marekw1986/InternetRadioPIC32DP83848/TODO.md

# Internet Radio PIC32
Internet radio based on PIC32

### Tasks
- [ ] Write WebUI
  - [x] Write function printing audio files from given directory as json accessed with http server
  - [x] Add funcionality of printing "root" folder
  - [x] Add funcionality of reporting list of available streams
  - [x] Add contextual next button (play next stream or next file in directory)
  - [x] Add aditional info about currently played file or audio stream
  - [x] Add volume control
  - [x] Add option od setting loop flag
  - [ ] Add possibility to save config from web UI
  - [ ] Add reset from web UI
  - [ ] Option of adding streams to list
- [ ] Use busy flag instead delay in HD44780 driver
- [ ] Controll LCD backlight brightness with soft PWM
- [ ] Analyze ICY headers
	- [x] Implement basic funcionality
- [ ] Add RF tuner funcionality
	- [x] Design RF board
	- [ ] Port driver for si4735 chip
	- [ ] Write code responsible for controlling VS1053 line input
	- [ ] Add RF tuner support to LCD UI
	- [ ] Add RF tuner support to Web UI
- [ ] Add Home Assistant MQTT integration.
- [ ] Add support for m3u playlists
- [ ] Determine cause of ocassional failures of HTTP server/WebUI

### Completed Column ✓
- [x] Debug SD card
  - [x] Find out why SD card doesn't work when ENC28J60 is enabled
- [x] Find the reason why transfer from USB is slow, causing choppy playback
- [x] Implement circular buffer for audio data
- [x] Implement memory friendly HTTP header parser
- [x] Update FatFS library to the newest version
- [x] Determine why SPI Flash is so slow
- [x] Move list of streams to file
- [x] Move project from MLA to Harmony libraries
- [x] Add backlight timeout
- [x] Move HD44780 from I2C to GPIO bus
- [x] Determine cause of reset after VS1053_play_dir() call
- [x] Create HD44780 UI
  - [x] Show volume value
  - [x] Show currently played stream/file
  - [x] Create interactive menu
	- [x] Add option to select stream from list
	- [x] Add option to play file from local storage
    - [x] Add option to play entire directory from local storage
    - [x] Add support for back button
    - [x] Add feature to remember last position in dir menu
	- [x] Add option to change playback settings (for example playing in loop)
  - [x] Scrolled text (info about played song/stream)
  - [x] Determine cause of ocassional failures of network connectivity
