marekw1986/InternetRadioPIC32DP83848/hardware/io3.brd

## EAGLE design hardware/io3.brd (2025-08-22)

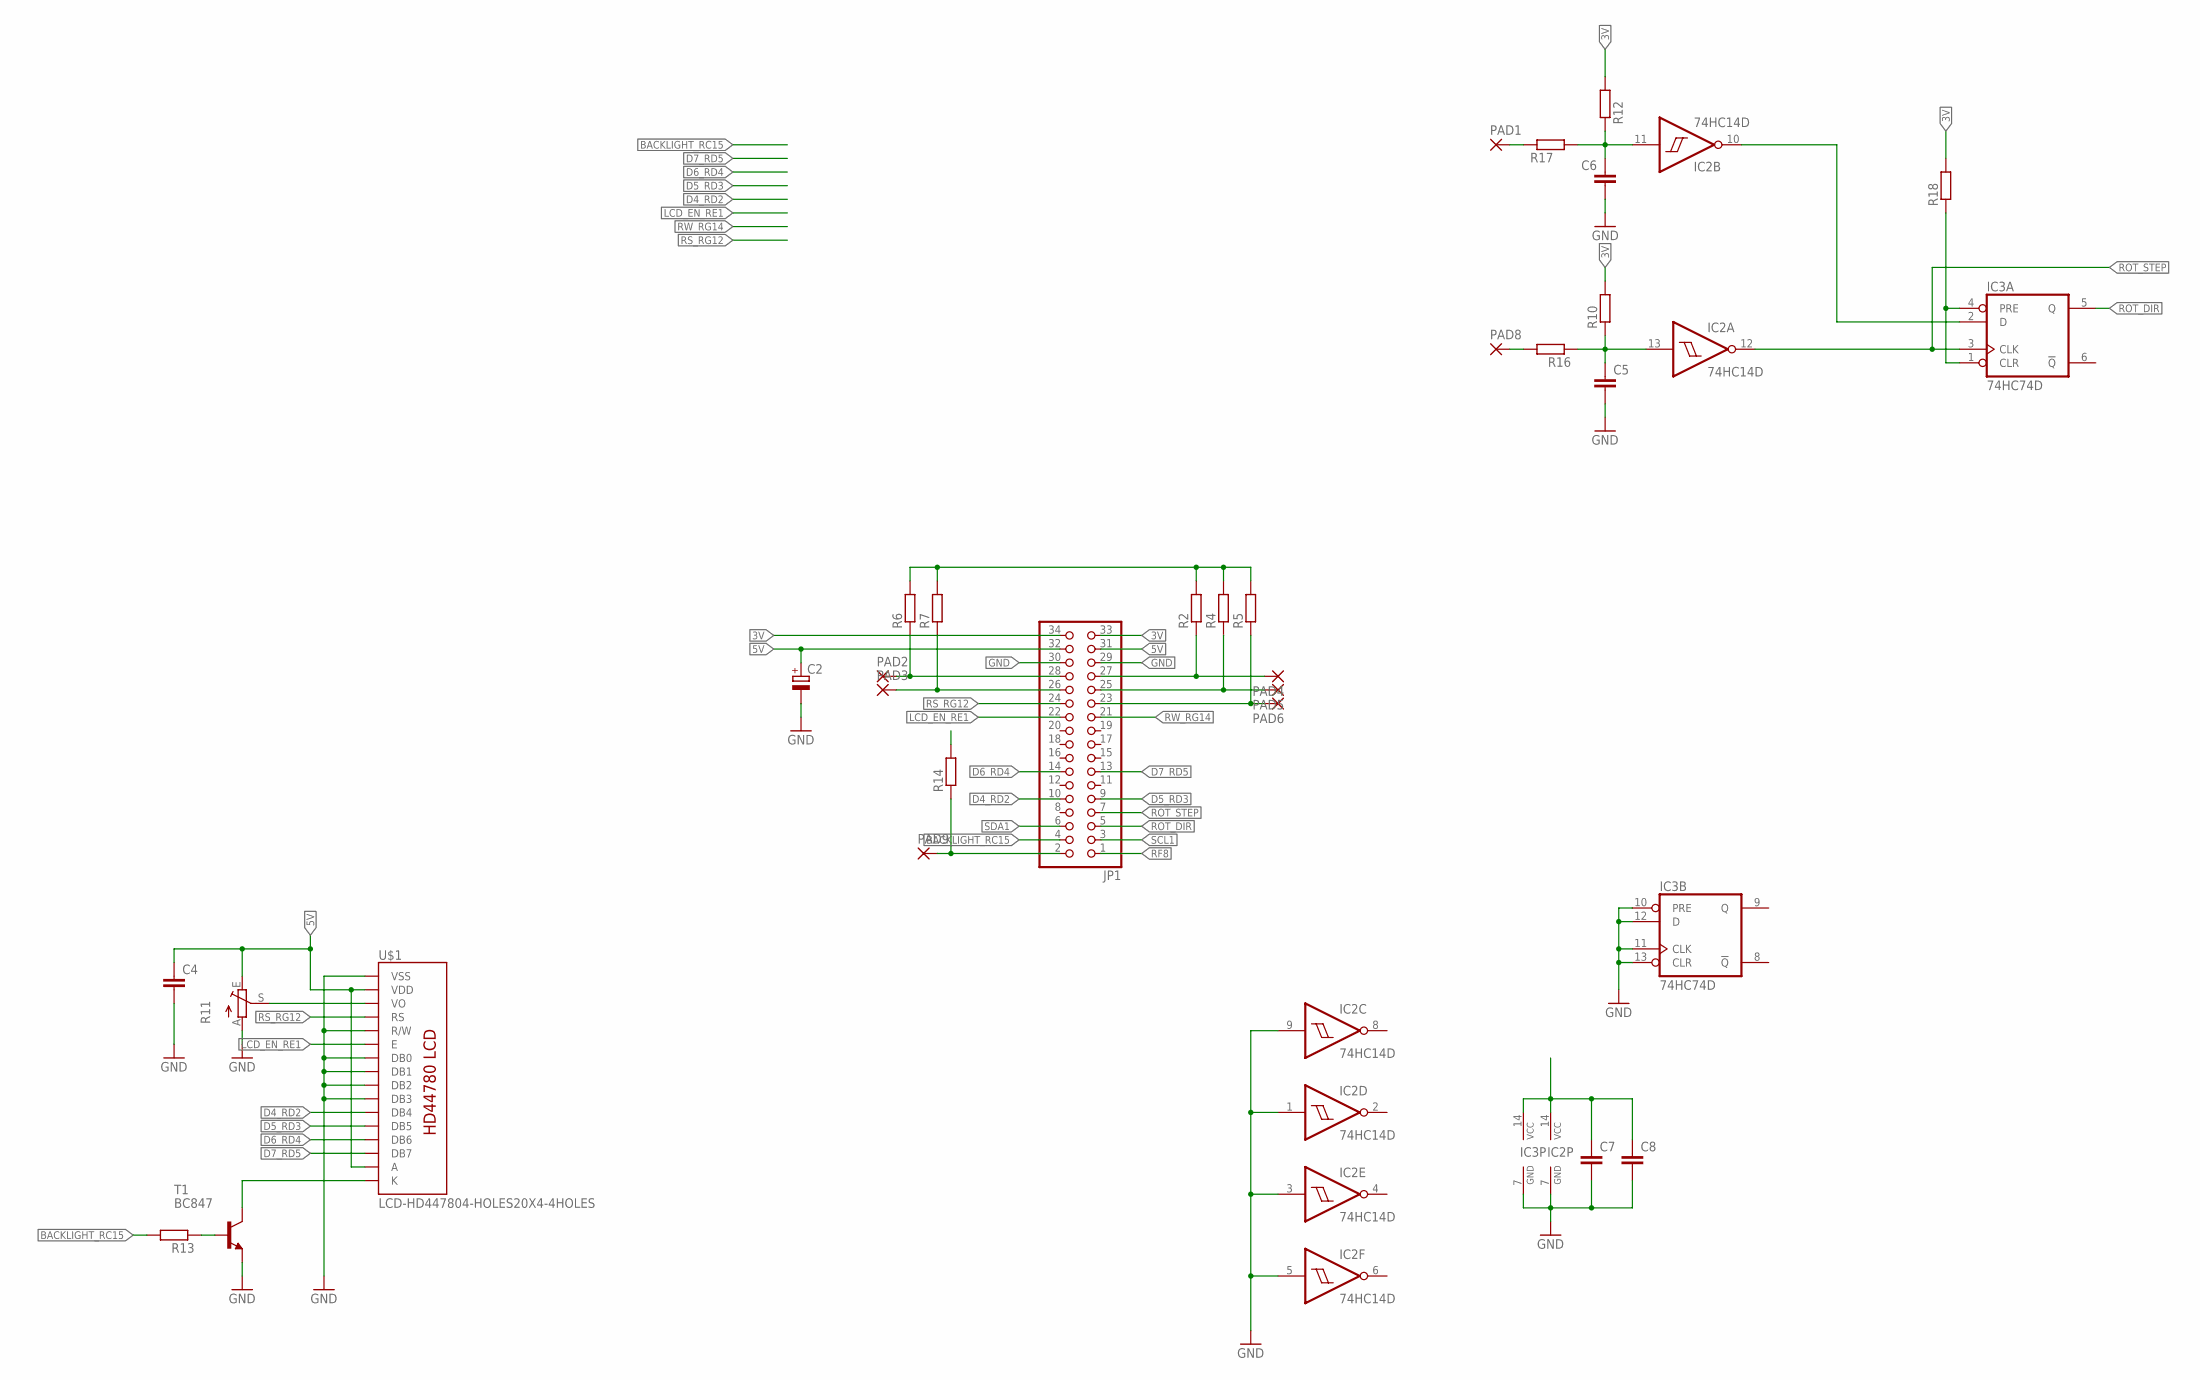
[picture p1: schematic io3.sch]

Parts:
C2: CPOL-EUSMCD; SMC_D
C4: C-EUC1206; C1206
C5, C6, C7, C8: C-EUC0603; C0603
IC2: 74HC14D; SO14
IC3: 74HC74D; SO14
JP1: PINHD-2X17_2.54-SMD; 2X17SMD
PAD1, PAD2, PAD3, PAD4, PAD5, PAD6, PAD8, PAD9: SMD2; SMD1,27-2,54
R2, R4, R5, R6, R7, R10, R12, R18: R-EU_0204/7; 0204/7
R11: TRIM_EU-B25U; B25U
R13, R14: R-EU_0204/5; 0204/5
R16, R17: R-EU_R0603; R0603
T1: BC847; SOT23
U$1: LCD-HD447804-HOLES20X4-4HOLES; LCD-20X4-4HOLES

Connections:
3V: C7.1, C8.1, IC2.14 (VCC), IC3.14 (VCC), JP1.33, JP1.34, R2.2, R4.2, R5.2, R6.2, R7.2, R10.2, R12.2, R14.2, R18.2
5V: C2.+, C4.1, JP1.31, JP1.32, R11.E, U$1.P$2 (VDD), U$1.P$15 (A)
BACKLIGHT_RC15: JP1.4, R13.2
D4_RD2: JP1.10, U$1.P$11 (DB4)
D5_RD3: JP1.9, U$1.P$12 (DB5)
D6_RD4: JP1.14, U$1.P$13 (DB6)
D7_RD5: JP1.13, U$1.P$14 (DB7)
GND: C2.-, C4.2, C5.2, C6.2, C7.2, C8.2, IC2.1 (I), IC2.3 (I), IC2.5 (I), IC2.7 (GND), IC2.9 (I), IC3.7 (GND), IC3.10 (PRE), IC3.11 (CLK), IC3.12 (D), IC3.13 (CLR), JP1.29, JP1.30, R11.A, T1.2 (E), U$1.P$1 (VSS), U$1.P$5 (R/W), U$1.P$7 (DB0), U$1.P$8 (DB1), U$1.P$9 (DB2), U$1.P$10 (DB3)
LCD_EN_RE1: JP1.22, U$1.P$6 (E)
unnamed: T1.3 (C), U$1.P$16 (K)
unnamed: IC3.1 (CLR), IC3.4 (PRE), R18.1
unnamed: PAD8.1, R16.2
unnamed: R13.1, T1.1 (B)
unnamed: PAD1.1, R17.1
unnamed: R11.S, U$1.P$3 (VO)
RF8: JP1.1
ROT_A_DT: C5.1, IC2.13 (I), R10.1, R16.1
ROT_B_: IC2.10 (O), IC3.2 (D)
ROT_B_CLK: C6.1, IC2.11 (I), R12.1, R17.2
ROT_DIR: IC3.5 (Q), JP1.5
ROT_STEP: IC2.12 (O), IC3.3 (CLK), JP1.7
ROT_SW: JP1.2, PAD9.1, R14.1
RS_RG12: JP1.24, U$1.P$4 (RS)
RW_RG14: JP1.21
S1: JP1.27, PAD4.1, R2.1
S2: JP1.28, PAD2.1, R6.1
S3: JP1.25, PAD5.1, R4.1
S4: JP1.26, PAD3.1, R7.1
S5: JP1.23, PAD6.1, R5.1
SCL1: JP1.3
SDA1: JP1.6

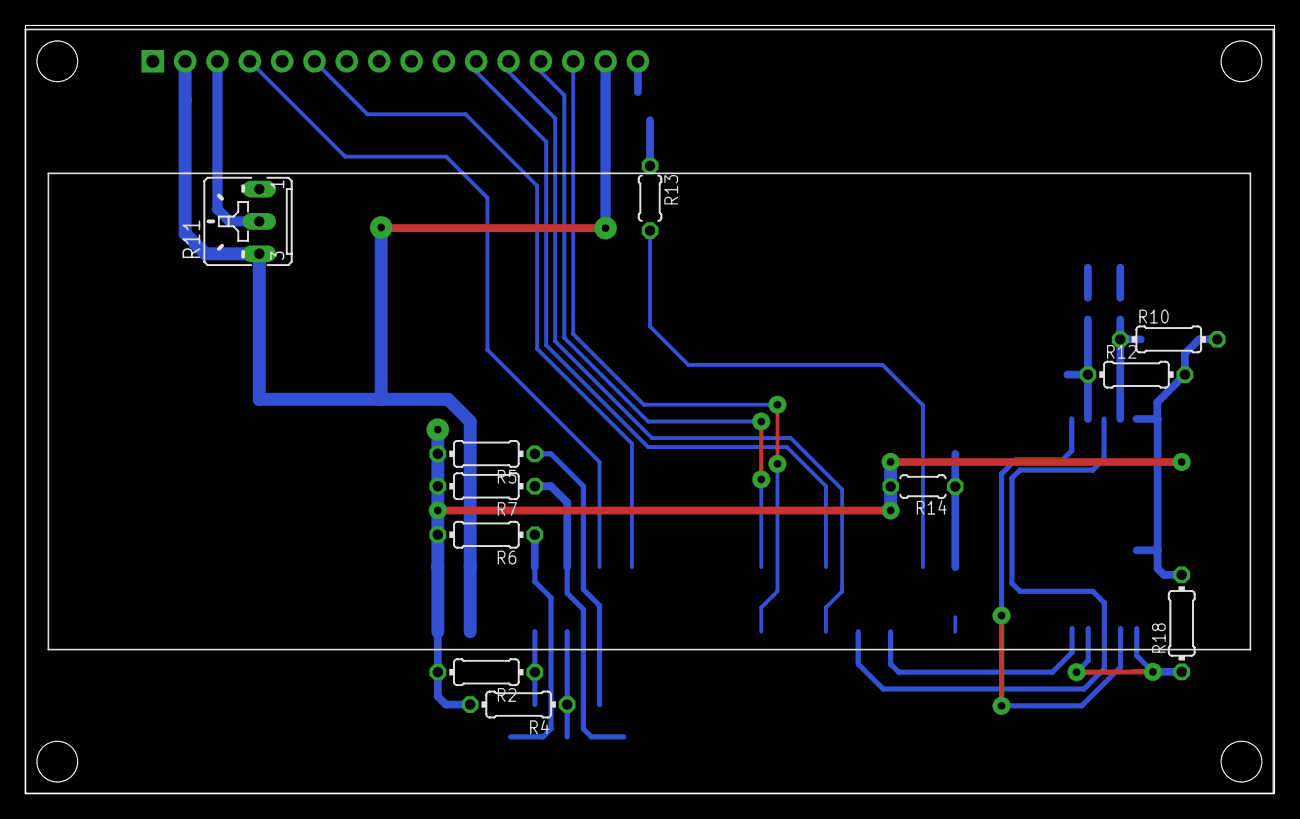
[picture p2: board io3.brd from above]

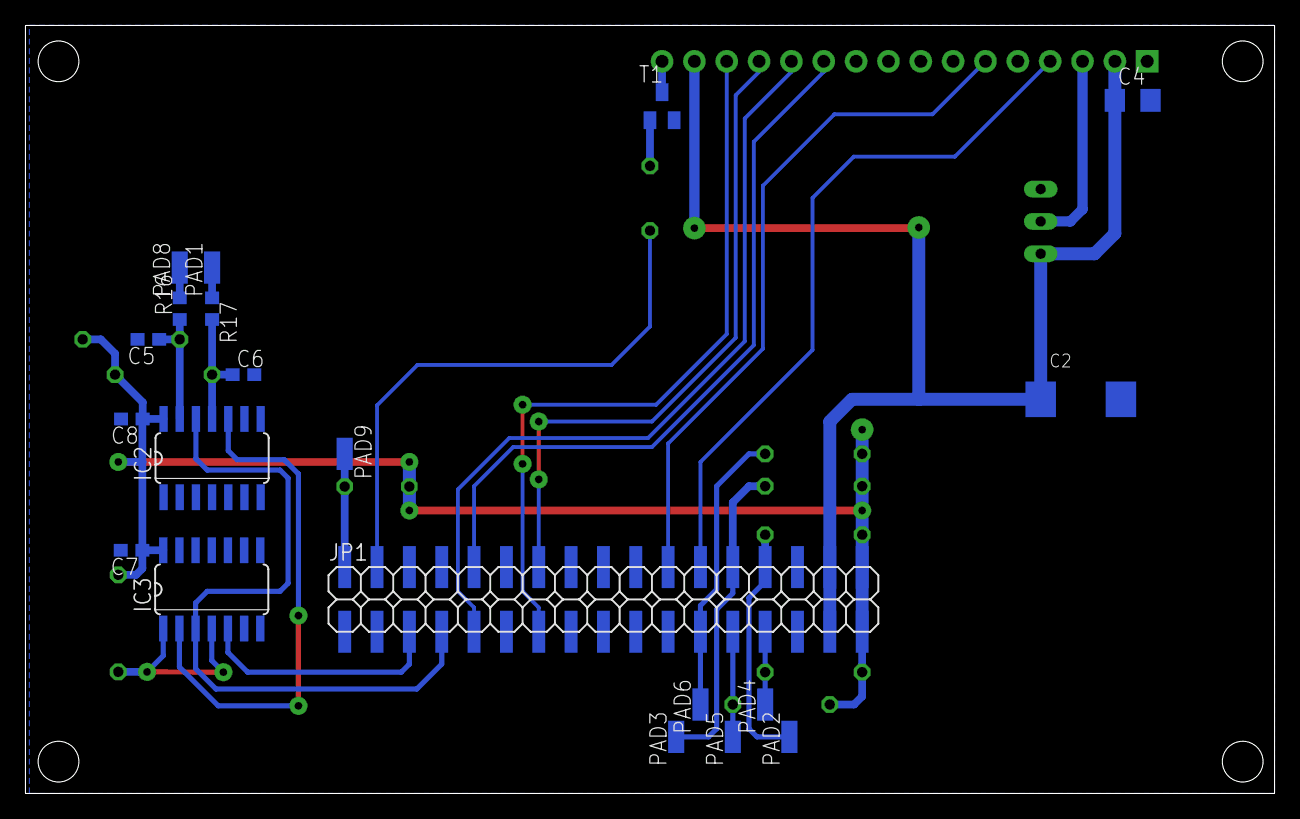
[picture p3: board io3.brd from below]

Board: 2 copper layers, 98.1 x 60.3 mm, 32 parts (20 on the bottom side), 27 nets.
