marekw1986/InternetRadioPIC32DP83848/hardware/rf_board.brd

## EAGLE design hardware/rf_board.brd (2025-08-22)

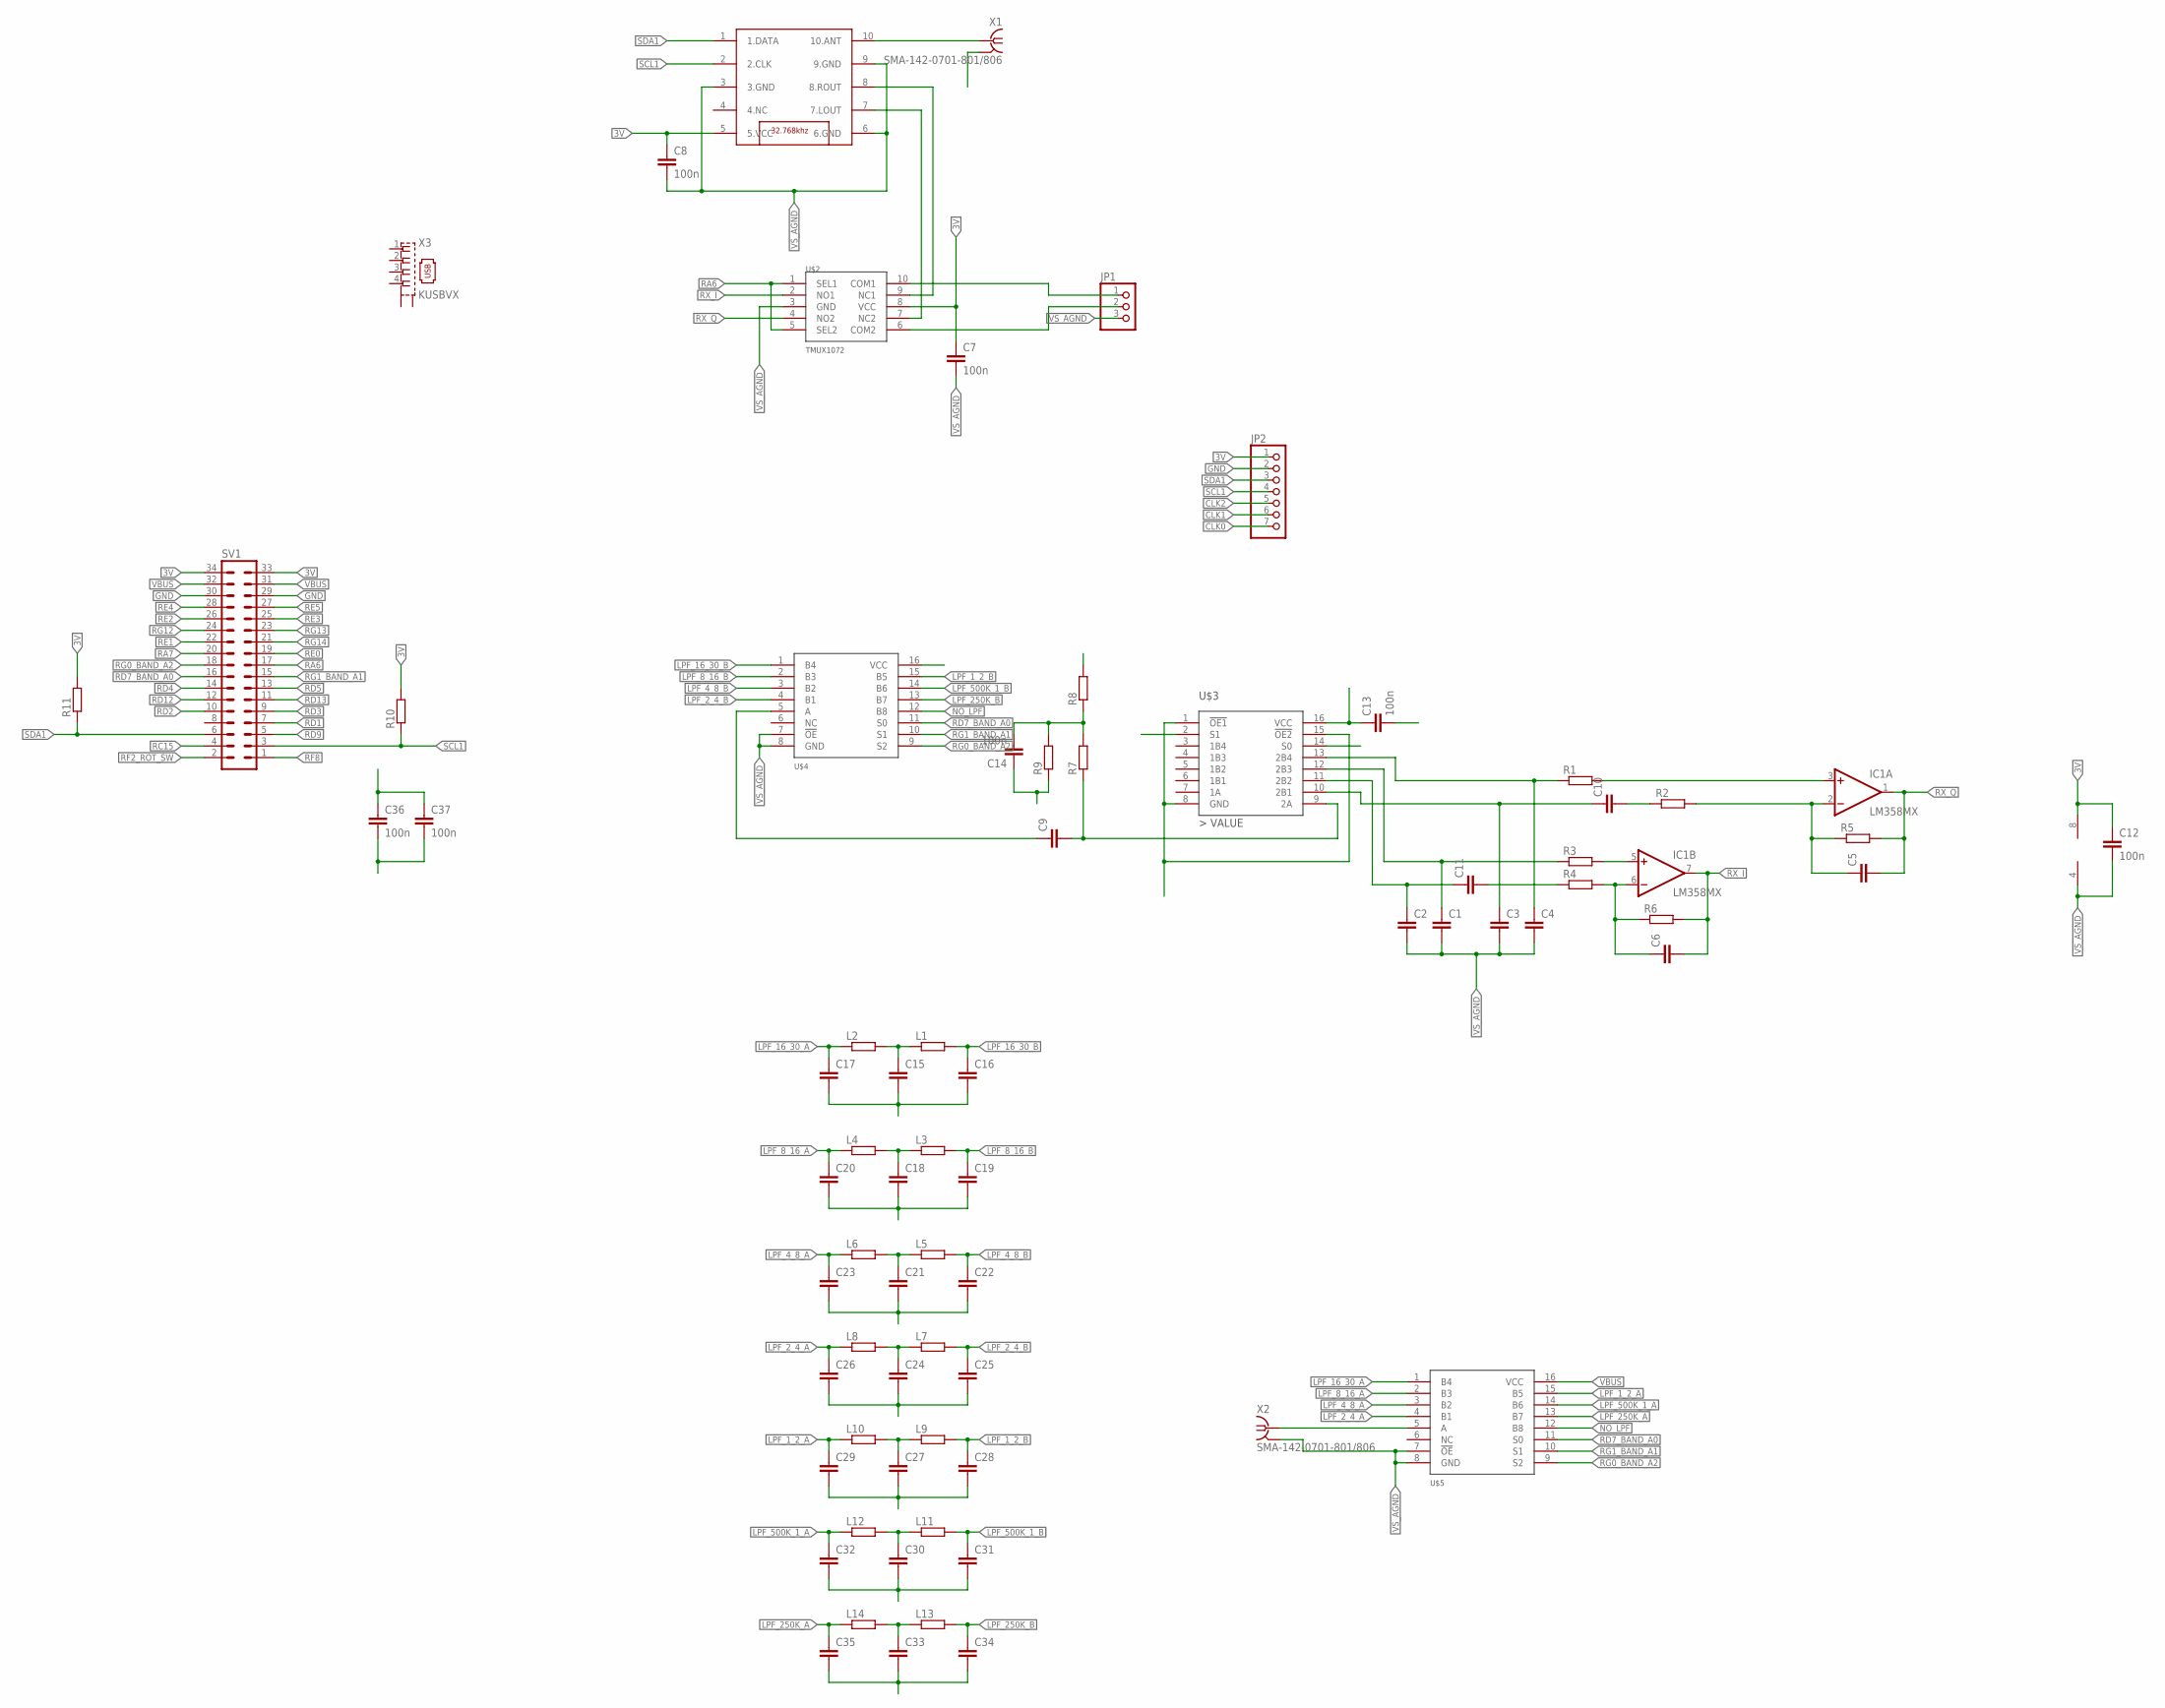
[picture p10: schematic rf_board.sch]

Parts:
C1, C2, C3, C4, C5, C6, C9, C10, C11: C-EUC0603; C0603
C7: 100n; C1206
C8, C12, C13, C14, C36, C37: 100n; C0603
C15, C16, C17, C18, C19, C20, C21, C22, C23, C24, C25, C26, C27, C28, C29, C30, C31, C32, C33, C34, C35: C-EUC0805; C0805
IC1: LM358MX; SO08
JP1: PINHD-1X3; 1X03
JP2: PINHD-1X7; 1X07
L1, L2, L3, L4, L5, L6, L7, L8, L9, L10, L11, L12, L13, L14: R-EU_R0805; R0805
R1, R2, R3, R4, R5, R6, R8, R9: R-EU_R0603; R0603
R7, R11: R-EU_0204/5; 0204/5
R10: R-EU_0204/7; 0204/7
SV1: ML34L
U$1: TEA5767; TJ-102BC
U$2: TMUX1072; TSSOP8
U$3: FST3253SO16; SO16
U$4, U$5: SN74CBT3251; TSSOP16
X1, X2: SMA-142-0701-801/806; J502-ND-142-0701-801/806
X3: KUSBVX

Connections:
3V: C7.1, C8.1, C12.1, C13.1, IC1.8 (V+), JP2.1, R8.2, R10.2, R11.2, SV1.33, SV1.34, U$1.5 (5.VCC), U$2.8 (VCC), U$3.16 (VCC)
CLK0: JP2.7, U$3.14 (S0)
CLK1: JP2.6, U$3.2 (S1)
CLK2: JP2.5
GND: JP2.2, SV1.29, SV1.30
IN_LEFT: JP1.2, U$2.6 (COM2)
IN_RIGHT: JP1.1, U$2.10 (COM1)
LPF_1_2_A: C29.1, L10.1, U$5.15 (B5)
LPF_1_2_B: C28.1, L9.2, U$4.15 (B5)
LPF_2_4_A: C26.1, L8.1, U$5.4 (B1)
LPF_2_4_B: C25.1, L7.2, U$4.4 (B1)
LPF_4_8_A: C23.1, L6.1, U$5.3 (B2)
LPF_4_8_B: C22.1, L5.2, U$4.3 (B2)
LPF_8_16_A: C20.1, L4.1, U$5.2 (B3)
LPF_8_16_B: C19.1, L3.2, U$4.2 (B3)
LPF_16_30_A: C17.1, L2.1, U$5.1 (B4)
LPF_16_30_B: C16.1, L1.2, U$4.1 (B4)
LPF_250K_A: C35.1, L14.1, U$5.13 (B7)
LPF_250K_B: C34.1, L13.2, U$4.13 (B7)
LPF_500K_1_A: C32.1, L12.1, U$5.14 (B6)
LPF_500K_1_B: C31.1, L11.2, U$4.14 (B6)
unnamed: IC1.3 (+IN), R1.2
unnamed: C3.1, C10.1, U$3.10 (2B1)
unnamed: C4.1, R1.1, U$3.13 (2B4)
unnamed: C1.1, R3.1, U$3.12 (2B3)
unnamed: C2.1, C11.1, U$3.11 (2B2)
unnamed: C5.1, IC1.2 (-IN), R2.2, R5.1
unnamed: IC1.5 (+IN), R3.2
unnamed: C6.1, IC1.6 (-IN), R4.2, R6.1
unnamed: C9.2, R7.1, U$3.9 (2A)
unnamed: U$1.8 (8.ROUT), U$2.9 (NC1)
unnamed: U$1.7 (7.LOUT), U$2.7 (NC2)
unnamed: C10.2, R2.1
unnamed: C11.2, R4.1
unnamed: C14.2, R7.2, R8.1, R9.2
unnamed: C15.1, L1.1, L2.2
unnamed: U$5.5 (A), X2.1
unnamed: U$1.10 (10.ANT), X1.1
unnamed: C18.1, L3.1, L4.2
unnamed: C21.1, L5.1, L6.2
unnamed: C24.1, L7.1, L8.2
unnamed: C27.1, L9.1, L10.2
unnamed: C30.1, L11.1, L12.2
unnamed: C33.1, L13.1, L14.2
unnamed: C9.1, U$4.5 (A)
NO_LPF: U$4.12 (B8), U$5.12 (B8)
RA6: SV1.17, U$2.1 (SEL1), U$2.5 (SEL2)
RA7: SV1.20
RC15: SV1.4
RD1: SV1.7
RD2: SV1.10
RD3: SV1.9
RD4: SV1.14
RD5: SV1.13
RD7_BAND_A0: SV1.16, U$4.11 (S0), U$5.11 (S0)
RD9: SV1.5
RD12: SV1.12
RD13: SV1.11
RE0: SV1.19
RE1: SV1.22
RE2: SV1.26
RE3: SV1.25
RE4: SV1.28
RE5: SV1.27
RF2_ROT_SW: SV1.2
RF8: SV1.1
RG0_BAND_A2: SV1.18, U$4.9 (S2), U$5.9 (S2)
RG1_BAND_A1: SV1.15, U$4.10 (S1), U$5.10 (S1)
RG12: SV1.24
RG13: SV1.23
RG14: SV1.21
RX_I: C6.2, IC1.7 (OUT), R6.2, U$2.2 (NO1)
RX_Q: C5.2, IC1.1 (OUT), R5.2, U$2.4 (NO2)
SCL1: JP2.4, R10.1, SV1.3, U$1.2 (2.CLK)
SDA1: JP2.3, R11.1, SV1.6, U$1.1 (1.DATA)
VBUS: C36.1, C37.1, SV1.31, SV1.32, U$4.16 (VCC), U$5.16 (VCC)
VS_AGND: C1.2, C2.2, C3.2, C4.2, C7.2, C8.2, C12.2, C13.2, C14.1, C15.2, C16.2, C17.2, C18.2, C19.2, C20.2, C21.2, C22.2, C23.2, C24.2, C25.2, C26.2, C27.2, C28.2, C29.2, C30.2, C31.2, C32.2, C33.2, C34.2, C35.2, C36.2, C37.2, IC1.4 (V-), JP1.3, R9.1, U$1.3 (3.GND), U$1.6 (6.GND), U$1.9 (9.GND), U$2.3 (GND), U$3.1 (!OE1), U$3.8 (GND), U$3.15 (!OE2), U$4.7 (!OE), U$4.8 (GND), U$5.7 (!OE), U$5.8 (GND), X1.G@1 (2), X1.G@2 (2), X1.G@3 (2), X1.G@4 (2), X2.G@1 (2), X2.G@2 (2), X2.G@3 (2), X2.G@4 (2)

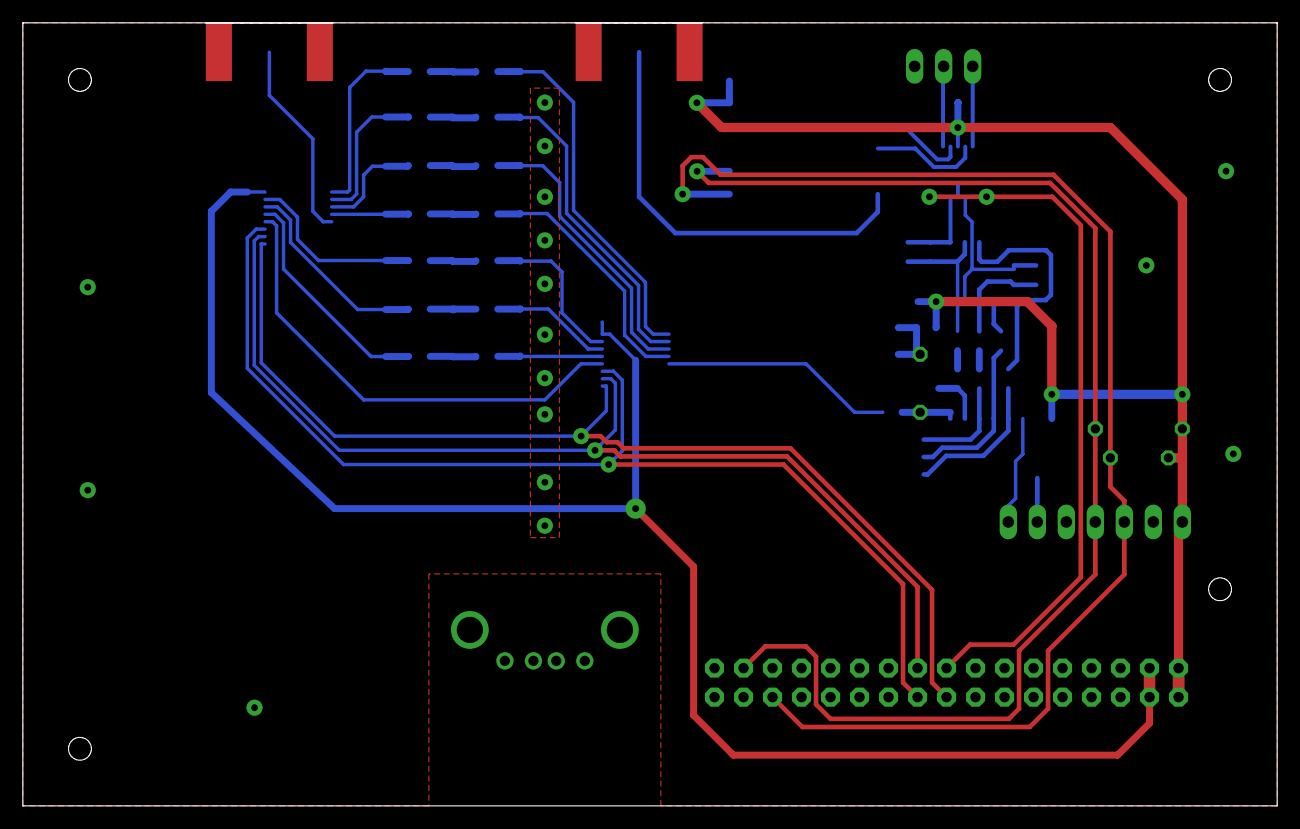
[picture p11: board rf_board.brd from above]

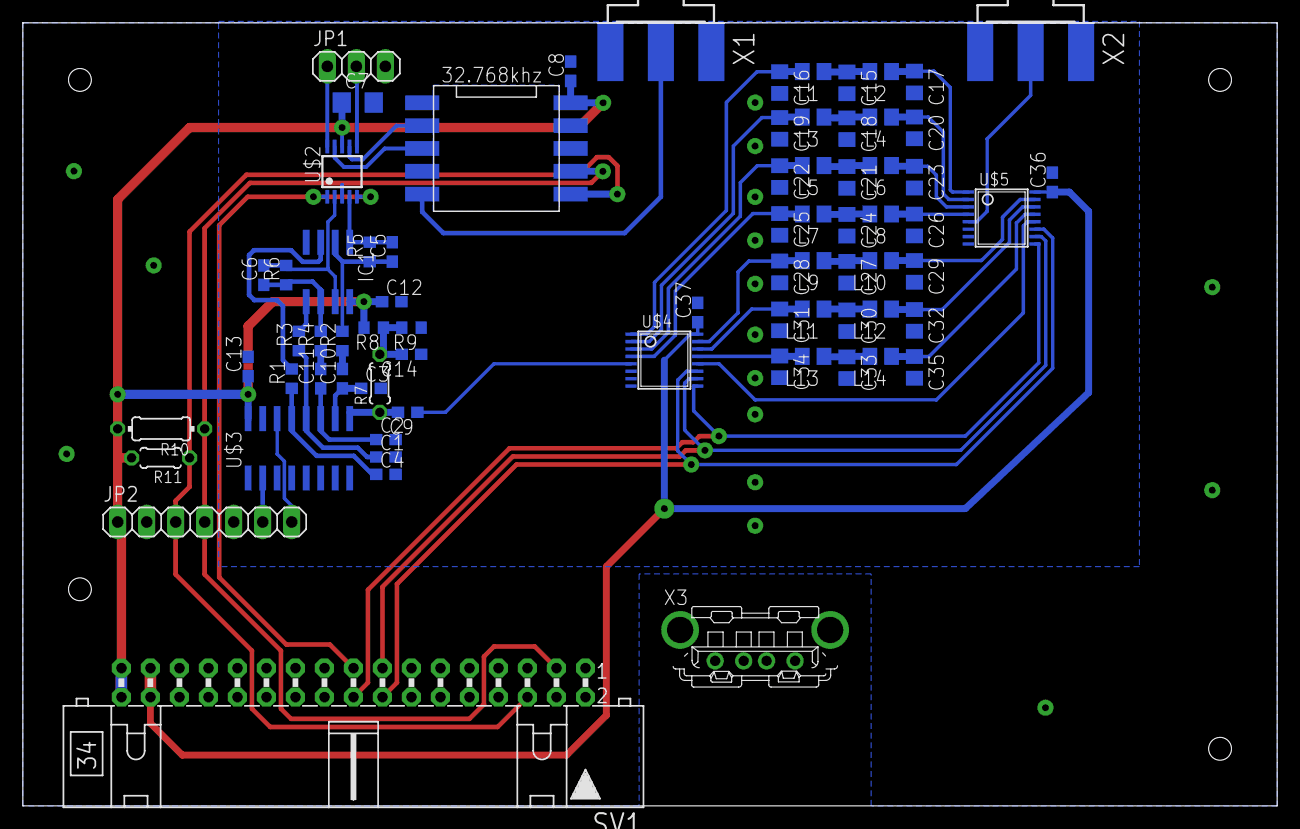
[picture p12: board rf_board.brd from below]

Board: 2 copper layers, 109.9 x 68.6 mm, 74 parts (74 on the bottom side), 55 nets.
