marekw1986/InternetRadioPIC32DP83848/hardware/io.brd

## EAGLE design hardware/io.brd (2021-02-01)

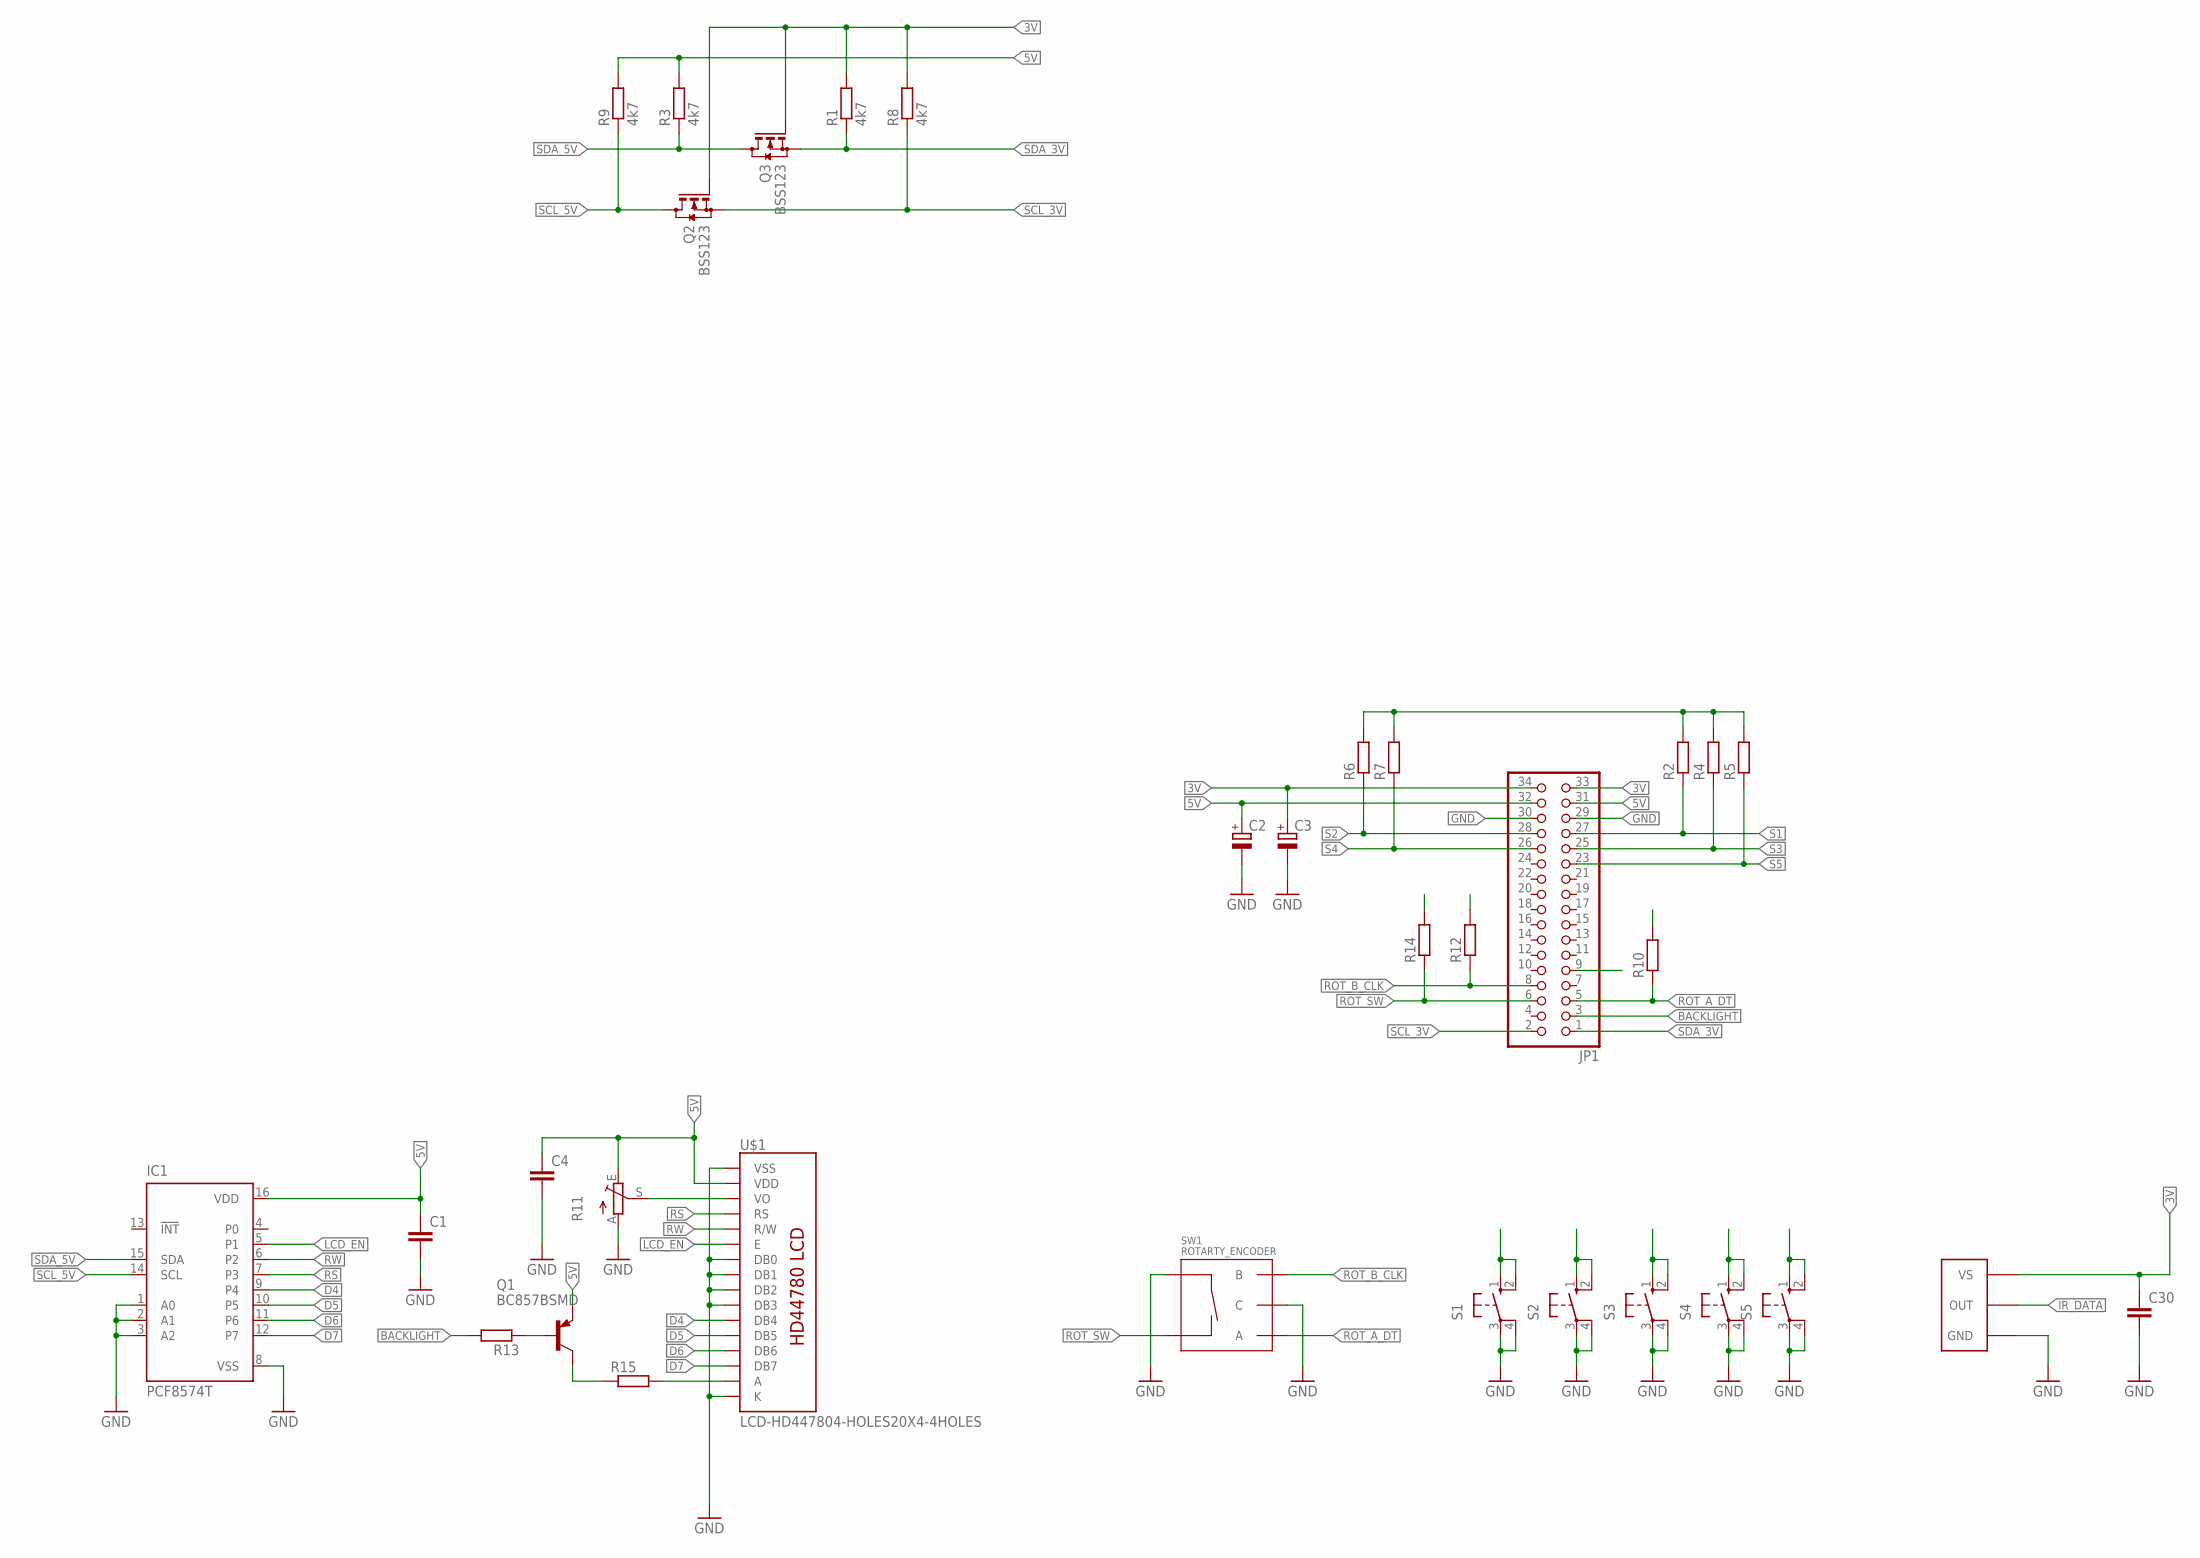
[picture p13: schematic io.sch]

Parts:
C1: C-EUC0603; C0603
C2: CPOL-EUSMCD; SMC_D
C3: CPOL-EUSMCB; SMC_B
C4, C30: C-EUC1206; C1206
IC1: PCF8574T; SO16W
JP1: PINHD-2X17_2.54-SMD; 2X17SMD
Q1: BC857BSMD; SOT23-BEC
Q2, Q3: BSS123; SOT23
R1, R3, R8, R9: 4k7; R0603
R2, R4, R5, R6, R7, R10, R12, R13, R14: R-EU_0204/7; 0204/7
R11: TRIM_EU-B25U; B25U
R15: R-EU_R0603; R0603
S1, S2, S3, S4, S5: 40-XX; B3F-40XX
SW1: ROTARTY_ENCODER; ROTARY_ENC_PLAIN
U$1: LCD-HD447804-HOLES20X4-4HOLES; LCD-20X4-4HOLES
U$5: TSOP312XVERTICAL; TSOP312X_VERT

Connections:
3V: C3.+, C30.1, JP1.33, JP1.34, Q2.1 (G), Q3.1 (G), R1.2, R2.2, R4.2, R5.2, R6.2, R7.2, R8.2, R10.2, R12.2, R14.2, U$5.2 (VS)
5V: C1.1, C2.+, C4.1, IC1.16 (VDD), JP1.31, JP1.32, Q1.E, R3.2, R9.2, R11.E, U$1.P$2 (VDD)
BACKLIGHT: JP1.3, R13.2
D4: IC1.9 (P4), U$1.P$11 (DB4)
D5: IC1.10 (P5), U$1.P$12 (DB5)
D6: IC1.11 (P6), U$1.P$13 (DB6)
D7: IC1.12 (P7), U$1.P$14 (DB7)
GND: C1.2, C2.-, C3.-, C4.2, C30.2, IC1.1 (A0), IC1.2 (A1), IC1.3 (A2), IC1.8 (VSS), JP1.29, JP1.30, R11.A, S1.3, S1.4 (P1), S2.3, S2.4 (P1), S3.3, S3.4 (P1), S4.3, S4.4 (P1), S5.3, S5.4 (P1), SW1.C, SW1.SW+, U$1.P$1 (VSS), U$1.P$7 (DB0), U$1.P$8 (DB1), U$1.P$9 (DB2), U$1.P$10 (DB3), U$1.P$16 (K), U$5.1 (GND)
IR_DATA: JP1.9, U$5.3 (OUT)
LCD_EN: IC1.5 (P1), U$1.P$6 (E)
unnamed: Q1.C, R15.1
unnamed: R15.2, U$1.P$15 (A)
unnamed: Q1.B, R13.1
unnamed: R11.S, U$1.P$3 (VO)
ROT_A_DT: JP1.5, R10.1, SW1.A
ROT_B_CLK: JP1.8, R12.1, SW1.B
ROT_SW: JP1.6, R14.1, SW1.SW-
RS: IC1.7 (P3), U$1.P$4 (RS)
RW: IC1.6 (P2), U$1.P$5 (R/W)
S1: JP1.27, R2.1, S1.1 (S), S1.2 (S1)
S2: JP1.28, R6.1, S2.1 (S), S2.2 (S1)
S3: JP1.25, R4.1, S3.1 (S), S3.2 (S1)
S4: JP1.26, R7.1, S4.1 (S), S4.2 (S1)
S5: JP1.23, R5.1, S5.1 (S), S5.2 (S1)
SCL_3V: JP1.2, Q2.2 (S), R8.1
SCL_5V: IC1.14 (SCL), Q2.3 (D), R9.1
SDA_3V: JP1.1, Q3.2 (S), R1.1
SDA_5V: IC1.15 (SDA), Q3.3 (D), R3.1

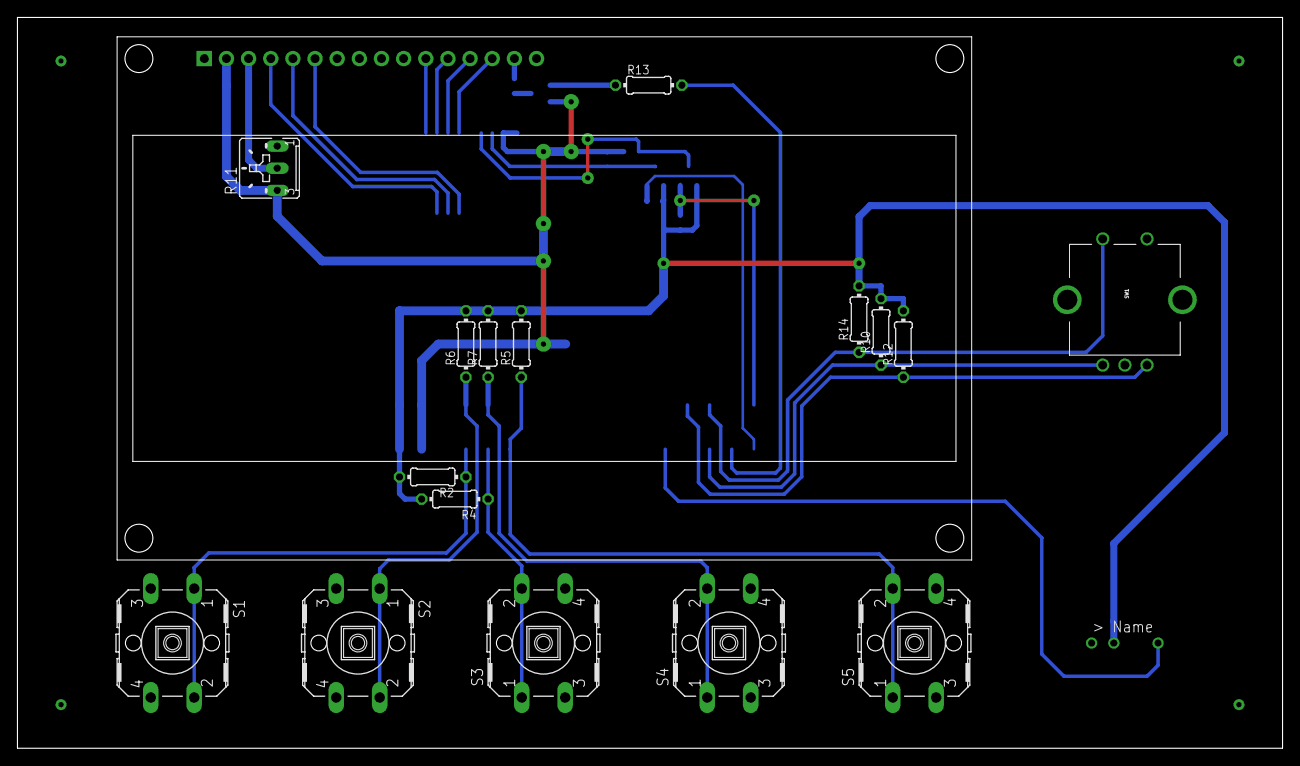
[picture p14: board io.brd from above]

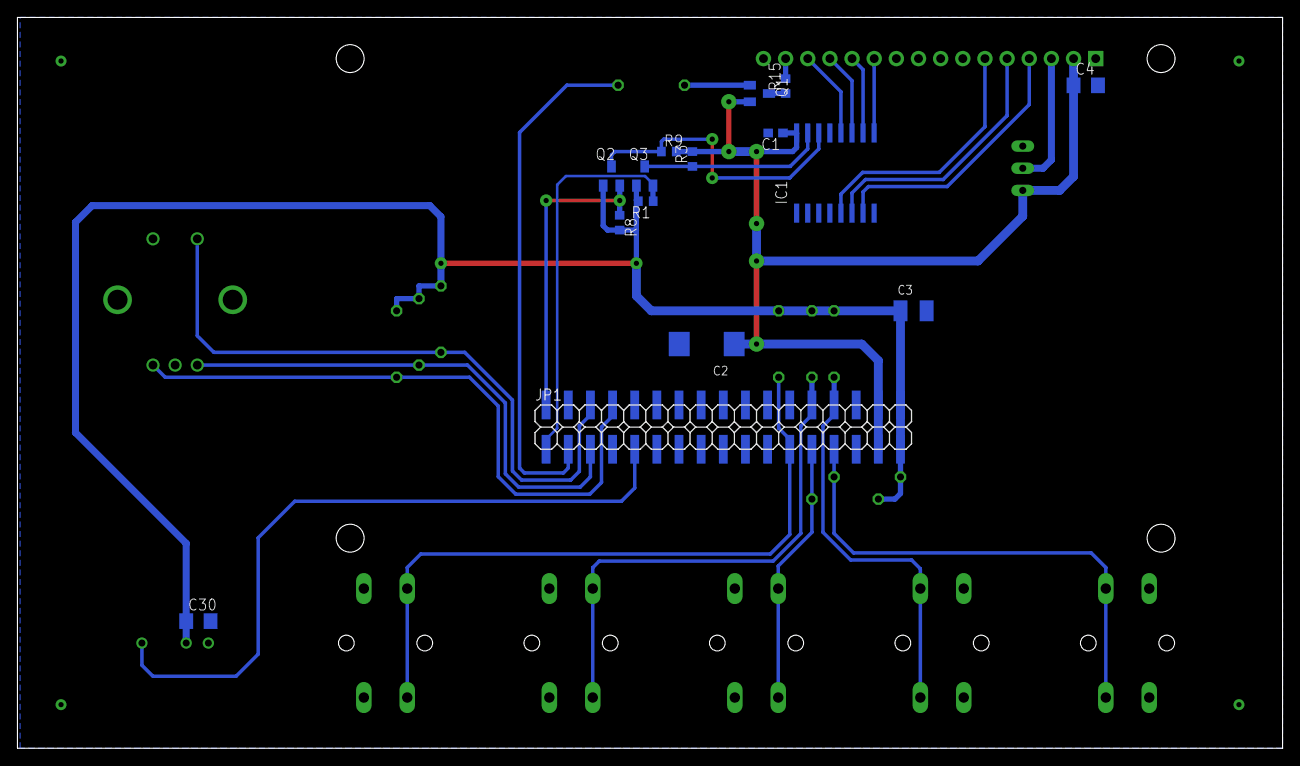
[picture p15: board io.brd from below]

Board: 2 copper layers, 145.1 x 83.8 mm, 33 parts (15 on the bottom side), 28 nets.
