marekw1986/InternetRadioPIC32DP83848/firmware/src/config/default/default.mhc/project.yml

files:
- generatedChecksum: E4894B6355AF41AED546E4C6C20005C1
  logicalPath: FreeRTOS/Source
  name: FreeRTOS_tasks.c
  physicalPath: ../../third_party/rtos/FreeRTOS/Source
  security: NON_SECURE
  type: SOURCE
  userChecksum: E4894B6355AF41AED546E4C6C20005C1
- generatedChecksum: null
  logicalPath: ''
  name: app.c
  physicalPath: ../..
  security: NON_SECURE
  type: SOURCE
  userChecksum: null
- generatedChecksum: 69ACFE71788887938F64DDAD1C50B6B7
  logicalPath: ''
  name: app_mqtt_task.c
  physicalPath: ../..
  security: NON_SECURE
  type: SOURCE
  userChecksum: 69ACFE71788887938F64DDAD1C50B6B7
- generatedChecksum: 19E6E92AA768F57902FD49EEEA8938EA
  logicalPath: config/default/library/tcpip/src
  name: arp.c
  physicalPath: library/tcpip/src
  security: NON_SECURE
  type: SOURCE
  userChecksum: 19E6E92AA768F57902FD49EEEA8938EA
- generatedChecksum: 4490B523D4D89767AF3FE31B825F7F6D
  logicalPath: FreeRTOS/Source
  name: croutine.c
  physicalPath: ../../third_party/rtos/FreeRTOS/Source
  security: NON_SECURE
  type: SOURCE
  userChecksum: 4490B523D4D89767AF3FE31B825F7F6D
- generatedChecksum: 412F30E1E173E8BB91C29F79DACCAF97
  logicalPath: config/default/library/tcpip/src
  name: dhcp.c
  physicalPath: library/tcpip/src
  security: NON_SECURE
  type: SOURCE
  userChecksum: 412F30E1E173E8BB91C29F79DACCAF97
- generatedChecksum: 4F1E691F70878F4E114F5C6BDB4BD606
  logicalPath: config/default/system/fs/fat_fs/hardware_access
  name: diskio.c
  physicalPath: system/fs/fat_fs/hardware_access
  security: NON_SECURE
  type: SOURCE
  userChecksum: 4F1E691F70878F4E114F5C6BDB4BD606
- generatedChecksum: 75776948807707C602A3F619A74C3891
  logicalPath: config/default/library/tcpip/src
  name: dns.c
  physicalPath: library/tcpip/src
  security: NON_SECURE
  type: SOURCE
  userChecksum: 75776948807707C602A3F619A74C3891
- generatedChecksum: 50C9CA1383E0E4B0DA319164E5A1F323
  logicalPath: config/default/driver/ethmac/src/dynamic
  name: drv_eth_pic32_lib.c
  physicalPath: driver/ethmac/src/dynamic
  security: NON_SECURE
  type: SOURCE
  userChecksum: 50C9CA1383E0E4B0DA319164E5A1F323
- generatedChecksum: CC2D2C54ABED6F819D5B6F8D5942E053
  logicalPath: config/default/driver/ethmac/src/dynamic
  name: drv_ethmac.c
  physicalPath: driver/ethmac/src/dynamic
  security: NON_SECURE
  type: SOURCE
  userChecksum: CC2D2C54ABED6F819D5B6F8D5942E053
- generatedChecksum: 81B10C326914EA1B617DB901324BB623
  logicalPath: config/default/driver/ethmac/src/dynamic
  name: drv_ethmac_lib.c
  physicalPath: driver/ethmac/src/dynamic
  security: NON_SECURE
  type: SOURCE
  userChecksum: 81B10C326914EA1B617DB901324BB623
- generatedChecksum: B109B8C068C2859E896D338043B22882
  logicalPath: config/default/driver/ethphy/src/dynamic
  name: drv_ethphy.c
  physicalPath: driver/ethphy/src/dynamic
  security: NON_SECURE
  type: SOURCE
  userChecksum: B109B8C068C2859E896D338043B22882
- generatedChecksum: 9CF18895B25024EB9296E5FF70E9824A
  logicalPath: config/default/driver/ethphy/src/dynamic
  name: drv_extphy_dp83848.c
  physicalPath: driver/ethphy/src/dynamic
  security: NON_SECURE
  type: SOURCE
  userChecksum: 9CF18895B25024EB9296E5FF70E9824A
- generatedChecksum: 0E1B1E293A2B25711C143C917406BA0E
  logicalPath: config/default/driver/miim/src/dynamic
  name: drv_miim.c
  physicalPath: driver/miim/src/dynamic
  security: NON_SECURE
  type: SOURCE
  userChecksum: 0E1B1E293A2B25711C143C917406BA0E
- generatedChecksum: 427F039BA29DD24D1F86717825DDB529
  logicalPath: config/default/driver/sdspi
  name: drv_sdspi.c
  physicalPath: driver/sdspi/src
  security: NON_SECURE
  type: SOURCE
  userChecksum: 427F039BA29DD24D1F86717825DDB529
- generatedChecksum: 5AACCF15409118FEF340B66AB93688EC
  logicalPath: config/default/driver/sdspi
  name: drv_sdspi_driver_interface.c
  physicalPath: driver/sdspi/src
  security: NON_SECURE
  type: SOURCE
  userChecksum: 5AACCF15409118FEF340B66AB93688EC
- generatedChecksum: 997ACCDD95519138D9B4922484450937
  logicalPath: config/default/driver/sdspi
  name: drv_sdspi_file_system.c
  physicalPath: driver/sdspi/src
  security: NON_SECURE
  type: SOURCE
  userChecksum: 997ACCDD95519138D9B4922484450937
- generatedChecksum: 6B2BB2DA350060EEA524E05A745767CD
  logicalPath: config/default/driver/spi
  name: drv_spi.c
  physicalPath: driver/spi/src
  security: NON_SECURE
  type: SOURCE
  userChecksum: 6B2BB2DA350060EEA524E05A745767CD
- generatedChecksum: 8EE3C59DE773C498338576FD5853D4E6
  logicalPath: config/default/driver/spi
  name: drv_spi_local.h
  physicalPath: driver/spi/src
  security: NON_SECURE
  type: SOURCE
  userChecksum: 8EE3C59DE773C498338576FD5853D4E6
- generatedChecksum: E8A25523C8CDDC97F3FD108E97BF4A9F
  logicalPath: config/default/driver/usb/usbfs/src
  name: drv_usbfs.c
  physicalPath: driver/usb/usbfs/src
  security: NON_SECURE
  type: SOURCE
  userChecksum: E8A25523C8CDDC97F3FD108E97BF4A9F
- generatedChecksum: A807A88CE177C0AF06553EFF3582885E
  logicalPath: config/default/driver/usb/usbfs/src
  name: drv_usbfs_host.c
  physicalPath: driver/usb/usbfs/src
  security: NON_SECURE
  type: SOURCE
  userChecksum: A807A88CE177C0AF06553EFF3582885E
- generatedChecksum: 0E0E8AECB67046FEA847B359ACE7A1F6
  logicalPath: FreeRTOS/Source
  name: event_groups.c
  physicalPath: ../../third_party/rtos/FreeRTOS/Source
  security: NON_SECURE
  type: SOURCE
  userChecksum: 0E0E8AECB67046FEA847B359ACE7A1F6
- generatedChecksum: 4BBDE3B7B0DAEE2CA5A8F519001D5BFF
  logicalPath: config/default
  name: exceptions.c
  physicalPath: ''
  security: NON_SECURE
  type: SOURCE
  userChecksum: 4BBDE3B7B0DAEE2CA5A8F519001D5BFF
- generatedChecksum: D991CF8C9FF9C5452F5D78B4D7BC766E
  logicalPath: config/default/system/fs/fat_fs/file_system
  name: ff.c
  physicalPath: system/fs/fat_fs/file_system
  security: NON_SECURE
  type: SOURCE
  userChecksum: D991CF8C9FF9C5452F5D78B4D7BC766E
- generatedChecksum: 9E153A6D4F8E0EA1F6901BAED7DD80FD
  logicalPath: config/default/system/fs/fat_fs/file_system
  name: ffunicode.c
  physicalPath: system/fs/fat_fs/file_system
  security: NON_SECURE
  type: SOURCE
  userChecksum: 9E153A6D4F8E0EA1F6901BAED7DD80FD
- generatedChecksum: CF89BE92AE72229779903C2E9A760455
  logicalPath: config/default
  name: freertos_hooks.c
  physicalPath: ''
  security: NON_SECURE
  type: SOURCE
  userChecksum: CF89BE92AE72229779903C2E9A760455
- generatedChecksum: C991566B83550177108342CDCF6888A6
  logicalPath: config/default/library/tcpip/src
  name: hash_fnv.c
  physicalPath: library/tcpip/src
  security: NON_SECURE
  type: SOURCE
  userChecksum: C991566B83550177108342CDCF6888A6
- generatedChecksum: 160569377212ACBF0EC5030CABD0B79C
  logicalPath: FreeRTOS/Source/portable/MemMang
  name: heap_3.c
  physicalPath: ../../third_party/rtos/FreeRTOS/Source/portable/MemMang
  security: NON_SECURE
  type: SOURCE
  userChecksum: 160569377212ACBF0EC5030CABD0B79C
- generatedChecksum: 10E0F557204916FC4EBA9DEB6F35095F
  logicalPath: config/default/library/tcpip/src/common
  name: helpers.c
  physicalPath: library/tcpip/src
  security: NON_SECURE
  type: SOURCE
  userChecksum: 10E0F557204916FC4EBA9DEB6F35095F
- generatedChecksum: F6F21E9FEB3B4820A5DBC1683FBDD675
  logicalPath: config/default/library/tcpip/src
  name: http_net.c
  physicalPath: library/tcpip/src
  security: NON_SECURE
  type: SOURCE
  userChecksum: 69A8A095E4AAC289585B61BFABDB4C1F
- generatedChecksum: B033BB618AC38AD5DF1FB450E77C8918
  logicalPath: config/default/library/tcpip/src
  name: icmp.c
  physicalPath: library/tcpip/src
  security: NON_SECURE
  type: SOURCE
  userChecksum: B033BB618AC38AD5DF1FB450E77C8918
- generatedChecksum: 4ACB2B318935D368F631AE3336FEC787
  logicalPath: config/default
  name: initialization.c
  physicalPath: ''
  security: NON_SECURE
  type: SOURCE
  userChecksum: 36B3D494344FE7631C412F21834B3EF4
- generatedChecksum: 20A758769491353E504BEFC102AF5576
  logicalPath: config/default
  name: interrupts.c
  physicalPath: ''
  security: NON_SECURE
  type: SOURCE
  userChecksum: 20A758769491353E504BEFC102AF5576
- generatedChecksum: BAB1AA1B9765039F8906D5704D988BD9
  logicalPath: config/default
  name: interrupts_a.S
  physicalPath: ''
  security: NON_SECURE
  type: SOURCE
  userChecksum: BAB1AA1B9765039F8906D5704D988BD9
- generatedChecksum: F553FDEED94D440487B2050507235456
  logicalPath: config/default/library/tcpip/src
  name: ipv4.c
  physicalPath: library/tcpip/src
  security: NON_SECURE
  type: SOURCE
  userChecksum: F553FDEED94D440487B2050507235456
- generatedChecksum: 47F98BAFD5D2A077AB529D10DB870AFF
  logicalPath: FreeRTOS/Source
  name: list.c
  physicalPath: ../../third_party/rtos/FreeRTOS/Source
  security: NON_SECURE
  type: SOURCE
  userChecksum: 47F98BAFD5D2A077AB529D10DB870AFF
- generatedChecksum: null
  logicalPath: ''
  name: main.c
  physicalPath: ../..
  security: NON_SECURE
  type: SOURCE
  userChecksum: null
- generatedChecksum: AD183632B937146A8C80EDE0D35BFE21
  logicalPath: third_party/wolfMQTT/src
  name: mqtt_client.c
  physicalPath: ../../third_party/wolfMQTT/src
  security: NON_SECURE
  type: SOURCE
  userChecksum: AD183632B937146A8C80EDE0D35BFE21
- generatedChecksum: C8BB40E052F28BC84434A2693034CBD9
  logicalPath: config/default/third_party_adapter/wolfMQTT/src
  name: mqtt_net_glue.c
  physicalPath: third_party_adapter/wolfMQTT/src
  security: NON_SECURE
  type: SOURCE
  userChecksum: C8BB40E052F28BC84434A2693034CBD9
- generatedChecksum: 0BC7F3E30A7AA1A317E6927623FA4AE8
  logicalPath: third_party/wolfMQTT/src
  name: mqtt_packet.c
  physicalPath: ../../third_party/wolfMQTT/src
  security: NON_SECURE
  type: SOURCE
  userChecksum: 0BC7F3E30A7AA1A317E6927623FA4AE8
- generatedChecksum: 51A0DA6D8006E00542108FEAECA8D581
  logicalPath: third_party/wolfMQTT/src
  name: mqtt_socket.c
  physicalPath: ../../third_party/wolfMQTT/src
  security: NON_SECURE
  type: SOURCE
  userChecksum: 51A0DA6D8006E00542108FEAECA8D581
- generatedChecksum: 3D1FBA1F5B3DFFA1B419A579EA0D8600
  logicalPath: config/default/library/tcpip/src
  name: nbns.c
  physicalPath: library/tcpip/src
  security: NON_SECURE
  type: SOURCE
  userChecksum: 3D1FBA1F5B3DFFA1B419A579EA0D8600
- generatedChecksum: 349243C5EF50D83FFB1B84CB265F66D8
  logicalPath: config/default/net_pres/pres/src
  name: net_pres.c
  physicalPath: net_pres/pres/src
  security: NON_SECURE
  type: SOURCE
  userChecksum: 349243C5EF50D83FFB1B84CB265F66D8
- generatedChecksum: E16AE1053896D773DC96862706DB87AF
  logicalPath: config/default/net_pres/pres
  name: net_pres_cert_store.c
  physicalPath: net_pres/pres
  security: NON_SECURE
  type: SOURCE
  userChecksum: E16AE1053896D773DC96862706DB87AF
- generatedChecksum: 70C641A697B8152F841FA575454EABE6
  logicalPath: config/default/net_pres/pres
  name: net_pres_enc_glue.c
  physicalPath: net_pres/pres
  security: NON_SECURE
  type: SOURCE
  userChecksum: 70C641A697B8152F841FA575454EABE6
- generatedChecksum: 60FC7BF9CAD24FDC99C7FDC3488FDA36
  logicalPath: config/default/library/tcpip/src
  name: oahash.c
  physicalPath: library/tcpip/src
  security: NON_SECURE
  type: SOURCE
  userChecksum: 60FC7BF9CAD24FDC99C7FDC3488FDA36
- generatedChecksum: 24A6418F1F0204FC5D16FBBAA51B8EC6
  logicalPath: web_pages/opt/microchip/Harmony3/net/web_pages
  name: opt/microchip/Harmony3/net//web_pages/auth.htm
  physicalPath: ../../web_pages
  security: NON_SECURE
  type: SOURCE
  userChecksum: 24A6418F1F0204FC5D16FBBAA51B8EC6
- generatedChecksum: 2DF6E8B58D442C26AF22A8728E6D3757
  logicalPath: web_pages/opt/microchip/Harmony3/net/web_pages
  name: opt/microchip/Harmony3/net//web_pages/cookies.htm
  physicalPath: ../../web_pages
  security: NON_SECURE
  type: SOURCE
  userChecksum: 2DF6E8B58D442C26AF22A8728E6D3757
- generatedChecksum: 53228E0208C7119283B2EFA61E066C15
  logicalPath: web_pages/opt/microchip/Harmony3/net/web_pages/dyndns
  name: opt/microchip/Harmony3/net//web_pages/dyndns/index.htm
  physicalPath: ../../web_pages
  security: NON_SECURE
  type: SOURCE
  userChecksum: 53228E0208C7119283B2EFA61E066C15
- generatedChecksum: 9A0CBE13D19A98A3B6B7F3BF7908C05E
  logicalPath: web_pages/opt/microchip/Harmony3/net/web_pages
  name: opt/microchip/Harmony3/net//web_pages/dynvars.htm
  physicalPath: ../../web_pages
  security: NON_SECURE
  type: SOURCE
  userChecksum: 9A0CBE13D19A98A3B6B7F3BF7908C05E
- generatedChecksum: 30FEBB4379CD80BE4928CAD37087F37D
  logicalPath: web_pages/opt/microchip/Harmony3/net/web_pages/email
  name: opt/microchip/Harmony3/net//web_pages/email/index.htm
  physicalPath: ../../web_pages
  security: NON_SECURE
  type: SOURCE
  userChecksum: 30FEBB4379CD80BE4928CAD37087F37D
- generatedChecksum: 34B5EC3D6AFF76D534C2533264F70746
  logicalPath: web_pages/opt/microchip/Harmony3/net/web_pages
  name: opt/microchip/Harmony3/net//web_pages/footer.htm
  physicalPath: ../../web_pages
  security: NON_SECURE
  type: SOURCE
  userChecksum: 34B5EC3D6AFF76D534C2533264F70746
- generatedChecksum: 44037F48DC158F4D6DE8A1AD327579B9
  logicalPath: web_pages/opt/microchip/Harmony3/net/web_pages
  name: opt/microchip/Harmony3/net//web_pages/forms.htm
  physicalPath: ../../web_pages
  security: NON_SECURE
  type: SOURCE
  userChecksum: 44037F48DC158F4D6DE8A1AD327579B9
- generatedChecksum: BE650686B2E37535FD6DA67DC866F9C7
  logicalPath: web_pages/opt/microchip/Harmony3/net/web_pages
  name: opt/microchip/Harmony3/net//web_pages/harmony.gif
  physicalPath: ../../web_pages
  security: NON_SECURE
  type: SOURCE
  userChecksum: BE650686B2E37535FD6DA67DC866F9C7
- generatedChecksum: 2A4F8860F9D4657B5BFCF62A6F2E1B72
  logicalPath: web_pages/opt/microchip/Harmony3/net/web_pages
  name: opt/microchip/Harmony3/net//web_pages/header.htm
  physicalPath: ../../web_pages
  security: NON_SECURE
  type: SOURCE
  userChecksum: 2A4F8860F9D4657B5BFCF62A6F2E1B72
- generatedChecksum: E1C11C9FEFFE008A939BAEE929D54A1D
  logicalPath: web_pages/opt/microchip/Harmony3/net/web_pages
  name: opt/microchip/Harmony3/net//web_pages/index.htm
  physicalPath: ../../web_pages
  security: NON_SECURE
  type: SOURCE
  userChecksum: E1C11C9FEFFE008A939BAEE929D54A1D
- generatedChecksum: B61CF49D1130D701766F9517ED8F5909
  logicalPath: web_pages/opt/microchip/Harmony3/net/web_pages
  name: opt/microchip/Harmony3/net//web_pages/leds.cgi
  physicalPath: ../../web_pages
  security: NON_SECURE
  type: SOURCE
  userChecksum: B61CF49D1130D701766F9517ED8F5909
- generatedChecksum: A0FC91949846137F6B96ED4E0ADE7985
  logicalPath: web_pages/opt/microchip/Harmony3/net/web_pages
  name: opt/microchip/Harmony3/net//web_pages/mchp.css
  physicalPath: ../../web_pages
  security: NON_SECURE
  type: SOURCE
  userChecksum: A0FC91949846137F6B96ED4E0ADE7985
- generatedChecksum: DF6CD46C7A96EBB3036608345EE12C90
  logicalPath: web_pages/opt/microchip/Harmony3/net/web_pages
  name: opt/microchip/Harmony3/net//web_pages/mchp.gif
  physicalPath: ../../web_pages
  security: NON_SECURE
  type: SOURCE
  userChecksum: DF6CD46C7A96EBB3036608345EE12C90
- generatedChecksum: FDEB5DD0CA25886B19520748BF15833A
  logicalPath: web_pages/opt/microchip/Harmony3/net/web_pages
  name: opt/microchip/Harmony3/net//web_pages/mchp.js
  physicalPath: ../../web_pages
  security: NON_SECURE
  type: SOURCE
  userChecksum: FDEB5DD0CA25886B19520748BF15833A
- generatedChecksum: 94BD9ECAE121628FFE573BE70F884DA0
  logicalPath: web_pages/opt/microchip/Harmony3/net/web_pages/protect
  name: opt/microchip/Harmony3/net//web_pages/protect/config.htm
  physicalPath: ../../web_pages
  security: NON_SECURE
  type: SOURCE
  userChecksum: 94BD9ECAE121628FFE573BE70F884DA0
- generatedChecksum: A704005B08138C056487580ECE8FF2E5
  logicalPath: web_pages/opt/microchip/Harmony3/net/web_pages/protect
  name: opt/microchip/Harmony3/net//web_pages/protect/index.htm
  physicalPath: ../../web_pages
  security: NON_SECURE
  type: SOURCE
  userChecksum: A704005B08138C056487580ECE8FF2E5
- generatedChecksum: 7302474C63C9A8C7D813D2AA26D15152
  logicalPath: web_pages/opt/microchip/Harmony3/net/web_pages/protect
  name: opt/microchip/Harmony3/net//web_pages/protect/reboot.cgi
  physicalPath: ../../web_pages
  security: NON_SECURE
  type: SOURCE
  userChecksum: 7302474C63C9A8C7D813D2AA26D15152
- generatedChecksum: D070BA177FFF082BF3E9D8A44E05413E
  logicalPath: web_pages/opt/microchip/Harmony3/net/web_pages/protect
  name: opt/microchip/Harmony3/net//web_pages/protect/reboot.htm
  physicalPath: ../../web_pages
  security: NON_SECURE
  type: SOURCE
  userChecksum: D070BA177FFF082BF3E9D8A44E05413E
- generatedChecksum: 03E1F13C1FEC2238F8531C0CEDEEA85F
  logicalPath: web_pages/opt/microchip/Harmony3/net/web_pages
  name: opt/microchip/Harmony3/net//web_pages/snmp.bib
  physicalPath: ../../web_pages
  security: NON_SECURE
  type: SOURCE
  userChecksum: 03E1F13C1FEC2238F8531C0CEDEEA85F
- generatedChecksum: 45C66E36F53F0DE7BC010A1D44E9AA9D
  logicalPath: web_pages/opt/microchip/Harmony3/net/web_pages/snmp
  name: opt/microchip/Harmony3/net//web_pages/snmp/snmpconfig.htm
  physicalPath: ../../web_pages
  security: NON_SECURE
  type: SOURCE
  userChecksum: 45C66E36F53F0DE7BC010A1D44E9AA9D
- generatedChecksum: FB8095760E268C6A33643987995D571D
  logicalPath: web_pages/opt/microchip/Harmony3/net/web_pages
  name: opt/microchip/Harmony3/net//web_pages/ssi.htm
  physicalPath: ../../web_pages
  security: NON_SECURE
  type: SOURCE
  userChecksum: FB8095760E268C6A33643987995D571D
- generatedChecksum: 3DB6E195EBADDBB75B68E55FE5DF5294
  logicalPath: web_pages/opt/microchip/Harmony3/net/web_pages
  name: opt/microchip/Harmony3/net//web_pages/status.xml
  physicalPath: ../../web_pages
  security: NON_SECURE
  type: SOURCE
  userChecksum: 3DB6E195EBADDBB75B68E55FE5DF5294
- generatedChecksum: 4E25492D0D2E6A77AA829DE55FF00BF5
  logicalPath: web_pages/opt/microchip/Harmony3/net/web_pages
  name: opt/microchip/Harmony3/net//web_pages/upload.htm
  physicalPath: ../../web_pages
  security: NON_SECURE
  type: SOURCE
  userChecksum: 4E25492D0D2E6A77AA829DE55FF00BF5
- generatedChecksum: 8FDD6248506F28B32C4F5FD9AA0D9C6F
  logicalPath: config/default/osal
  name: osal_freertos.c
  physicalPath: osal
  security: NON_SECURE
  type: SOURCE
  userChecksum: 8FDD6248506F28B32C4F5FD9AA0D9C6F
- generatedChecksum: 2F8D2F5AE2544E2AAB9FD3A1345E08B8
  logicalPath: config/default/peripheral/clk
  name: plib_clk.c
  physicalPath: peripheral/clk
  security: NON_SECURE
  type: SOURCE
  userChecksum: 2F8D2F5AE2544E2AAB9FD3A1345E08B8
- generatedChecksum: 2FEFEA0D4E94F5A5F3D76BAEC3D602E5
  logicalPath: config/default/peripheral/coretimer
  name: plib_coretimer.c
  physicalPath: peripheral/coretimer
  security: NON_SECURE
  type: SOURCE
  userChecksum: 2FEFEA0D4E94F5A5F3D76BAEC3D602E5
- generatedChecksum: 3E27A67D616BBDFB9DB437502B69AB34
  logicalPath: config/default/peripheral/evic
  name: plib_evic.c
  physicalPath: peripheral/evic
  security: NON_SECURE
  type: SOURCE
  userChecksum: 3E27A67D616BBDFB9DB437502B69AB34
- generatedChecksum: 7D6DDBD4C65471932D01646783592ECD
  logicalPath: config/default/peripheral/gpio
  name: plib_gpio.c
  physicalPath: peripheral/gpio
  security: NON_SECURE
  type: SOURCE
  userChecksum: 7D6DDBD4C65471932D01646783592ECD
- generatedChecksum: 6A7D682411F547FE1811E0318C3779F1
  logicalPath: config/default/peripheral/i2c/master
  name: plib_i2c1_master.c
  physicalPath: peripheral/i2c/master
  security: NON_SECURE
  type: SOURCE
  userChecksum: 6A7D682411F547FE1811E0318C3779F1
- generatedChecksum: C2136D25396D86649CB2D3C8821CBDF7
  logicalPath: config/default/peripheral/rtcc
  name: plib_rtcc.c
  physicalPath: peripheral/rtcc
  security: NON_SECURE
  type: SOURCE
  userChecksum: C2136D25396D86649CB2D3C8821CBDF7
- generatedChecksum: 07AD6B8D890E01C68B48334C971EE571
  logicalPath: config/default/peripheral/spi/spi_master
  name: plib_spi1_master.c
  physicalPath: peripheral/spi/spi_master
  security: NON_SECURE
  type: SOURCE
  userChecksum: 07AD6B8D890E01C68B48334C971EE571
- generatedChecksum: 79243F450EABB95D59754C2A0E137A44
  logicalPath: config/default/peripheral/spi/spi_master
  name: plib_spi4_master.c
  physicalPath: peripheral/spi/spi_master
  security: NON_SECURE
  type: SOURCE
  userChecksum: 79243F450EABB95D59754C2A0E137A44
- generatedChecksum: 65A28466802A4058A575F91297D4BFD5
  logicalPath: config/default/peripheral/tmr
  name: plib_tmr2.c
  physicalPath: peripheral/tmr
  security: NON_SECURE
  type: SOURCE
  userChecksum: 65A28466802A4058A575F91297D4BFD5
- generatedChecksum: D5DC528B5767D23A1A9C56595EAB33FD
  logicalPath: config/default/peripheral/uart
  name: plib_uart4.c
  physicalPath: peripheral/uart
  security: NON_SECURE
  type: SOURCE
  userChecksum: D5DC528B5767D23A1A9C56595EAB33FD
- generatedChecksum: 2C41DCC0C9B1824703ACDC4CDEB5E359
  logicalPath: config/default/peripheral/wdt
  name: plib_wdt.c
  physicalPath: peripheral/wdt
  security: NON_SECURE
  type: SOURCE
  userChecksum: 2C41DCC0C9B1824703ACDC4CDEB5E359
- generatedChecksum: 71A55E6FB476D5BC63BAC48D4B11CF6C
  logicalPath: FreeRTOS/Source/portable/MPLAB/PIC32MX
  name: port.c
  physicalPath: ../../third_party/rtos/FreeRTOS/Source/portable/MPLAB/PIC32MX
  security: NON_SECURE
  type: SOURCE
  userChecksum: 71A55E6FB476D5BC63BAC48D4B11CF6C
- generatedChecksum: 2428B87E7314744BFC401D825171BEA8
  logicalPath: FreeRTOS/Source/portable/MPLAB/PIC32MX
  name: port_asm.S
  physicalPath: ../../third_party/rtos/FreeRTOS/Source/portable/MPLAB/PIC32MX
  security: NON_SECURE
  type: SOURCE
  userChecksum: 2428B87E7314744BFC401D825171BEA8
- generatedChecksum: 13259EE43A731BF0F46EA946229027BF
  logicalPath: FreeRTOS/Source
  name: queue.c
  physicalPath: ../../third_party/rtos/FreeRTOS/Source
  security: NON_SECURE
  type: SOURCE
  userChecksum: 13259EE43A731BF0F46EA946229027BF
- generatedChecksum: FE249D86453E82583972319043926EA9
  logicalPath: config/default/library/tcpip/src
  name: sntp.c
  physicalPath: library/tcpip/src
  security: NON_SECURE
  type: SOURCE
  userChecksum: FE249D86453E82583972319043926EA9
- generatedChecksum: A9BDA97498BEA85049883F48FB1094A0
  logicalPath: FreeRTOS/Source
  name: stream_buffer.c
  physicalPath: ../../third_party/rtos/FreeRTOS/Source
  security: NON_SECURE
  type: SOURCE
  userChecksum: A9BDA97498BEA85049883F48FB1094A0
- generatedChecksum: 75C83AA1697B5EFAA25930859E6BB836
  logicalPath: config/default/system/command
  name: sys_command.c
  physicalPath: system/command/src
  security: NON_SECURE
  type: SOURCE
  userChecksum: 75C83AA1697B5EFAA25930859E6BB836
- generatedChecksum: 20C22A19D5DC74DEBFC4CCCA83B6F603
  logicalPath: config/default/system/console
  name: sys_console.c
  physicalPath: system/console/src
  security: NON_SECURE
  type: SOURCE
  userChecksum: 20C22A19D5DC74DEBFC4CCCA83B6F603
- generatedChecksum: 5BA0902794A8669B3FE37E8A8BEE9D65
  logicalPath: config/default/system/console
  name: sys_console_local.h
  physicalPath: system/console/src
  security: NON_SECURE
  type: SOURCE
  userChecksum: 5BA0902794A8669B3FE37E8A8BEE9D65
- generatedChecksum: CA5E9B63704372DE5FBC0BDC006B16C3
  logicalPath: config/default/system/console
  name: sys_console_uart.c
  physicalPath: system/console/src
  security: NON_SECURE
  type: SOURCE
  userChecksum: CA5E9B63704372DE5FBC0BDC006B16C3
- generatedChecksum: 767495C6A39617A915D8107093DC1A72
  logicalPath: config/default/system/console
  name: sys_console_uart.h
  physicalPath: system/console/src
  security: NON_SECURE
  type: SOURCE
  userChecksum: 767495C6A39617A915D8107093DC1A72
- generatedChecksum: 5D10B9438117B64220180660AB022150
  logicalPath: config/default/system/console
  name: sys_console_uart_definitions.h
  physicalPath: system/console/src
  security: NON_SECURE
  type: SOURCE
  userChecksum: 5D10B9438117B64220180660AB022150
- generatedChecksum: 68C0D499B9EDAA3BFD7E131A48514212
  logicalPath: config/default/system/debug
  name: sys_debug.c
  physicalPath: system/debug/src
  security: NON_SECURE
  type: SOURCE
  userChecksum: 68C0D499B9EDAA3BFD7E131A48514212
- generatedChecksum: B8C6C7356AC7841AECC7C779040F745C
  logicalPath: config/default/system/debug
  name: sys_debug_local.h
  physicalPath: system/debug/src
  security: NON_SECURE
  type: SOURCE
  userChecksum: B8C6C7356AC7841AECC7C779040F745C
- generatedChecksum: 0A6893369C4DA0EE7906866EB6E1D310
  logicalPath: config/default/system/dma
  name: sys_dma.c
  physicalPath: system/dma
  security: NON_SECURE
  type: SOURCE
  userChecksum: 0A6893369C4DA0EE7906866EB6E1D310
- generatedChecksum: 9C4B71FF77DB16BC8FF11B79F8FB7EB1
  logicalPath: config/default/system/fs
  name: sys_fs.c
  physicalPath: system/fs/src
  security: NON_SECURE
  type: SOURCE
  userChecksum: 9C4B71FF77DB16BC8FF11B79F8FB7EB1
- generatedChecksum: 1F79CD9E378D98E657FCEB0552B2B659
  logicalPath: config/default/system/fs
  name: sys_fs_fat_interface.c
  physicalPath: system/fs/src
  security: NON_SECURE
  type: SOURCE
  userChecksum: 1F79CD9E378D98E657FCEB0552B2B659
- generatedChecksum: 56CAB83269AF585DADCDC124D19DCA5A
  logicalPath: config/default/system/fs
  name: sys_fs_media_manager.c
  physicalPath: system/fs/src
  security: NON_SECURE
  type: SOURCE
  userChecksum: 56CAB83269AF585DADCDC124D19DCA5A
- generatedChecksum: 75B14036B9ECCC3A806A4E5ADB440413
  logicalPath: config/default/library/tcpip/src/common
  name: sys_fs_shell.c
  physicalPath: library/tcpip/src/common
  security: NON_SECURE
  type: SOURCE
  userChecksum: 75B14036B9ECCC3A806A4E5ADB440413
- generatedChecksum: C95CE0ABB86E6B11CF77E8891D294510
  logicalPath: config/default/system/int
  name: sys_int.c
  physicalPath: system/int/src
  security: NON_SECURE
  type: SOURCE
  userChecksum: C95CE0ABB86E6B11CF77E8891D294510
- generatedChecksum: 6E907D9AEFDAE88D8E9B23F0668846C6
  logicalPath: config/default/system
  name: sys_random_h2_adapter.c
  physicalPath: system
  security: NON_SECURE
  type: SOURCE
  userChecksum: 6E907D9AEFDAE88D8E9B23F0668846C6
- generatedChecksum: 47B584985982B2FF32628D4CB874CB4D
  logicalPath: config/default/system/reset
  name: sys_reset.c
  physicalPath: system/reset
  security: NON_SECURE
  type: SOURCE
  userChecksum: 47B584985982B2FF32628D4CB874CB4D
- generatedChecksum: B68110221BEC42FE6B718139BA64DA52
  logicalPath: config/default/system/time
  name: sys_time.c
  physicalPath: system/time/src
  security: NON_SECURE
  type: SOURCE
  userChecksum: B68110221BEC42FE6B718139BA64DA52
- generatedChecksum: F849420C740D2B32346B4B4D9F46C136
  logicalPath: config/default/system
  name: sys_time_h2_adapter.c
  physicalPath: system
  security: NON_SECURE
  type: SOURCE
  userChecksum: F849420C740D2B32346B4B4D9F46C136
- generatedChecksum: C076FD79219C836DEE1B21A3A80D475C
  logicalPath: config/default
  name: tasks.c
  physicalPath: ''
  security: NON_SECURE
  type: SOURCE
  userChecksum: C076FD79219C836DEE1B21A3A80D475C
- generatedChecksum: 8C638F091801B67BAF72C03A3E007853
  logicalPath: config/default/library/tcpip/src
  name: tcp.c
  physicalPath: library/tcpip/src
  security: NON_SECURE
  type: SOURCE
  userChecksum: 8C638F091801B67BAF72C03A3E007853
- generatedChecksum: A7AAD7B4A2CC12C03F79733E89702A58
  logicalPath: config/default/library/tcpip/src
  name: tcpip_commands.c
  physicalPath: library/tcpip/src
  security: NON_SECURE
  type: SOURCE
  userChecksum: A7AAD7B4A2CC12C03F79733E89702A58
- generatedChecksum: E069B0B9CAA1F75E86AFE6827A6E376D
  logicalPath: config/default/library/tcpip/src
  name: tcpip_heap_alloc.c
  physicalPath: library/tcpip/src
  security: NON_SECURE
  type: SOURCE
  userChecksum: E069B0B9CAA1F75E86AFE6827A6E376D
- generatedChecksum: 8931AF073895D96701BAB888D4655F99
  logicalPath: config/default/library/tcpip/src
  name: tcpip_heap_external.c
  physicalPath: library/tcpip/src
  security: NON_SECURE
  type: SOURCE
  userChecksum: 8931AF073895D96701BAB888D4655F99
- generatedChecksum: 41E9DA13FC2CC263ACF1F2373500E7F4
  logicalPath: config/default/library/tcpip/src
  name: tcpip_helper_c32.S
  physicalPath: library/tcpip/src
  security: NON_SECURE
  type: SOURCE
  userChecksum: 41E9DA13FC2CC263ACF1F2373500E7F4
- generatedChecksum: 81EADD271AD3FD00D134231272F6692C
  logicalPath: config/default/library/tcpip/src
  name: tcpip_helpers.c
  physicalPath: library/tcpip/src
  security: NON_SECURE
  type: SOURCE
  userChecksum: 81EADD271AD3FD00D134231272F6692C
- generatedChecksum: 50BABC204270AC14AC3E3988400638A5
  logicalPath: config/default/library/tcpip/src
  name: tcpip_manager.c
  physicalPath: library/tcpip/src
  security: NON_SECURE
  type: SOURCE
  userChecksum: 50BABC204270AC14AC3E3988400638A5
- generatedChecksum: 5A25A79EFC070534190D40826D08046B
  logicalPath: config/default/library/tcpip/src
  name: tcpip_notify.c
  physicalPath: library/tcpip/src
  security: NON_SECURE
  type: SOURCE
  userChecksum: 5A25A79EFC070534190D40826D08046B
- generatedChecksum: 7525DAEE4AF7FB232FFCAE796A1FC14E
  logicalPath: config/default/library/tcpip/src
  name: tcpip_packet.c
  physicalPath: library/tcpip/src
  security: NON_SECURE
  type: SOURCE
  userChecksum: 7525DAEE4AF7FB232FFCAE796A1FC14E
- generatedChecksum: 2811D7C532CEFF995F8697FCED6A1C34
  logicalPath: FreeRTOS/Source
  name: timers.c
  physicalPath: ../../third_party/rtos/FreeRTOS/Source
  security: NON_SECURE
  type: SOURCE
  userChecksum: 2811D7C532CEFF995F8697FCED6A1C34
- generatedChecksum: 6D28DD3F48EE5E5B423346BED6EE4BE1
  logicalPath: config/default/library/tcpip/src
  name: udp.c
  physicalPath: library/tcpip/src
  security: NON_SECURE
  type: SOURCE
  userChecksum: 6D28DD3F48EE5E5B423346BED6EE4BE1
- generatedChecksum: B1BE78DA4858C586B72A7824E2410F13
  logicalPath: config/default/usb/src
  name: usb_host.c
  physicalPath: usb/src
  security: NON_SECURE
  type: SOURCE
  userChecksum: B1BE78DA4858C586B72A7824E2410F13
- generatedChecksum: EEBC6B40B33FE7A82295CBC67FCC55B6
  logicalPath: config/default
  name: usb_host_init_data.c
  physicalPath: ''
  security: NON_SECURE
  type: SOURCE
  userChecksum: EEBC6B40B33FE7A82295CBC67FCC55B6
- generatedChecksum: A44FA6E3F312CC5DB91590DBEC0A7895
  logicalPath: config/default/usb/src
  name: usb_host_msd.c
  physicalPath: usb/src
  security: NON_SECURE
  type: SOURCE
  userChecksum: A44FA6E3F312CC5DB91590DBEC0A7895
- generatedChecksum: 6FB71B015A2C3B84C8913F9C8A53532F
  logicalPath: config/default/usb/src
  name: usb_host_scsi.c
  physicalPath: usb/src
  security: NON_SECURE
  type: SOURCE
  userChecksum: 6FB71B015A2C3B84C8913F9C8A53532F
- generatedChecksum: 71352EF41F6688AD8408E42970B50B66
  logicalPath: config/default/stdio
  name: xc32_monitor.c
  physicalPath: stdio
  security: NON_SECURE
  type: SOURCE
  userChecksum: 71352EF41F6688AD8408E42970B50B66
- generatedChecksum: 5E06C8C3B681B9398724569B7DC5AFB8
  logicalPath: FreeRTOS/Source/include
  name: FreeRTOS.h
  physicalPath: ../../third_party/rtos/FreeRTOS/Source/include
  security: NON_SECURE
  type: HEADER
  userChecksum: 5E06C8C3B681B9398724569B7DC5AFB8
- generatedChecksum: E4709CEFB7F7B75B244DD1C66DC28070
  logicalPath: config/default
  name: FreeRTOSConfig.h
  physicalPath: ''
  security: NON_SECURE
  type: HEADER
  userChecksum: E4709CEFB7F7B75B244DD1C66DC28070
- generatedChecksum: 3F453FC192959EEDBAC9FE16D2E50ED7
  logicalPath: FreeRTOS/Source/portable/MPLAB/PIC32MX
  name: ISR_Support.h
  physicalPath: ../../third_party/rtos/FreeRTOS/Source/portable/MPLAB/PIC32MX
  security: NON_SECURE
  type: HEADER
  userChecksum: 3F453FC192959EEDBAC9FE16D2E50ED7
- generatedChecksum: 2A07C893B5AA31A2873FAD0A7D5E61B5
  logicalPath: config/default/driver/ethmac/src/dynamic
  name: _eth_dcpt_lists.h
  physicalPath: driver/ethmac/src/dynamic
  security: NON_SECURE
  type: HEADER
  userChecksum: 2A07C893B5AA31A2873FAD0A7D5E61B5
- generatedChecksum: null
  logicalPath: ''
  name: app.h
  physicalPath: ../..
  security: NON_SECURE
  type: HEADER
  userChecksum: null
- generatedChecksum: 874B8F5AFF2A6E8563550762B04CA6AC
  logicalPath: ''
  name: app_mqtt_task.h
  physicalPath: ../..
  security: NON_SECURE
  type: HEADER
  userChecksum: 874B8F5AFF2A6E8563550762B04CA6AC
- generatedChecksum: 2709BE5CD31DEA3E6E95B9EAFB459465
  logicalPath: config/default/library/tcpip
  name: arp.h
  physicalPath: library/tcpip
  security: NON_SECURE
  type: HEADER
  userChecksum: 2709BE5CD31DEA3E6E95B9EAFB459465
- generatedChecksum: 07F35B7ECD80D544D58903ABE1F64F86
  logicalPath: config/default/library/tcpip/src
  name: arp_manager.h
  physicalPath: library/tcpip/src
  security: NON_SECURE
  type: HEADER
  userChecksum: 07F35B7ECD80D544D58903ABE1F64F86
- generatedChecksum: D0C763149DFEA26198F5F598DD308663
  logicalPath: config/default/library/tcpip/src
  name: arp_private.h
  physicalPath: library/tcpip/src
  security: NON_SECURE
  type: HEADER
  userChecksum: D0C763149DFEA26198F5F598DD308663
- generatedChecksum: F0FEC11883266C663101B473DBB9C745
  logicalPath: config/default/library/tcpip
  name: berkeley_api.h
  physicalPath: library/tcpip
  security: NON_SECURE
  type: HEADER
  userChecksum: F0FEC11883266C663101B473DBB9C745
- generatedChecksum: C0F34020BFE4A8185F282064E89AB3D2
  logicalPath: config/default/library/tcpip/src
  name: berkeley_manager.h
  physicalPath: library/tcpip/src
  security: NON_SECURE
  type: HEADER
  userChecksum: C0F34020BFE4A8185F282064E89AB3D2
- generatedChecksum: 9537C1E41F14DFF1B50CF8AE3880105C
  logicalPath: config/default
  name: config.h
  physicalPath: ''
  security: NON_SECURE
  type: HEADER
  userChecksum: 9537C1E41F14DFF1B50CF8AE3880105C
- generatedChecksum: 82A246AE7876C589E2171B190393C700
  logicalPath: config/default
  name: configuration.h
  physicalPath: ''
  security: NON_SECURE
  type: HEADER
  userChecksum: 82A246AE7876C589E2171B190393C700
- generatedChecksum: 4B11D1A616E95BDD37123685C8434FCF
  logicalPath: FreeRTOS/Source/include
  name: croutine.h
  physicalPath: ../../third_party/rtos/FreeRTOS/Source/include
  security: NON_SECURE
  type: HEADER
  userChecksum: 4B11D1A616E95BDD37123685C8434FCF
- generatedChecksum: 858410DFAED3C81F2190A621BCC4D4BC
  logicalPath: config/default/library/tcpip
  name: ddns.h
  physicalPath: library/tcpip
  security: NON_SECURE
  type: HEADER
  userChecksum: 858410DFAED3C81F2190A621BCC4D4BC
- generatedChecksum: 7959E2B94CEE186632B984636D40C252
  logicalPath: config/default/library/tcpip/src
  name: ddns_manager.h
  physicalPath: library/tcpip/src
  security: NON_SECURE
  type: HEADER
  userChecksum: 7959E2B94CEE186632B984636D40C252
- generatedChecksum: 753C5B34F7833986530BDF1C058B7807
  logicalPath: config/default
  name: definitions.h
  physicalPath: ''
  security: NON_SECURE
  type: HEADER
  userChecksum: 753C5B34F7833986530BDF1C058B7807
- generatedChecksum: ACB7AD12FD525895ABA47C26F4F9A683
  logicalPath: FreeRTOS/Source/include
  name: deprecated_definitions.h
  physicalPath: ../../third_party/rtos/FreeRTOS/Source/include
  security: NON_SECURE
  type: HEADER
  userChecksum: ACB7AD12FD525895ABA47C26F4F9A683
- generatedChecksum: E189C26B2269F8DE46033CCD0621958D
  logicalPath: config/default
  name: device.h
  physicalPath: ''
  security: NON_SECURE
  type: HEADER
  userChecksum: E189C26B2269F8DE46033CCD0621958D
- generatedChecksum: 49A281B486DF5BA5394152377D5C8A9B
  logicalPath: config/default
  name: device_cache.h
  physicalPath: ''
  security: NON_SECURE
  type: HEADER
  userChecksum: 49A281B486DF5BA5394152377D5C8A9B
- generatedChecksum: 309956DF6DBAC8661AA8C62A273FD710
  logicalPath: config/default/library/tcpip
  name: dhcp.h
  physicalPath: library/tcpip
  security: NON_SECURE
  type: HEADER
  userChecksum: 309956DF6DBAC8661AA8C62A273FD710
- generatedChecksum: 02E33F9BAEBC7C50595F9615084EB0F5
  logicalPath: config/default/library/tcpip/src
  name: dhcp_manager.h
  physicalPath: library/tcpip/src
  security: NON_SECURE
  type: HEADER
  userChecksum: 02E33F9BAEBC7C50595F9615084EB0F5
- generatedChecksum: 0B6369D6AF87E82A559058C5E0B4EF77
  logicalPath: config/default/library/tcpip/src
  name: dhcp_private.h
  physicalPath: library/tcpip/src
  security: NON_SECURE
  type: HEADER
  userChecksum: 0B6369D6AF87E82A559058C5E0B4EF77
- generatedChecksum: 3F5CF4A3D11FB82D55EA0B34176914B9
  logicalPath: config/default/library/tcpip
  name: dhcp_server.h
  physicalPath: library/tcpip
  security: NON_SECURE
  type: HEADER
  userChecksum: 3F5CF4A3D11FB82D55EA0B34176914B9
- generatedChecksum: 9EFF17CC1F25051E5560AF13932C16D1
  logicalPath: config/default/library/tcpip/src
  name: dhcp_server_manager.h
  physicalPath: library/tcpip/src
  security: NON_SECURE
  type: HEADER
  userChecksum: 9EFF17CC1F25051E5560AF13932C16D1
- generatedChecksum: 4F947FAA7C2802F3C4C16336111B2716
  logicalPath: config/default/library/tcpip/src
  name: dhcp_server_private.h
  physicalPath: library/tcpip/src
  security: NON_SECURE
  type: HEADER
  userChecksum: 4F947FAA7C2802F3C4C16336111B2716
- generatedChecksum: E1D8C77E0B7F57C8A5F614C38EBA5EB1
  logicalPath: config/default/library/tcpip
  name: dhcps.h
  physicalPath: library/tcpip
  security: NON_SECURE
  type: HEADER
  userChecksum: E1D8C77E0B7F57C8A5F614C38EBA5EB1
- generatedChecksum: E4B4C8DE8FA457275D1BB5F0200142E7
  logicalPath: config/default/library/tcpip/src
  name: dhcps_manager.h
  physicalPath: library/tcpip/src
  security: NON_SECURE
  type: HEADER
  userChecksum: E4B4C8DE8FA457275D1BB5F0200142E7
- generatedChecksum: 6F3792EACF9CEA5B0CD4A4AF9D1D02D7
  logicalPath: config/default/library/tcpip/src
  name: dhcps_private.h
  physicalPath: library/tcpip/src
  security: NON_SECURE
  type: HEADER
  userChecksum: 6F3792EACF9CEA5B0CD4A4AF9D1D02D7
- generatedChecksum: C10D8E9FC48BE323DE345C43CDD08517
  logicalPath: config/default/library/tcpip
  name: dhcpv6.h
  physicalPath: library/tcpip
  security: NON_SECURE
  type: HEADER
  userChecksum: C10D8E9FC48BE323DE345C43CDD08517
- generatedChecksum: 0C8653B6A722BB2AD0B8B397E7543AE8
  logicalPath: config/default/library/tcpip/src
  name: dhcpv6_manager.h
  physicalPath: library/tcpip/src
  security: NON_SECURE
  type: HEADER
  userChecksum: 0C8653B6A722BB2AD0B8B397E7543AE8
- generatedChecksum: DF64BC475CBCA98EAFC9DA110C251D8A
  logicalPath: config/default/library/tcpip/src
  name: dhcpv6_private.h
  physicalPath: library/tcpip/src
  security: NON_SECURE
  type: HEADER
  userChecksum: DF64BC475CBCA98EAFC9DA110C251D8A
- generatedChecksum: 630DFA1824A5279838B4330DA2FF3E5E
  logicalPath: config/default/system/fs/fat_fs/hardware_access
  name: diskio.h
  physicalPath: system/fs/fat_fs/hardware_access
  security: NON_SECURE
  type: HEADER
  userChecksum: 630DFA1824A5279838B4330DA2FF3E5E
- generatedChecksum: 7D5AE1A255B35717CC2284753437C2C2
  logicalPath: config/default/library/tcpip
  name: dns.h
  physicalPath: library/tcpip
  security: NON_SECURE
  type: HEADER
  userChecksum: 7D5AE1A255B35717CC2284753437C2C2
- generatedChecksum: 3C30E019511126511DD7756487D1E1A6
  logicalPath: config/default/library/tcpip/src
  name: dns_manager.h
  physicalPath: library/tcpip/src
  security: NON_SECURE
  type: HEADER
  userChecksum: 3C30E019511126511DD7756487D1E1A6
- generatedChecksum: 8075114F740CB3C74C1D65BFF09F1591
  logicalPath: config/default/library/tcpip/src
  name: dns_private.h
  physicalPath: library/tcpip/src
  security: NON_SECURE
  type: HEADER
  userChecksum: 8075114F740CB3C74C1D65BFF09F1591
- generatedChecksum: 327EBAFAAC13A6BFEE9F2CB17387EA7C
  logicalPath: config/default/library/tcpip
  name: dnss.h
  physicalPath: library/tcpip
  security: NON_SECURE
  type: HEADER
  userChecksum: 327EBAFAAC13A6BFEE9F2CB17387EA7C
- generatedChecksum: 8A2B8243A615F65E164074224CF0D649
  logicalPath: config/default/library/tcpip/src
  name: dnss_manager.h
  physicalPath: library/tcpip/src
  security: NON_SECURE
  type: HEADER
  userChecksum: 8A2B8243A615F65E164074224CF0D649
- generatedChecksum: A783D086981E7AE2F3EE8971C80F0D82
  logicalPath: config/default/library/tcpip/src
  name: dnss_private.h
  physicalPath: library/tcpip/src
  security: NON_SECURE
  type: HEADER
  userChecksum: A783D086981E7AE2F3EE8971C80F0D82
- generatedChecksum: 1D2094DFA60F847FFD4E8153B6E78027
  logicalPath: config/default/driver
  name: driver.h
  physicalPath: driver
  security: NON_SECURE
  type: HEADER
  userChecksum: 1D2094DFA60F847FFD4E8153B6E78027
- generatedChecksum: CC7DFCC51CD25171A3E400E18969354F
  logicalPath: config/default/driver
  name: driver_common.h
  physicalPath: driver
  security: NON_SECURE
  type: HEADER
  userChecksum: CC7DFCC51CD25171A3E400E18969354F
- generatedChecksum: B8CC62751A29A941F96817162D122652
  logicalPath: config/default/driver/ethmac/src/dynamic
  name: drv_eth_pic32_lib.h
  physicalPath: driver/ethmac/src/dynamic
  security: NON_SECURE
  type: HEADER
  userChecksum: B8CC62751A29A941F96817162D122652
- generatedChecksum: 955DB39E4DD9EAB71C22250D8D71695E
  logicalPath: config/default/driver/ethmac
  name: drv_ethmac.h
  physicalPath: driver/ethmac
  security: NON_SECURE
  type: HEADER
  userChecksum: 955DB39E4DD9EAB71C22250D8D71695E
- generatedChecksum: AA771A049B6C204559481C0DA6BCFEC7
  logicalPath: config/default/driver/ethmac/src/dynamic
  name: drv_ethmac_lib.h
  physicalPath: driver/ethmac/src/dynamic
  security: NON_SECURE
  type: HEADER
  userChecksum: AA771A049B6C204559481C0DA6BCFEC7
- generatedChecksum: 9175ABC5D36B476D2979ACBD9FBBEE18
  logicalPath: config/default/driver/ethmac/src
  name: drv_ethmac_local.h
  physicalPath: driver/ethmac/src
  security: NON_SECURE
  type: HEADER
  userChecksum: 9175ABC5D36B476D2979ACBD9FBBEE18
- generatedChecksum: CC8617FA61286C029FF3591B2AA4E0ED
  logicalPath: config/default/driver/ethphy
  name: drv_ethphy.h
  physicalPath: driver/ethphy
  security: NON_SECURE
  type: HEADER
  userChecksum: CC8617FA61286C029FF3591B2AA4E0ED
- generatedChecksum: A343842511EAFDCB58B89079D60B10B1
  logicalPath: config/default/driver/ethphy/src
  name: drv_ethphy_local.h
  physicalPath: driver/ethphy/src
  security: NON_SECURE
  type: HEADER
  userChecksum: A343842511EAFDCB58B89079D60B10B1
- generatedChecksum: 9FB74931B42DD822D9B41EF5FD3FB9EE
  logicalPath: config/default/driver/ethphy/src/dynamic
  name: drv_extphy_dp83848.h
  physicalPath: driver/ethphy/src/dynamic
  security: NON_SECURE
  type: HEADER
  userChecksum: 9FB74931B42DD822D9B41EF5FD3FB9EE
- generatedChecksum: 23A477C5F02379F9E6ADB2AF1DEB763C
  logicalPath: config/default/driver/ethphy/src/dynamic
  name: drv_extphy_regs.h
  physicalPath: driver/ethphy/src/dynamic
  security: NON_SECURE
  type: HEADER
  userChecksum: 23A477C5F02379F9E6ADB2AF1DEB763C
- generatedChecksum: DE9A328A47FEC185CB88AA4AB3A875D1
  logicalPath: config/default/driver/miim
  name: drv_miim.h
  physicalPath: driver/miim
  security: NON_SECURE
  type: HEADER
  userChecksum: DE9A328A47FEC185CB88AA4AB3A875D1
- generatedChecksum: BEACD2465E21419C956C727F5393369E
  logicalPath: config/default/driver/miim/src
  name: drv_miim_local.h
  physicalPath: driver/miim/src
  security: NON_SECURE
  type: HEADER
  userChecksum: BEACD2465E21419C956C727F5393369E
- generatedChecksum: 6ED779977CA556C753A0F0D94235A414
  logicalPath: config/default/driver/miim/src/dynamic
  name: drv_miim_mapping.h
  physicalPath: driver/miim/src/dynamic
  security: NON_SECURE
  type: HEADER
  userChecksum: 6ED779977CA556C753A0F0D94235A414
- generatedChecksum: C232A5631420DA00DA6D261F1B183B22
  logicalPath: config/default/driver/sdspi
  name: drv_sdspi.h
  physicalPath: driver/sdspi
  security: NON_SECURE
  type: HEADER
  userChecksum: C232A5631420DA00DA6D261F1B183B22
- generatedChecksum: 27E9246E9A0D6C608C320B83A9F64F79
  logicalPath: config/default/driver/sdspi
  name: drv_sdspi_definitions.h
  physicalPath: driver/sdspi
  security: NON_SECURE
  type: HEADER
  userChecksum: 27E9246E9A0D6C608C320B83A9F64F79
- generatedChecksum: 422FCF4C83F4FB0C361176CDF23B18DB
  logicalPath: config/default/driver/sdspi
  name: drv_sdspi_driver_interface.h
  physicalPath: driver/sdspi/src
  security: NON_SECURE
  type: HEADER
  userChecksum: 422FCF4C83F4FB0C361176CDF23B18DB
- generatedChecksum: E9227003057E6B6BA014B443419BD205
  logicalPath: config/default/driver/sdspi
  name: drv_sdspi_local.h
  physicalPath: driver/sdspi/src
  security: NON_SECURE
  type: HEADER
  userChecksum: E9227003057E6B6BA014B443419BD205
- generatedChecksum: 9F75B6689BFA73CB5D96A71849B200F5
  logicalPath: config/default/driver/spi
  name: drv_spi.h
  physicalPath: driver/spi
  security: NON_SECURE
  type: HEADER
  userChecksum: 9F75B6689BFA73CB5D96A71849B200F5
- generatedChecksum: 05A15437D96080BB0A84D3102EB2137C
  logicalPath: config/default/driver/spi
  name: drv_spi_definitions.h
  physicalPath: driver/spi
  security: NON_SECURE
  type: HEADER
  userChecksum: 05A15437D96080BB0A84D3102EB2137C
- generatedChecksum: DF147276AE56CA76E3E9BEB8447620AB
  logicalPath: config/default/driver/usb
  name: drv_usb.h
  physicalPath: driver/usb
  security: NON_SECURE
  type: HEADER
  userChecksum: DF147276AE56CA76E3E9BEB8447620AB
- generatedChecksum: A8072403A5346EF85CDFD4EF996C0826
  logicalPath: config/default/driver/usb
  name: drv_usb_external_dependencies.h
  physicalPath: driver/usb
  security: NON_SECURE
  type: HEADER
  userChecksum: A8072403A5346EF85CDFD4EF996C0826
- generatedChecksum: 8E09A88EA42C831AF5D8F17A1549E1D2
  logicalPath: config/default/driver/usb/usbfs
  name: drv_usbfs.h
  physicalPath: driver/usb/usbfs
  security: NON_SECURE
  type: HEADER
  userChecksum: 8E09A88EA42C831AF5D8F17A1549E1D2
- generatedChecksum: BA88E5162CA794A6A62D146A58458A43
  logicalPath: config/default/driver/usb/usbfs/src
  name: drv_usbfs_local.h
  physicalPath: driver/usb/usbfs/src
  security: NON_SECURE
  type: HEADER
  userChecksum: BA88E5162CA794A6A62D146A58458A43
- generatedChecksum: AE86F1881720D058DAAAB3C5A196BC27
  logicalPath: config/default/driver/usb/usbfs/src
  name: drv_usbfs_variant_mapping.h
  physicalPath: driver/usb/usbfs/src
  security: NON_SECURE
  type: HEADER
  userChecksum: AE86F1881720D058DAAAB3C5A196BC27
- generatedChecksum: DE52B71A2D274138117243B700F40B11
  logicalPath: FreeRTOS/Source/include
  name: event_groups.h
  physicalPath: ../../third_party/rtos/FreeRTOS/Source/include
  security: NON_SECURE
  type: HEADER
  userChecksum: DE52B71A2D274138117243B700F40B11
- generatedChecksum: 187EFA39553617C34D670BFA3AA15C5F
  logicalPath: config/default/system/fs/fat_fs/file_system
  name: ff.h
  physicalPath: system/fs/fat_fs/file_system
  security: NON_SECURE
  type: HEADER
  userChecksum: 187EFA39553617C34D670BFA3AA15C5F
- generatedChecksum: 70886927234FA759611E8164EE8BC7F5
  logicalPath: config/default/system/fs/fat_fs/file_system
  name: ffconf.h
  physicalPath: system/fs/fat_fs/file_system
  security: NON_SECURE
  type: HEADER
  userChecksum: 06FEA4437C2CA7F979D5940A4B6525FA
- generatedChecksum: F9FF7F501257C24ABE3E4A5258ED7212
  logicalPath: config/default/library/tcpip
  name: ftp.h
  physicalPath: library/tcpip
  security: NON_SECURE
  type: HEADER
  userChecksum: F9FF7F501257C24ABE3E4A5258ED7212
- generatedChecksum: 5A8851F0B5D80D8FAB646A0D767DEB31
  logicalPath: config/default/library/tcpip/src
  name: ftp_manager.h
  physicalPath: library/tcpip/src
  security: NON_SECURE
  type: HEADER
  userChecksum: 5A8851F0B5D80D8FAB646A0D767DEB31
- generatedChecksum: A0645D2D20ADA0DAA6480AAD10D526F9
  logicalPath: config/default/library/tcpip/src
  name: ftp_private.h
  physicalPath: library/tcpip/src
  security: NON_SECURE
  type: HEADER
  userChecksum: A0645D2D20ADA0DAA6480AAD10D526F9
- generatedChecksum: 85874DE4D83B37A38D471945EE99CB67
  logicalPath: config/default/library/tcpip
  name: ftpc.h
  physicalPath: library/tcpip
  security: NON_SECURE
  type: HEADER
  userChecksum: 85874DE4D83B37A38D471945EE99CB67
- generatedChecksum: 4793F95B3AF61995116EBF2D270C6E97
  logicalPath: config/default/library/tcpip/src
  name: ftpc_manager.h
  physicalPath: library/tcpip/src
  security: NON_SECURE
  type: HEADER
  userChecksum: 4793F95B3AF61995116EBF2D270C6E97
- generatedChecksum: 09A212308EFAF4D39BE5F0DFE74B11EA
  logicalPath: config/default/library/tcpip/src
  name: ftpc_private.h
  physicalPath: library/tcpip/src
  security: NON_SECURE
  type: HEADER
  userChecksum: 09A212308EFAF4D39BE5F0DFE74B11EA
- generatedChecksum: 9183B48F57885AB94AC73A78F7528E1A
  logicalPath: config/default/library/tcpip/src
  name: hash_fnv.h
  physicalPath: library/tcpip/src
  security: NON_SECURE
  type: HEADER
  userChecksum: 9183B48F57885AB94AC73A78F7528E1A
- generatedChecksum: 25ED0B254C6BE0C14465240915819087
  logicalPath: config/default/library/tcpip/src/common
  name: helpers.h
  physicalPath: library/tcpip/src/common
  security: NON_SECURE
  type: HEADER
  userChecksum: 25ED0B254C6BE0C14465240915819087
- generatedChecksum: 7367A42AF464E57C91B0CF9A2FA5EB4A
  logicalPath: config/default/library/tcpip
  name: http.h
  physicalPath: library/tcpip
  security: NON_SECURE
  type: HEADER
  userChecksum: 7367A42AF464E57C91B0CF9A2FA5EB4A
- generatedChecksum: A283D25AF7C2CD5942A50D786EC51EA7
  logicalPath: config/default/library/tcpip/src
  name: http_manager.h
  physicalPath: library/tcpip/src
  security: NON_SECURE
  type: HEADER
  userChecksum: A283D25AF7C2CD5942A50D786EC51EA7
- generatedChecksum: 80440B7F4947DE5E87B6EDABC1A36A5C
  logicalPath: config/default/library/tcpip
  name: http_net.h
  physicalPath: library/tcpip
  security: NON_SECURE
  type: HEADER
  userChecksum: 80440B7F4947DE5E87B6EDABC1A36A5C
- generatedChecksum: 947C5B70841DF0C234453C4B1D96C6D7
  logicalPath: config/default/library/tcpip/src
  name: http_net_manager.h
  physicalPath: library/tcpip/src
  security: NON_SECURE
  type: HEADER
  userChecksum: 947C5B70841DF0C234453C4B1D96C6D7
- generatedChecksum: 55AC0A9384E7D93C65D0CA9C4E3A2497
  logicalPath: config/default/library/tcpip/src
  name: http_net_private.h
  physicalPath: library/tcpip/src
  security: NON_SECURE
  type: HEADER
  userChecksum: D497FD929FBB50933EA18340C37AB2CC
- generatedChecksum: F1FC0858028996C745F3DDA19CB3428F
  logicalPath: config/default/library/tcpip/src
  name: http_private.h
  physicalPath: library/tcpip/src
  security: NON_SECURE
  type: HEADER
  userChecksum: F1FC0858028996C745F3DDA19CB3428F
- generatedChecksum: 93D1E1E2E1E5A86F9502AE32000EB680
  logicalPath: config/default/library/tcpip
  name: icmp.h
  physicalPath: library/tcpip
  security: NON_SECURE
  type: HEADER
  userChecksum: 93D1E1E2E1E5A86F9502AE32000EB680
- generatedChecksum: DD88B589790400244B3F011223EF63E8
  logicalPath: config/default/library/tcpip/src
  name: icmp_manager.h
  physicalPath: library/tcpip/src
  security: NON_SECURE
  type: HEADER
  userChecksum: DD88B589790400244B3F011223EF63E8
- generatedChecksum: 1E04A73427FE3E6DFE696492A825005F
  logicalPath: config/default/library/tcpip
  name: icmpv6.h
  physicalPath: library/tcpip
  security: NON_SECURE
  type: HEADER
  userChecksum: 1E04A73427FE3E6DFE696492A825005F
- generatedChecksum: 1440F95D128CE7918C74E46AC16A42E3
  logicalPath: config/default/library/tcpip/src
  name: icmpv6_manager.h
  physicalPath: library/tcpip/src
  security: NON_SECURE
  type: HEADER
  userChecksum: 1440F95D128CE7918C74E46AC16A42E3
- generatedChecksum: D9162426B371F31641252F6DB39A16CA
  logicalPath: config/default/library/tcpip
  name: igmp.h
  physicalPath: library/tcpip
  security: NON_SECURE
  type: HEADER
  userChecksum: D9162426B371F31641252F6DB39A16CA
- generatedChecksum: 25C07C460FA1705F6B3CDE09928E1D3C
  logicalPath: config/default/library/tcpip/src
  name: igmp_manager.h
  physicalPath: library/tcpip/src
  security: NON_SECURE
  type: HEADER
  userChecksum: 25C07C460FA1705F6B3CDE09928E1D3C
- generatedChecksum: E483D94FDF38E11A37653D16DCF2261A
  logicalPath: config/default/library/tcpip/src
  name: igmp_private.h
  physicalPath: library/tcpip/src
  security: NON_SECURE
  type: HEADER
  userChecksum: E483D94FDF38E11A37653D16DCF2261A
- generatedChecksum: 4CF4A86296482D5331331BA301C20BB2
  logicalPath: config/default
  name: interrupts.h
  physicalPath: ''
  security: NON_SECURE
  type: HEADER
  userChecksum: 4CF4A86296482D5331331BA301C20BB2
- generatedChecksum: DA36D91DA4951931C8023B68D22F969D
  logicalPath: config/default/library/tcpip
  name: iperf.h
  physicalPath: library/tcpip
  security: NON_SECURE
  type: HEADER
  userChecksum: DA36D91DA4951931C8023B68D22F969D
- generatedChecksum: 4D85CCC6B81B358A4BBA15FFDB03BD23
  logicalPath: config/default/library/tcpip/src
  name: iperf_manager.h
  physicalPath: library/tcpip/src
  security: NON_SECURE
  type: HEADER
  userChecksum: 4D85CCC6B81B358A4BBA15FFDB03BD23
- generatedChecksum: 27E94F52D3AE95A9A4F5A71E78D246F4
  logicalPath: config/default/library/tcpip
  name: ipv4.h
  physicalPath: library/tcpip
  security: NON_SECURE
  type: HEADER
  userChecksum: 27E94F52D3AE95A9A4F5A71E78D246F4
- generatedChecksum: 62C571F7CFDBF9EE60A2BBB98A11F78B
  logicalPath: config/default/library/tcpip/src
  name: ipv4_manager.h
  physicalPath: library/tcpip/src
  security: NON_SECURE
  type: HEADER
  userChecksum: 62C571F7CFDBF9EE60A2BBB98A11F78B
- generatedChecksum: 7E412586F5D649FE535CA680095D8073
  logicalPath: config/default/library/tcpip/src
  name: ipv4_private.h
  physicalPath: library/tcpip/src
  security: NON_SECURE
  type: HEADER
  userChecksum: 7E412586F5D649FE535CA680095D8073
- generatedChecksum: F2852D95E6F294034C6349820C86E4FE
  logicalPath: config/default/library/tcpip
  name: ipv6.h
  physicalPath: library/tcpip
  security: NON_SECURE
  type: HEADER
  userChecksum: F2852D95E6F294034C6349820C86E4FE
- generatedChecksum: 5A8BAED78CF961169B211E15AE4C94FC
  logicalPath: config/default/library/tcpip/src
  name: ipv6_manager.h
  physicalPath: library/tcpip/src
  security: NON_SECURE
  type: HEADER
  userChecksum: 5A8BAED78CF961169B211E15AE4C94FC
- generatedChecksum: 061DE00A92364E78F280B2917ECE2F60
  logicalPath: config/default/library/tcpip/src
  name: ipv6_private.h
  physicalPath: library/tcpip/src
  security: NON_SECURE
  type: HEADER
  userChecksum: 061DE00A92364E78F280B2917ECE2F60
- generatedChecksum: F2C9FCDD2BC6947D734604AD47740798
  logicalPath: config/default/library/tcpip/src
  name: link_list.h
  physicalPath: library/tcpip/src
  security: NON_SECURE
  type: HEADER
  userChecksum: F2C9FCDD2BC6947D734604AD47740798
- generatedChecksum: 58875A2FBF6B0502B6D3B8B5C47F3815
  logicalPath: FreeRTOS/Source/include
  name: list.h
  physicalPath: ../../third_party/rtos/FreeRTOS/Source/include
  security: NON_SECURE
  type: HEADER
  userChecksum: 58875A2FBF6B0502B6D3B8B5C47F3815
- generatedChecksum: D89BA50A67F1BBB1D108A4C6E527FC2F
  logicalPath: config/default/library/tcpip
  name: lldp.h
  physicalPath: library/tcpip
  security: NON_SECURE
  type: HEADER
  userChecksum: D89BA50A67F1BBB1D108A4C6E527FC2F
- generatedChecksum: 48C78FE545F27130FFDEC3346D4198D0
  logicalPath: config/default/library/tcpip/src
  name: lldp_manager.h
  physicalPath: library/tcpip/src
  security: NON_SECURE
  type: HEADER
  userChecksum: 48C78FE545F27130FFDEC3346D4198D0
- generatedChecksum: 3BB97AA63C2C749A8E0E0CCB71069EE5
  logicalPath: config/default/library/tcpip/src
  name: lldp_private.h
  physicalPath: library/tcpip/src
  security: NON_SECURE
  type: HEADER
  userChecksum: 3BB97AA63C2C749A8E0E0CCB71069EE5
- generatedChecksum: 38843E3789FC642552BCA71C39116136
  logicalPath: config/default/library/tcpip/src
  name: lldp_tlv.h
  physicalPath: library/tcpip/src
  security: NON_SECURE
  type: HEADER
  userChecksum: 38843E3789FC642552BCA71C39116136
- generatedChecksum: 5D9D0A05D32C97E2E625020E1795C7F1
  logicalPath: FreeRTOS/Source/include
  name: message_buffer.h
  physicalPath: ../../third_party/rtos/FreeRTOS/Source/include
  security: NON_SECURE
  type: HEADER
  userChecksum: 5D9D0A05D32C97E2E625020E1795C7F1
- generatedChecksum: A34AAAD9F0BD596E8FF78D86FD64F869
  logicalPath: FreeRTOS/Source/include
  name: mpu_prototypes.h
  physicalPath: ../../third_party/rtos/FreeRTOS/Source/include
  security: NON_SECURE
  type: HEADER
  userChecksum: A34AAAD9F0BD596E8FF78D86FD64F869
- generatedChecksum: 2ECEDD5114F296955777187904C449C7
  logicalPath: FreeRTOS/Source/include
  name: mpu_wrappers.h
  physicalPath: ../../third_party/rtos/FreeRTOS/Source/include
  security: NON_SECURE
  type: HEADER
  userChecksum: 2ECEDD5114F296955777187904C449C7
- generatedChecksum: 7A1FF906C6F6D1599139F3F80FE03574
  logicalPath: third_party/wolfMQTT/wolfmqtt
  name: mqtt_client.h
  physicalPath: ../../third_party/wolfMQTT/wolfmqtt
  security: NON_SECURE
  type: HEADER
  userChecksum: 7A1FF906C6F6D1599139F3F80FE03574
- generatedChecksum: 27AB8D156118B0A484304F91A6222557
  logicalPath: config/default/third_party_adapter/wolfMQTT/src
  name: mqtt_net_glue.h
  physicalPath: third_party_adapter/wolfMQTT/src
  security: NON_SECURE
  type: HEADER
  userChecksum: 27AB8D156118B0A484304F91A6222557
- generatedChecksum: 1D0683B6A4ADB3744D5EA789A94190A8
  logicalPath: third_party/wolfMQTT/wolfmqtt
  name: mqtt_packet.h
  physicalPath: ../../third_party/wolfMQTT/wolfmqtt
  security: NON_SECURE
  type: HEADER
  userChecksum: 1D0683B6A4ADB3744D5EA789A94190A8
- generatedChecksum: 5900707CEEDF72B73F304D91798685A8
  logicalPath: third_party/wolfMQTT/wolfmqtt
  name: mqtt_socket.h
  physicalPath: ../../third_party/wolfMQTT/wolfmqtt
  security: NON_SECURE
  type: HEADER
  userChecksum: 5900707CEEDF72B73F304D91798685A8
- generatedChecksum: CB241AF50AC4F0E3021CA9EA1B8A28AE
  logicalPath: third_party/wolfMQTT/wolfmqtt
  name: mqtt_types.h
  physicalPath: ../../third_party/wolfMQTT/wolfmqtt
  security: NON_SECURE
  type: HEADER
  userChecksum: CB241AF50AC4F0E3021CA9EA1B8A28AE
- generatedChecksum: F74D8EB5B501CEF184B30ED0D76F7AFB
  logicalPath: config/default/library/tcpip
  name: nbns.h
  physicalPath: library/tcpip
  security: NON_SECURE
  type: HEADER
  userChecksum: F74D8EB5B501CEF184B30ED0D76F7AFB
- generatedChecksum: 505DE4951BBA35D84E1DB15433A35085
  logicalPath: config/default/library/tcpip/src
  name: nbns_manager.h
  physicalPath: library/tcpip/src
  security: NON_SECURE
  type: HEADER
  userChecksum: 505DE4951BBA35D84E1DB15433A35085
- generatedChecksum: BA047E84015C1FF0DABD36FF0839D614
  logicalPath: config/default/library/tcpip
  name: ndp.h
  physicalPath: library/tcpip
  security: NON_SECURE
  type: HEADER
  userChecksum: BA047E84015C1FF0DABD36FF0839D614
- generatedChecksum: 21FB337F6D1F4C064D3603A92A88E3DE
  logicalPath: config/default/library/tcpip/src
  name: ndp_manager.h
  physicalPath: library/tcpip/src
  security: NON_SECURE
  type: HEADER
  userChecksum: 21FB337F6D1F4C064D3603A92A88E3DE
- generatedChecksum: 6E73DB6B8412D0A3D6A5948633037D9B
  logicalPath: config/default/library/tcpip/src
  name: ndp_private.h
  physicalPath: library/tcpip/src
  security: NON_SECURE
  type: HEADER
  userChecksum: 6E73DB6B8412D0A3D6A5948633037D9B
- generatedChecksum: 9C7B93F14DCA9A65FFBCCC11A746F42C
  logicalPath: config/default/net_pres/pres
  name: net_pres.h
  physicalPath: net_pres/pres
  security: NON_SECURE
  type: HEADER
  userChecksum: 9C7B93F14DCA9A65FFBCCC11A746F42C
- generatedChecksum: EAF3E7458B04813DFB158666690E65CA
  logicalPath: config/default/net_pres/pres
  name: net_pres_certstore.h
  physicalPath: net_pres/pres
  security: NON_SECURE
  type: HEADER
  userChecksum: EAF3E7458B04813DFB158666690E65CA
- generatedChecksum: BF6A1F560F30C49B2A88BDC1FFC1489F
  logicalPath: config/default/net_pres/pres
  name: net_pres_enc_glue.h
  physicalPath: net_pres/pres
  security: NON_SECURE
  type: HEADER
  userChecksum: BF6A1F560F30C49B2A88BDC1FFC1489F
- generatedChecksum: 510172705D6CDAC183C642DED5A1555B
  logicalPath: config/default/net_pres/pres
  name: net_pres_encryptionproviderapi.h
  physicalPath: net_pres/pres
  security: NON_SECURE
  type: HEADER
  userChecksum: 510172705D6CDAC183C642DED5A1555B
- generatedChecksum: 42B97A2C6FA6CBF712077A348ABE4874
  logicalPath: config/default/net_pres/pres/src
  name: net_pres_local.h
  physicalPath: net_pres/pres/src
  security: NON_SECURE
  type: HEADER
  userChecksum: 42B97A2C6FA6CBF712077A348ABE4874
- generatedChecksum: 311078E799B0E84F215551B723990BCC
  logicalPath: config/default/net_pres/pres
  name: net_pres_socketapi.h
  physicalPath: net_pres/pres
  security: NON_SECURE
  type: HEADER
  userChecksum: 311078E799B0E84F215551B723990BCC
- generatedChecksum: 5C1F40CF3CAA8303928880AE9B70D613
  logicalPath: config/default/net_pres/pres
  name: net_pres_socketapiconversion.h
  physicalPath: net_pres/pres
  security: NON_SECURE
  type: HEADER
  userChecksum: 5C1F40CF3CAA8303928880AE9B70D613
- generatedChecksum: 49A48E22747D17062EF09B0458744E2F
  logicalPath: config/default/net_pres/pres
  name: net_pres_transportapi.h
  physicalPath: net_pres/pres
  security: NON_SECURE
  type: HEADER
  userChecksum: 49A48E22747D17062EF09B0458744E2F
- generatedChecksum: A0F6CC80F1D784640339E67F3532A62F
  logicalPath: config/default/library/tcpip/src
  name: oahash.h
  physicalPath: library/tcpip/src
  security: NON_SECURE
  type: HEADER
  userChecksum: A0F6CC80F1D784640339E67F3532A62F
- generatedChecksum: F0AD88762263B7CB89B02AB4F5876059
  logicalPath: config/default/osal
  name: osal.h
  physicalPath: osal
  security: NON_SECURE
  type: HEADER
  userChecksum: F0AD88762263B7CB89B02AB4F5876059
- generatedChecksum: 167A43EFF8A31441EBF85AC77958A30B
  logicalPath: config/default/osal
  name: osal_definitions.h
  physicalPath: osal
  security: NON_SECURE
  type: HEADER
  userChecksum: 167A43EFF8A31441EBF85AC77958A30B
- generatedChecksum: 9D6F205ECFDB2028C5CF766B52B5B7B2
  logicalPath: config/default/osal
  name: osal_freertos.h
  physicalPath: osal
  security: NON_SECURE
  type: HEADER
  userChecksum: 9D6F205ECFDB2028C5CF766B52B5B7B2
- generatedChecksum: 7066CC390335CF75126E2A50C46E3BDD
  logicalPath: config/default/peripheral/clk
  name: plib_clk.h
  physicalPath: peripheral/clk
  security: NON_SECURE
  type: HEADER
  userChecksum: 7066CC390335CF75126E2A50C46E3BDD
- generatedChecksum: 2712EE363EC8AC102002609F5B5F3DCF
  logicalPath: config/default/peripheral/coretimer
  name: plib_coretimer.h
  physicalPath: peripheral/coretimer
  security: NON_SECURE
  type: HEADER
  userChecksum: 2712EE363EC8AC102002609F5B5F3DCF
- generatedChecksum: 37436424B3DFA2A4948662880FFD2E29
  logicalPath: config/default/peripheral/evic
  name: plib_evic.h
  physicalPath: peripheral/evic
  security: NON_SECURE
  type: HEADER
  userChecksum: 37436424B3DFA2A4948662880FFD2E29
- generatedChecksum: 2283CA653AAC60A6A5D8F69EDCE9DE51
  logicalPath: config/default/peripheral/gpio
  name: plib_gpio.h
  physicalPath: peripheral/gpio
  security: NON_SECURE
  type: HEADER
  userChecksum: C5558F9FC30E71EC2FC8D78A0C24C831
- generatedChecksum: 62FBC878743DB699BADD3CF9BC5D10AD
  logicalPath: config/default/peripheral/i2c/master
  name: plib_i2c1_master.h
  physicalPath: peripheral/i2c/master
  security: NON_SECURE
  type: HEADER
  userChecksum: 62FBC878743DB699BADD3CF9BC5D10AD
- generatedChecksum: B963C6FE44292A1C4A14C3BA5BE95AEE
  logicalPath: config/default/peripheral/i2c/master
  name: plib_i2c_master_common.h
  physicalPath: peripheral/i2c/master
  security: NON_SECURE
  type: HEADER
  userChecksum: B963C6FE44292A1C4A14C3BA5BE95AEE
- generatedChecksum: 3499C9E490F6FD905560BC9FC706492F
  logicalPath: config/default/peripheral/rtcc
  name: plib_rtcc.h
  physicalPath: peripheral/rtcc
  security: NON_SECURE
  type: HEADER
  userChecksum: 3499C9E490F6FD905560BC9FC706492F
- generatedChecksum: 27EFFF00EA5DD882C446A714F0D9CE9E
  logicalPath: config/default/peripheral/spi/spi_master
  name: plib_spi1_master.h
  physicalPath: peripheral/spi/spi_master
  security: NON_SECURE
  type: HEADER
  userChecksum: 27EFFF00EA5DD882C446A714F0D9CE9E
- generatedChecksum: 313B7DAD62CC03B8E819E8DA3675EC88
  logicalPath: config/default/peripheral/spi/spi_master
  name: plib_spi4_master.h
  physicalPath: peripheral/spi/spi_master
  security: NON_SECURE
  type: HEADER
  userChecksum: 313B7DAD62CC03B8E819E8DA3675EC88
- generatedChecksum: CFA758C8B7258190473EF7C60C4BA4E9
  logicalPath: config/default/peripheral/spi/spi_master
  name: plib_spi_master_common.h
  physicalPath: peripheral/spi/spi_master
  security: NON_SECURE
  type: HEADER
  userChecksum: CFA758C8B7258190473EF7C60C4BA4E9
- generatedChecksum: 612994C7F3C27F2CFA2621C1F65D4068
  logicalPath: config/default/peripheral/tmr
  name: plib_tmr2.h
  physicalPath: peripheral/tmr
  security: NON_SECURE
  type: HEADER
  userChecksum: 612994C7F3C27F2CFA2621C1F65D4068
- generatedChecksum: D948F2CE092CAB556EF299D3CCD83A55
  logicalPath: config/default/peripheral/tmr
  name: plib_tmr_common.h
  physicalPath: peripheral/tmr
  security: NON_SECURE
  type: HEADER
  userChecksum: D948F2CE092CAB556EF299D3CCD83A55
- generatedChecksum: C82A00629B805038004FA06636D81FA9
  logicalPath: config/default/peripheral/uart
  name: plib_uart4.h
  physicalPath: peripheral/uart
  security: NON_SECURE
  type: HEADER
  userChecksum: C82A00629B805038004FA06636D81FA9
- generatedChecksum: 91611515A95D92B82B7F4064C16D122B
  logicalPath: config/default/peripheral/uart
  name: plib_uart_common.h
  physicalPath: peripheral/uart
  security: NON_SECURE
  type: HEADER
  userChecksum: 91611515A95D92B82B7F4064C16D122B
- generatedChecksum: 9C90A94077F62F71141B144757F04E7E
  logicalPath: config/default/driver/usb/usbfs/src
  name: plib_usbfs.h
  physicalPath: driver/usb/usbfs/src
  security: NON_SECURE
  type: HEADER
  userChecksum: 9C90A94077F62F71141B144757F04E7E
- generatedChecksum: 9B4B2B2E7722D50697564E6D6E4F9E04
  logicalPath: config/default/driver/usb/usbfs/src
  name: plib_usbfs_header.h
  physicalPath: driver/usb/usbfs/src
  security: NON_SECURE
  type: HEADER
  userChecksum: 9B4B2B2E7722D50697564E6D6E4F9E04
- generatedChecksum: 98626E177D4D71A23295E51F40944F69
  logicalPath: config/default/peripheral/wdt
  name: plib_wdt.h
  physicalPath: peripheral/wdt
  security: NON_SECURE
  type: HEADER
  userChecksum: 98626E177D4D71A23295E51F40944F69
- generatedChecksum: 8DD6C24BF18C96BDC016D9165DF88FEB
  logicalPath: FreeRTOS/Source/include
  name: portable.h
  physicalPath: ../../third_party/rtos/FreeRTOS/Source/include
  security: NON_SECURE
  type: HEADER
  userChecksum: 8DD6C24BF18C96BDC016D9165DF88FEB
- generatedChecksum: 784F6ECB27E5FFF7F926718D777F0310
  logicalPath: FreeRTOS/Source/portable/MPLAB/PIC32MX
  name: portmacro.h
  physicalPath: ../../third_party/rtos/FreeRTOS/Source/portable/MPLAB/PIC32MX
  security: NON_SECURE
  type: HEADER
  userChecksum: 784F6ECB27E5FFF7F926718D777F0310
- generatedChecksum: 99A9BD4D90230B49C97BBCEE121C1182
  logicalPath: FreeRTOS/Source/include
  name: projdefs.h
  physicalPath: ../../third_party/rtos/FreeRTOS/Source/include
  security: NON_SECURE
  type: HEADER
  userChecksum: 99A9BD4D90230B49C97BBCEE121C1182
- generatedChecksum: F917F55E280C54C23A7541A76AC34225
  logicalPath: FreeRTOS/Source/include
  name: queue.h
  physicalPath: ../../third_party/rtos/FreeRTOS/Source/include
  security: NON_SECURE
  type: HEADER
  userChecksum: F917F55E280C54C23A7541A76AC34225
- generatedChecksum: 9E71D345C6F5A276C502502C87316EA5
  logicalPath: config/default/usb
  name: scsi.h
  physicalPath: usb
  security: NON_SECURE
  type: HEADER
  userChecksum: 9E71D345C6F5A276C502502C87316EA5
- generatedChecksum: D7426A4807316E4BB5540458F6F4C68F
  logicalPath: FreeRTOS/Source/include
  name: semphr.h
  physicalPath: ../../third_party/rtos/FreeRTOS/Source/include
  security: NON_SECURE
  type: HEADER
  userChecksum: D7426A4807316E4BB5540458F6F4C68F
- generatedChecksum: B1AA2E72F90746AB70AFE8CF4DBA42B9
  logicalPath: config/default/library/tcpip
  name: smtp.h
  physicalPath: library/tcpip
  security: NON_SECURE
  type: HEADER
  userChecksum: B1AA2E72F90746AB70AFE8CF4DBA42B9
- generatedChecksum: 6D2BB6A5D58CC35A95443580CBB02254
  logicalPath: config/default/library/tcpip/src
  name: smtp_manager.h
  physicalPath: library/tcpip/src
  security: NON_SECURE
  type: HEADER
  userChecksum: 6D2BB6A5D58CC35A95443580CBB02254
- generatedChecksum: 91B6B736C185E19C0924B3B0024BE5CF
  logicalPath: config/default/library/tcpip
  name: smtpc.h
  physicalPath: library/tcpip
  security: NON_SECURE
  type: HEADER
  userChecksum: 91B6B736C185E19C0924B3B0024BE5CF
- generatedChecksum: 53D3CA5D22986C4C69C6B8E90955A66A
  logicalPath: config/default/library/tcpip/src
  name: smtpc_manager.h
  physicalPath: library/tcpip/src
  security: NON_SECURE
  type: HEADER
  userChecksum: 53D3CA5D22986C4C69C6B8E90955A66A
- generatedChecksum: D4D661DE4353D67F4763BE692178A078
  logicalPath: config/default/library/tcpip/src
  name: smtpc_private.h
  physicalPath: library/tcpip/src
  security: NON_SECURE
  type: HEADER
  userChecksum: D4D661DE4353D67F4763BE692178A078
- generatedChecksum: 1225171B7AFDAC2F2FBFDD3E19B54488
  logicalPath: config/default/library/tcpip
  name: snmp.h
  physicalPath: library/tcpip
  security: NON_SECURE
  type: HEADER
  userChecksum: 1225171B7AFDAC2F2FBFDD3E19B54488
- generatedChecksum: EDD37296FBE09BD07F7BE53A8F015BBE
  logicalPath: config/default/library/tcpip/src
  name: snmp_manager.h
  physicalPath: library/tcpip/src
  security: NON_SECURE
  type: HEADER
  userChecksum: EDD37296FBE09BD07F7BE53A8F015BBE
- generatedChecksum: F34B891E9DE36AD7C2FFC02B57BF01DC
  logicalPath: config/default/library/tcpip/src
  name: snmp_private.h
  physicalPath: library/tcpip/src
  security: NON_SECURE
  type: HEADER
  userChecksum: F34B891E9DE36AD7C2FFC02B57BF01DC
- generatedChecksum: 3D02DCB41F684F6C36B774883264201F
  logicalPath: config/default/library/tcpip
  name: snmpv3.h
  physicalPath: library/tcpip
  security: NON_SECURE
  type: HEADER
  userChecksum: 3D02DCB41F684F6C36B774883264201F
- generatedChecksum: 3337D044F519EA39F86B10A570514DE4
  logicalPath: config/default/library/tcpip/src
  name: snmpv3_private.h
  physicalPath: library/tcpip/src
  security: NON_SECURE
  type: HEADER
  userChecksum: 3337D044F519EA39F86B10A570514DE4
- generatedChecksum: 1B619FAD725FD94C7875701747E847DB
  logicalPath: config/default/library/tcpip
  name: sntp.h
  physicalPath: library/tcpip
  security: NON_SECURE
  type: HEADER
  userChecksum: 1B619FAD725FD94C7875701747E847DB
- generatedChecksum: E7848F0E802A91F23FCACF31EB9320C6
  logicalPath: config/default/library/tcpip/src
  name: sntp_manager.h
  physicalPath: library/tcpip/src
  security: NON_SECURE
  type: HEADER
  userChecksum: E7848F0E802A91F23FCACF31EB9320C6
- generatedChecksum: 634A3DF879F184ABC5F96107F46AC4B2
  logicalPath: FreeRTOS/Source/include
  name: stack_macros.h
  physicalPath: ../../third_party/rtos/FreeRTOS/Source/include
  security: NON_SECURE
  type: HEADER
  userChecksum: 634A3DF879F184ABC5F96107F46AC4B2
- generatedChecksum: A652AC7D4938BE16F535BA3C90C86463
  logicalPath: FreeRTOS/Source/include
  name: stream_buffer.h
  physicalPath: ../../third_party/rtos/FreeRTOS/Source/include
  security: NON_SECURE
  type: HEADER
  userChecksum: A652AC7D4938BE16F535BA3C90C86463
- generatedChecksum: 712D1407BC82CB6B3C4C44FED4F14D26
  logicalPath: config/default/system/command
  name: sys_command.h
  physicalPath: system/command
  security: NON_SECURE
  type: HEADER
  userChecksum: 712D1407BC82CB6B3C4C44FED4F14D26
- generatedChecksum: 3AE819DFC5376F6E9AD0427596F24644
  logicalPath: config/default/system/console
  name: sys_console.h
  physicalPath: system/console
  security: NON_SECURE
  type: HEADER
  userChecksum: 3AE819DFC5376F6E9AD0427596F24644
- generatedChecksum: FADDA086C6C4E8FD7EBCE117438767A6
  logicalPath: config/default/system/debug
  name: sys_debug.h
  physicalPath: system/debug
  security: NON_SECURE
  type: HEADER
  userChecksum: FADDA086C6C4E8FD7EBCE117438767A6
- generatedChecksum: 45C173FBC598D95FA76B147486A15177
  logicalPath: config/default/system/dma
  name: sys_dma.h
  physicalPath: system/dma
  security: NON_SECURE
  type: HEADER
  userChecksum: 45C173FBC598D95FA76B147486A15177
- generatedChecksum: 42E557EFE638D7A736FB88AA84F085F1
  logicalPath: config/default/system/dma
  name: sys_dma_mapping.h
  physicalPath: system/dma
  security: NON_SECURE
  type: HEADER
  userChecksum: 42E557EFE638D7A736FB88AA84F085F1
- generatedChecksum: 3C2FCAAF130CAB88EC50389CC09A916A
  logicalPath: config/default/system/fs
  name: sys_fs.h
  physicalPath: system/fs
  security: NON_SECURE
  type: HEADER
  userChecksum: 3C2FCAAF130CAB88EC50389CC09A916A
- generatedChecksum: 0D9FE9035E3AA8082C5657240106F2DC
  logicalPath: config/default/system/fs
  name: sys_fs_fat_interface.h
  physicalPath: system/fs
  security: NON_SECURE
  type: HEADER
  userChecksum: 0D9FE9035E3AA8082C5657240106F2DC
- generatedChecksum: 0D162D1868A187FDC092657020E668D8
  logicalPath: config/default/system/fs
  name: sys_fs_local.h
  physicalPath: system/fs/src
  security: NON_SECURE
  type: HEADER
  userChecksum: 0D162D1868A187FDC092657020E668D8
- generatedChecksum: C57A4CE87A00A891A99A4248ADEE0D2E
  logicalPath: config/default/system/fs
  name: sys_fs_media_manager.h
  physicalPath: system/fs
  security: NON_SECURE
  type: HEADER
  userChecksum: C57A4CE87A00A891A99A4248ADEE0D2E
- generatedChecksum: E50782BD59B15F2EAAF53AAD818793EE
  logicalPath: config/default/system/fs
  name: sys_fs_media_manager_local.h
  physicalPath: system/fs/src
  security: NON_SECURE
  type: HEADER
  userChecksum: E50782BD59B15F2EAAF53AAD818793EE
- generatedChecksum: 821A17F3E8B2B33F953ED3352A3FF1E9
  logicalPath: config/default/library/tcpip/src/common
  name: sys_fs_shell.h
  physicalPath: library/tcpip/src/common
  security: NON_SECURE
  type: HEADER
  userChecksum: 821A17F3E8B2B33F953ED3352A3FF1E9
- generatedChecksum: 47330C2D8F204B2B69F8A86240A564B6
  logicalPath: config/default/system/int
  name: sys_int.h
  physicalPath: system/int
  security: NON_SECURE
  type: HEADER
  userChecksum: 47330C2D8F204B2B69F8A86240A564B6
- generatedChecksum: FC7B55936A09E0CA1395AE4DFB1A188F
  logicalPath: config/default/system/int
  name: sys_int_mapping.h
  physicalPath: system/int
  security: NON_SECURE
  type: HEADER
  userChecksum: FC7B55936A09E0CA1395AE4DFB1A188F
- generatedChecksum: CA912FFB954F083A561D0CF98AA2C7EC
  logicalPath: config/default/system/ports
  name: sys_ports.h
  physicalPath: system/ports
  security: NON_SECURE
  type: HEADER
  userChecksum: CA912FFB954F083A561D0CF98AA2C7EC
- generatedChecksum: BC6E1661BF4CAC21B70F5F56A0D7BBDB
  logicalPath: config/default/system/ports
  name: sys_ports_mapping.h
  physicalPath: system/ports
  security: NON_SECURE
  type: HEADER
  userChecksum: BC6E1661BF4CAC21B70F5F56A0D7BBDB
- generatedChecksum: 6D24D4A49FB538EF64ED967FAFF624E3
  logicalPath: config/default/system
  name: sys_random_h2_adapter.h
  physicalPath: system
  security: NON_SECURE
  type: HEADER
  userChecksum: 6D24D4A49FB538EF64ED967FAFF624E3
- generatedChecksum: 8E43BD17134E69982826F202D0AB42C5
  logicalPath: config/default/system/reset
  name: sys_reset.h
  physicalPath: system/reset
  security: NON_SECURE
  type: HEADER
  userChecksum: 8E43BD17134E69982826F202D0AB42C5
- generatedChecksum: 466D676839280C0E7FC2CC6F78BA6EE9
  logicalPath: config/default/system/time
  name: sys_time.h
  physicalPath: system/time
  security: NON_SECURE
  type: HEADER
  userChecksum: 466D676839280C0E7FC2CC6F78BA6EE9
- generatedChecksum: 9463F9BBF69C9593FF3B30F8BC587234
  logicalPath: config/default/system/time
  name: sys_time_definitions.h
  physicalPath: system/time
  security: NON_SECURE
  type: HEADER
  userChecksum: 9463F9BBF69C9593FF3B30F8BC587234
- generatedChecksum: 5759BC3BC97149366A972C56C337B7C0
  logicalPath: config/default/system
  name: sys_time_h2_adapter.h
  physicalPath: system
  security: NON_SECURE
  type: HEADER
  userChecksum: 5759BC3BC97149366A972C56C337B7C0
- generatedChecksum: C7A6D8C5408A42EB1CD2CB277E6EFBF4
  logicalPath: config/default/system/time
  name: sys_time_local.h
  physicalPath: system/time/src
  security: NON_SECURE
  type: HEADER
  userChecksum: C7A6D8C5408A42EB1CD2CB277E6EFBF4
- generatedChecksum: BE95B4F134C5C929787B9DA6FDBF3501
  logicalPath: config/default/system
  name: system.h
  physicalPath: system
  security: NON_SECURE
  type: HEADER
  userChecksum: BE95B4F134C5C929787B9DA6FDBF3501
- generatedChecksum: C3F5136D520DAC4416512EBFCCA023C3
  logicalPath: config/default/system
  name: system_common.h
  physicalPath: system
  security: NON_SECURE
  type: HEADER
  userChecksum: C3F5136D520DAC4416512EBFCCA023C3
- generatedChecksum: C46D4E1219266DE6FE3A1DE9BB5AE390
  logicalPath: config/default
  name: system_config.h
  physicalPath: ''
  security: NON_SECURE
  type: HEADER
  userChecksum: C46D4E1219266DE6FE3A1DE9BB5AE390
- generatedChecksum: 8B63F287FA72CE91B257CF1A0BAF36B7
  logicalPath: config/default
  name: system_definitions.h
  physicalPath: ''
  security: NON_SECURE
  type: HEADER
  userChecksum: 8B63F287FA72CE91B257CF1A0BAF36B7
- generatedChecksum: A1CB3454D5A9393479E09211BEEDDD49
  logicalPath: config/default/system
  name: system_media.h
  physicalPath: system
  security: NON_SECURE
  type: HEADER
  userChecksum: A1CB3454D5A9393479E09211BEEDDD49
- generatedChecksum: 1C75A8A6B60598A2FD0D533F57839B72
  logicalPath: config/default/system
  name: system_module.h
  physicalPath: system
  security: NON_SECURE
  type: HEADER
  userChecksum: 1C75A8A6B60598A2FD0D533F57839B72
- generatedChecksum: 0A58B32A7058D0599EC5F6E3B33D42E6
  logicalPath: FreeRTOS/Source/include
  name: task.h
  physicalPath: ../../third_party/rtos/FreeRTOS/Source/include
  security: NON_SECURE
  type: HEADER
  userChecksum: 0A58B32A7058D0599EC5F6E3B33D42E6
- generatedChecksum: 3994BECFD7FB92AB29BC3499BEC66F40
  logicalPath: config/default/library/tcpip
  name: tcp.h
  physicalPath: library/tcpip
  security: NON_SECURE
  type: HEADER
  userChecksum: 3994BECFD7FB92AB29BC3499BEC66F40
- generatedChecksum: 503C152D38F9AC23E029DE786FFE29EA
  logicalPath: config/default/library/tcpip/src
  name: tcp_manager.h
  physicalPath: library/tcpip/src
  security: NON_SECURE
  type: HEADER
  userChecksum: 503C152D38F9AC23E029DE786FFE29EA
- generatedChecksum: B08B1392542365A5E9A327B6C21155EC
  logicalPath: config/default/library/tcpip/src
  name: tcp_private.h
  physicalPath: library/tcpip/src
  security: NON_SECURE
  type: HEADER
  userChecksum: B08B1392542365A5E9A327B6C21155EC
- generatedChecksum: 855F0ED2BC1AAC611A6C63B8DA855825
  logicalPath: config/default/library/tcpip
  name: tcpip.h
  physicalPath: library/tcpip
  security: NON_SECURE
  type: HEADER
  userChecksum: 855F0ED2BC1AAC611A6C63B8DA855825
- generatedChecksum: 60B94F95E8C1F65E61E54288D55B0319
  logicalPath: config/default/library/tcpip
  name: tcpip_announce.h
  physicalPath: library/tcpip
  security: NON_SECURE
  type: HEADER
  userChecksum: 60B94F95E8C1F65E61E54288D55B0319
- generatedChecksum: CBA5A392519C82BA1B3C6D7EE3EC23B4
  logicalPath: config/default/library/tcpip/src
  name: tcpip_announce_manager.h
  physicalPath: library/tcpip/src
  security: NON_SECURE
  type: HEADER
  userChecksum: CBA5A392519C82BA1B3C6D7EE3EC23B4
- generatedChecksum: 8549105657E4FB1E2B30B1DFFEED8EB1
  logicalPath: config/default/library/tcpip
  name: tcpip_commands.h
  physicalPath: library/tcpip
  security: NON_SECURE
  type: HEADER
  userChecksum: 8549105657E4FB1E2B30B1DFFEED8EB1
- generatedChecksum: 449AF820A7E6416D61E1B9286CDBEE28
  logicalPath: config/default/library/tcpip/src
  name: tcpip_commands_manager.h
  physicalPath: library/tcpip/src
  security: NON_SECURE
  type: HEADER
  userChecksum: 449AF820A7E6416D61E1B9286CDBEE28
- generatedChecksum: 8818362006682B0BBDC5B87A51197F64
  logicalPath: config/default/library/tcpip
  name: tcpip_common_ports.h
  physicalPath: library/tcpip
  security: NON_SECURE
  type: HEADER
  userChecksum: 8818362006682B0BBDC5B87A51197F64
- generatedChecksum: BC85FF1CE38E30C04FAC560923E6BFCB
  logicalPath: config/default/library/tcpip
  name: tcpip_ethernet.h
  physicalPath: library/tcpip
  security: NON_SECURE
  type: HEADER
  userChecksum: BC85FF1CE38E30C04FAC560923E6BFCB
- generatedChecksum: 1D610E638E927D1C08DC2110C2A48705
  logicalPath: config/default/library/tcpip
  name: tcpip_heap.h
  physicalPath: library/tcpip
  security: NON_SECURE
  type: HEADER
  userChecksum: 1D610E638E927D1C08DC2110C2A48705
- generatedChecksum: B63AE7CF196BA5A8452F964F369B843A
  logicalPath: config/default/library/tcpip/src
  name: tcpip_heap_alloc.h
  physicalPath: library/tcpip/src
  security: NON_SECURE
  type: HEADER
  userChecksum: B63AE7CF196BA5A8452F964F369B843A
- generatedChecksum: 0CF2711B1B9B89985D4FF6132D13DB21
  logicalPath: config/default/library/tcpip
  name: tcpip_helpers.h
  physicalPath: library/tcpip
  security: NON_SECURE
  type: HEADER
  userChecksum: 0CF2711B1B9B89985D4FF6132D13DB21
- generatedChecksum: 3FB4AF6DF0E1AFAAC7AB7D042672EC20
  logicalPath: config/default/library/tcpip/src
  name: tcpip_helpers_private.h
  physicalPath: library/tcpip/src
  security: NON_SECURE
  type: HEADER
  userChecksum: 3FB4AF6DF0E1AFAAC7AB7D042672EC20
- generatedChecksum: 50C3D66DE3A97CBE94D4EC2858233E06
  logicalPath: config/default/library/tcpip
  name: tcpip_mac.h
  physicalPath: library/tcpip
  security: NON_SECURE
  type: HEADER
  userChecksum: 50C3D66DE3A97CBE94D4EC2858233E06
- generatedChecksum: F7969FE2EDC637424E363FD8D5F894E4
  logicalPath: config/default/library/tcpip
  name: tcpip_mac_bridge.h
  physicalPath: library/tcpip
  security: NON_SECURE
  type: HEADER
  userChecksum: F7969FE2EDC637424E363FD8D5F894E4
- generatedChecksum: E293518EF5BA0DF251C449FAA69D54A5
  logicalPath: config/default/library/tcpip/src
  name: tcpip_mac_bridge_manager.h
  physicalPath: library/tcpip/src
  security: NON_SECURE
  type: HEADER
  userChecksum: E293518EF5BA0DF251C449FAA69D54A5
- generatedChecksum: 2E946E4B94B4E221CBF8379C477C8C0F
  logicalPath: config/default/library/tcpip/src
  name: tcpip_mac_bridge_private.h
  physicalPath: library/tcpip/src
  security: NON_SECURE
  type: HEADER
  userChecksum: 2E946E4B94B4E221CBF8379C477C8C0F
- generatedChecksum: B6463E74CE05923177C5E63F7A49B8FE
  logicalPath: config/default/library/tcpip
  name: tcpip_mac_object.h
  physicalPath: library/tcpip
  security: NON_SECURE
  type: HEADER
  userChecksum: B6463E74CE05923177C5E63F7A49B8FE
- generatedChecksum: D153D36DD26B2A604A9F1E009C4DF9C7
  logicalPath: config/default/library/tcpip
  name: tcpip_manager.h
  physicalPath: library/tcpip
  security: NON_SECURE
  type: HEADER
  userChecksum: D153D36DD26B2A604A9F1E009C4DF9C7
- generatedChecksum: 19FF3E64AD3301090BCC333A77362B83
  logicalPath: config/default/library/tcpip/src
  name: tcpip_manager_control.h
  physicalPath: library/tcpip/src
  security: NON_SECURE
  type: HEADER
  userChecksum: 19FF3E64AD3301090BCC333A77362B83
- generatedChecksum: 83EFCE7145F216BE6FBD29723ED46E38
  logicalPath: config/default/library/tcpip/src
  name: tcpip_module_manager.h
  physicalPath: library/tcpip/src
  security: NON_SECURE
  type: HEADER
  userChecksum: 83EFCE7145F216BE6FBD29723ED46E38
- generatedChecksum: B35526101B0CB88DB7C403BE62AEEAAF
  logicalPath: config/default/library/tcpip/src
  name: tcpip_notify.h
  physicalPath: library/tcpip/src
  security: NON_SECURE
  type: HEADER
  userChecksum: B35526101B0CB88DB7C403BE62AEEAAF
- generatedChecksum: 2A6E661202CE3D09B01F741202C8E824
  logicalPath: config/default/library/tcpip/src
  name: tcpip_packet.h
  physicalPath: library/tcpip/src
  security: NON_SECURE
  type: HEADER
  userChecksum: 2A6E661202CE3D09B01F741202C8E824
- generatedChecksum: 5FED6D0E86566E81DB8D81E2E908C17D
  logicalPath: config/default/library/tcpip/src
  name: tcpip_private.h
  physicalPath: library/tcpip/src
  security: NON_SECURE
  type: HEADER
  userChecksum: 5FED6D0E86566E81DB8D81E2E908C17D
- generatedChecksum: 1359095D6A60712C36D5DA1C8DC53BE3
  logicalPath: config/default/library/tcpip
  name: tcpip_reboot.h
  physicalPath: library/tcpip
  security: NON_SECURE
  type: HEADER
  userChecksum: 1359095D6A60712C36D5DA1C8DC53BE3
- generatedChecksum: 397EE1D2248B97023D95A3209E6519D9
  logicalPath: config/default/library/tcpip/src
  name: tcpip_reboot_manager.h
  physicalPath: library/tcpip/src
  security: NON_SECURE
  type: HEADER
  userChecksum: 397EE1D2248B97023D95A3209E6519D9
- generatedChecksum: C7099420A1310B9C86A707E884FDFE6A
  logicalPath: config/default/library/tcpip/src
  name: tcpip_types.h
  physicalPath: library/tcpip/src
  security: NON_SECURE
  type: HEADER
  userChecksum: C7099420A1310B9C86A707E884FDFE6A
- generatedChecksum: 2699E9A9020B5587BC5BCE9FB2760EBF
  logicalPath: config/default/library/tcpip
  name: telnet.h
  physicalPath: library/tcpip
  security: NON_SECURE
  type: HEADER
  userChecksum: 2699E9A9020B5587BC5BCE9FB2760EBF
- generatedChecksum: 44B46E07175370FD1301244348BA5FF1
  logicalPath: config/default/library/tcpip/src
  name: telnet_manager.h
  physicalPath: library/tcpip/src
  security: NON_SECURE
  type: HEADER
  userChecksum: 44B46E07175370FD1301244348BA5FF1
- generatedChecksum: BC321E8C017453FD5D84DADA3BD30564
  logicalPath: config/default/library/tcpip
  name: tftpc.h
  physicalPath: library/tcpip
  security: NON_SECURE
  type: HEADER
  userChecksum: BC321E8C017453FD5D84DADA3BD30564
- generatedChecksum: 58971D61817236E727FF8264989191AA
  logicalPath: config/default/library/tcpip/src
  name: tftpc_manager.h
  physicalPath: library/tcpip/src
  security: NON_SECURE
  type: HEADER
  userChecksum: 58971D61817236E727FF8264989191AA
- generatedChecksum: 5FE8DAC31F9D4252CA982B8AE6E7232A
  logicalPath: config/default/library/tcpip/src
  name: tftpc_private.h
  physicalPath: library/tcpip/src
  security: NON_SECURE
  type: HEADER
  userChecksum: 5FE8DAC31F9D4252CA982B8AE6E7232A
- generatedChecksum: 24B5F4E19C395CDB02D5EE3AFC463C17
  logicalPath: config/default/library/tcpip
  name: tftps.h
  physicalPath: library/tcpip
  security: NON_SECURE
  type: HEADER
  userChecksum: 24B5F4E19C395CDB02D5EE3AFC463C17
- generatedChecksum: 943997E32B0EE2CF35426F1ECC44D1EA
  logicalPath: config/default/library/tcpip/src
  name: tftps_manager.h
  physicalPath: library/tcpip/src
  security: NON_SECURE
  type: HEADER
  userChecksum: 943997E32B0EE2CF35426F1ECC44D1EA
- generatedChecksum: 93955E68585F91EE382E3EFCEDB120EE
  logicalPath: config/default/library/tcpip/src
  name: tftps_private.h
  physicalPath: library/tcpip/src
  security: NON_SECURE
  type: HEADER
  userChecksum: 93955E68585F91EE382E3EFCEDB120EE
- generatedChecksum: 41176F771D22559EFCE82398FCF33668
  logicalPath: FreeRTOS/Source/include
  name: timers.h
  physicalPath: ../../third_party/rtos/FreeRTOS/Source/include
  security: NON_SECURE
  type: HEADER
  userChecksum: 41176F771D22559EFCE82398FCF33668
- generatedChecksum: 7DC91D6D376C98802C9C2990432DE9B7
  logicalPath: config/default
  name: toolchain_specifics.h
  physicalPath: ''
  security: NON_SECURE
  type: HEADER
  userChecksum: 7DC91D6D376C98802C9C2990432DE9B7
- generatedChecksum: EE829CB1052F07A99917543C82E56FB8
  logicalPath: config/default/library/tcpip
  name: udp.h
  physicalPath: library/tcpip
  security: NON_SECURE
  type: HEADER
  userChecksum: EE829CB1052F07A99917543C82E56FB8
- generatedChecksum: 1D7FBFA79EAE512971BD54237F6F71F4
  logicalPath: config/default/library/tcpip/src
  name: udp_manager.h
  physicalPath: library/tcpip/src
  security: NON_SECURE
  type: HEADER
  userChecksum: 1D7FBFA79EAE512971BD54237F6F71F4
- generatedChecksum: 1BE5CD7E50CEB1FF6CF784A708E39318
  logicalPath: config/default/library/tcpip/src
  name: udp_private.h
  physicalPath: library/tcpip/src
  security: NON_SECURE
  type: HEADER
  userChecksum: 1BE5CD7E50CEB1FF6CF784A708E39318
- generatedChecksum: 7614490532C606BCAFEC5F729FDBEDAD
  logicalPath: config/default/driver/usb/usbfs/src/templates
  name: usb_ALL_Interrupt_Default.h
  physicalPath: driver/usb/usbfs/src/templates
  security: NON_SECURE
  type: HEADER
  userChecksum: 7614490532C606BCAFEC5F729FDBEDAD
- generatedChecksum: 745B8DF89B5477EADA7B0786F1491B4C
  logicalPath: config/default/driver/usb/usbfs/src/templates
  name: usb_ALL_Interrupt_Unsupported.h
  physicalPath: driver/usb/usbfs/src/templates
  security: NON_SECURE
  type: HEADER
  userChecksum: 745B8DF89B5477EADA7B0786F1491B4C
- generatedChecksum: 86227AAF459AA8589F50247D54E63EA1
  logicalPath: config/default/driver/usb/usbfs/src/templates
  name: usb_ActivityPending_Default.h
  physicalPath: driver/usb/usbfs/src/templates
  security: NON_SECURE
  type: HEADER
  userChecksum: 86227AAF459AA8589F50247D54E63EA1
- generatedChecksum: E86B513BFC354B734122E715E9673569
  logicalPath: config/default/driver/usb/usbfs/src/templates
  name: usb_ActivityPending_Unsupported.h
  physicalPath: driver/usb/usbfs/src/templates
  security: NON_SECURE
  type: HEADER
  userChecksum: E86B513BFC354B734122E715E9673569
- generatedChecksum: FCDC292B30CBCAE218A51F68C3ADD7B2
  logicalPath: config/default/driver/usb/usbfs/src/templates
  name: usb_AutomaticSuspend_Default.h
  physicalPath: driver/usb/usbfs/src/templates
  security: NON_SECURE
  type: HEADER
  userChecksum: FCDC292B30CBCAE218A51F68C3ADD7B2
- generatedChecksum: 4C2B2ED2E7617D6EFD806454B03D7BF8
  logicalPath: config/default/driver/usb/usbfs/src/templates
  name: usb_AutomaticSuspend_Unsupported.h
  physicalPath: driver/usb/usbfs/src/templates
  security: NON_SECURE
  type: HEADER
  userChecksum: 4C2B2ED2E7617D6EFD806454B03D7BF8
- generatedChecksum: 09A5E6FEB6CADD075F370EC5FF2733C8
  logicalPath: config/default/driver/usb/usbfs/src/templates
  name: usb_BDTBaseAddress_Default.h
  physicalPath: driver/usb/usbfs/src/templates
  security: NON_SECURE
  type: HEADER
  userChecksum: 09A5E6FEB6CADD075F370EC5FF2733C8
- generatedChecksum: 6ECAB19200B7B025B56DFC85D15369F4
  logicalPath: config/default/driver/usb/usbfs/src/templates
  name: usb_BDTBaseAddress_Unsupported.h
  physicalPath: driver/usb/usbfs/src/templates
  security: NON_SECURE
  type: HEADER
  userChecksum: 6ECAB19200B7B025B56DFC85D15369F4
- generatedChecksum: F11B46BCB5572997D5531BA60D331A21
  logicalPath: config/default/driver/usb/usbfs/src/templates
  name: usb_BDTFunctions_PIC32.h
  physicalPath: driver/usb/usbfs/src/templates
  security: NON_SECURE
  type: HEADER
  userChecksum: F11B46BCB5572997D5531BA60D331A21
- generatedChecksum: 62A57CF6942AF8E8B60B3B8771C53306
  logicalPath: config/default/driver/usb/usbfs/src/templates
  name: usb_BDTFunctions_Unsupported.h
  physicalPath: driver/usb/usbfs/src/templates
  security: NON_SECURE
  type: HEADER
  userChecksum: 62A57CF6942AF8E8B60B3B8771C53306
- generatedChecksum: EFDB80DE1EC77D54E76D2F3291142209
  logicalPath: config/default/driver/usb/usbfs/src/templates
  name: usb_BufferFreeze_Default.h
  physicalPath: driver/usb/usbfs/src/templates
  security: NON_SECURE
  type: HEADER
  userChecksum: EFDB80DE1EC77D54E76D2F3291142209
- generatedChecksum: 44A4CF72E79B206503A570A7C6B15CAD
  logicalPath: config/default/driver/usb/usbfs/src/templates
  name: usb_BufferFreeze_Unsupported.h
  physicalPath: driver/usb/usbfs/src/templates
  security: NON_SECURE
  type: HEADER
  userChecksum: 44A4CF72E79B206503A570A7C6B15CAD
- generatedChecksum: 10843324F0C3C37B9419EAD8FFB4B75E
  logicalPath: config/default/driver/usb/usbfs/src/templates
  name: usb_DeviceAddress_Default.h
  physicalPath: driver/usb/usbfs/src/templates
  security: NON_SECURE
  type: HEADER
  userChecksum: 10843324F0C3C37B9419EAD8FFB4B75E
- generatedChecksum: 54BFBC3F08C0D4752DF74799F4C9B449
  logicalPath: config/default/driver/usb/usbfs/src/templates
  name: usb_DeviceAddress_Unsupported.h
  physicalPath: driver/usb/usbfs/src/templates
  security: NON_SECURE
  type: HEADER
  userChecksum: 54BFBC3F08C0D4752DF74799F4C9B449
- generatedChecksum: 4D2630F1B71886CAF9503FE025AFF5EE
  logicalPath: config/default/driver/usb/usbfs/src/templates
  name: usb_EP0LowSpeedConnect_Default.h
  physicalPath: driver/usb/usbfs/src/templates
  security: NON_SECURE
  type: HEADER
  userChecksum: 4D2630F1B71886CAF9503FE025AFF5EE
- generatedChecksum: 19518D9996047F6F94CA2AA4902E9E7B
  logicalPath: config/default/driver/usb/usbfs/src/templates
  name: usb_EP0LowSpeedConnect_Unsupported.h
  physicalPath: driver/usb/usbfs/src/templates
  security: NON_SECURE
  type: HEADER
  userChecksum: 19518D9996047F6F94CA2AA4902E9E7B
- generatedChecksum: E7025F9FBA2413ED2AD4522B66DEDA9C
  logicalPath: config/default/driver/usb/usbfs/src/templates
  name: usb_EP0NAKRetry_Default.h
  physicalPath: driver/usb/usbfs/src/templates
  security: NON_SECURE
  type: HEADER
  userChecksum: E7025F9FBA2413ED2AD4522B66DEDA9C
- generatedChecksum: BE22CA76DBE5C80AB3E7A7D9C2B3C0DC
  logicalPath: config/default/driver/usb/usbfs/src/templates
  name: usb_EP0NAKRetry_Unsupported.h
  physicalPath: driver/usb/usbfs/src/templates
  security: NON_SECURE
  type: HEADER
  userChecksum: BE22CA76DBE5C80AB3E7A7D9C2B3C0DC
- generatedChecksum: A172572AB4A8E1076DC9543FCCD4CB65
  logicalPath: config/default/driver/usb/usbfs/src/templates
  name: usb_EPnControlTransfer_Default.h
  physicalPath: driver/usb/usbfs/src/templates
  security: NON_SECURE
  type: HEADER
  userChecksum: A172572AB4A8E1076DC9543FCCD4CB65
- generatedChecksum: 74220D1C57F227F60349E1B08EE06A98
  logicalPath: config/default/driver/usb/usbfs/src/templates
  name: usb_EPnControlTransfer_Unsupported.h
  physicalPath: driver/usb/usbfs/src/templates
  security: NON_SECURE
  type: HEADER
  userChecksum: 74220D1C57F227F60349E1B08EE06A98
- generatedChecksum: B2A9683B9EF845D691DBE7F61594836F
  logicalPath: config/default/driver/usb/usbfs/src/templates
  name: usb_EPnHandshake_Default.h
  physicalPath: driver/usb/usbfs/src/templates
  security: NON_SECURE
  type: HEADER
  userChecksum: B2A9683B9EF845D691DBE7F61594836F
- generatedChecksum: 7AA89118BF93853F1958AD8736D28B61
  logicalPath: config/default/driver/usb/usbfs/src/templates
  name: usb_EPnHandshake_Unsupported.h
  physicalPath: driver/usb/usbfs/src/templates
  security: NON_SECURE
  type: HEADER
  userChecksum: 7AA89118BF93853F1958AD8736D28B61
- generatedChecksum: 350B868A638E3EC481AA29B73D81622F
  logicalPath: config/default/driver/usb/usbfs/src/templates
  name: usb_EPnRxEnableEnhanced_PIC32.h
  physicalPath: driver/usb/usbfs/src/templates
  security: NON_SECURE
  type: HEADER
  userChecksum: 350B868A638E3EC481AA29B73D81622F
- generatedChecksum: B6C1F8C688E949B477CAE40A758D928C
  logicalPath: config/default/driver/usb/usbfs/src/templates
  name: usb_EPnRxEnableEnhanced_Unsupported.h
  physicalPath: driver/usb/usbfs/src/templates
  security: NON_SECURE
  type: HEADER
  userChecksum: B6C1F8C688E949B477CAE40A758D928C
- generatedChecksum: 34F5E74F7D49EE64CD92F9BEE2B8F7C9
  logicalPath: config/default/driver/usb/usbfs/src/templates
  name: usb_EPnStall_Default.h
  physicalPath: driver/usb/usbfs/src/templates
  security: NON_SECURE
  type: HEADER
  userChecksum: 34F5E74F7D49EE64CD92F9BEE2B8F7C9
- generatedChecksum: 0D383886A9E3659029E372AA369E04F0
  logicalPath: config/default/driver/usb/usbfs/src/templates
  name: usb_EPnStall_Unsupported.h
  physicalPath: driver/usb/usbfs/src/templates
  security: NON_SECURE
  type: HEADER
  userChecksum: 0D383886A9E3659029E372AA369E04F0
- generatedChecksum: A05787C93C388FF70D13BEDD156E9165
  logicalPath: config/default/driver/usb/usbfs/src/templates
  name: usb_EPnTxRx_Default.h
  physicalPath: driver/usb/usbfs/src/templates
  security: NON_SECURE
  type: HEADER
  userChecksum: A05787C93C388FF70D13BEDD156E9165
- generatedChecksum: F46E538F66BC67AB746DE5DC08335D18
  logicalPath: config/default/driver/usb/usbfs/src/templates
  name: usb_EPnTxRx_Unsupported.h
  physicalPath: driver/usb/usbfs/src/templates
  security: NON_SECURE
  type: HEADER
  userChecksum: F46E538F66BC67AB746DE5DC08335D18
- generatedChecksum: D91EF7D6D66318175EC902AC10B07541
  logicalPath: config/default/driver/usb/usbfs/src/templates
  name: usb_ERR_InterruptStatus_Default.h
  physicalPath: driver/usb/usbfs/src/templates
  security: NON_SECURE
  type: HEADER
  userChecksum: D91EF7D6D66318175EC902AC10B07541
- generatedChecksum: 13AFF95C87EB4F8C70972D2B27BD9315
  logicalPath: config/default/driver/usb/usbfs/src/templates
  name: usb_ERR_InterruptStatus_Unsupported.h
  physicalPath: driver/usb/usbfs/src/templates
  security: NON_SECURE
  type: HEADER
  userChecksum: 13AFF95C87EB4F8C70972D2B27BD9315
- generatedChecksum: 3266F05DC49F47AD8983E08695D228EB
  logicalPath: config/default/driver/usb/usbfs/src/templates
  name: usb_ERR_Interrupt_Default.h
  physicalPath: driver/usb/usbfs/src/templates
  security: NON_SECURE
  type: HEADER
  userChecksum: 3266F05DC49F47AD8983E08695D228EB
- generatedChecksum: 29467AB44D0B20289667E5E8696C81B6
  logicalPath: config/default/driver/usb/usbfs/src/templates
  name: usb_ERR_Interrupt_Unsupported.h
  physicalPath: driver/usb/usbfs/src/templates
  security: NON_SECURE
  type: HEADER
  userChecksum: 29467AB44D0B20289667E5E8696C81B6
- generatedChecksum: 6E6CFAA5FB99D2D377C7B7F194423195
  logicalPath: config/default/driver/usb/usbfs/src/templates
  name: usb_EyePattern_Default.h
  physicalPath: driver/usb/usbfs/src/templates
  security: NON_SECURE
  type: HEADER
  userChecksum: 6E6CFAA5FB99D2D377C7B7F194423195
- generatedChecksum: BAEA73C8C521F1ACCE710D4512F3FAE6
  logicalPath: config/default/driver/usb/usbfs/src/templates
  name: usb_EyePattern_Unsupported.h
  physicalPath: driver/usb/usbfs/src/templates
  security: NON_SECURE
  type: HEADER
  userChecksum: BAEA73C8C521F1ACCE710D4512F3FAE6
- generatedChecksum: 76B9CFCF5B06444BD689EAA1F22AD71D
  logicalPath: config/default/driver/usb/usbfs/src/templates
  name: usb_FrameNumber_Default.h
  physicalPath: driver/usb/usbfs/src/templates
  security: NON_SECURE
  type: HEADER
  userChecksum: 76B9CFCF5B06444BD689EAA1F22AD71D
- generatedChecksum: 408CB74019E2380B2BCD429049F1B981
  logicalPath: config/default/driver/usb/usbfs/src/templates
  name: usb_FrameNumber_Unsupported.h
  physicalPath: driver/usb/usbfs/src/templates
  security: NON_SECURE
  type: HEADER
  userChecksum: 408CB74019E2380B2BCD429049F1B981
- generatedChecksum: 6EB33D0EB60209522E91C7B805AB25DC
  logicalPath: config/default/driver/usb/usbfs/src/templates
  name: usb_GEN_InterruptStatus_Default.h
  physicalPath: driver/usb/usbfs/src/templates
  security: NON_SECURE
  type: HEADER
  userChecksum: 6EB33D0EB60209522E91C7B805AB25DC
- generatedChecksum: 3360F2D7F303E408D8F581FC44A6DE3C
  logicalPath: config/default/driver/usb/usbfs/src/templates
  name: usb_GEN_InterruptStatus_Unsupported.h
  physicalPath: driver/usb/usbfs/src/templates
  security: NON_SECURE
  type: HEADER
  userChecksum: 3360F2D7F303E408D8F581FC44A6DE3C
- generatedChecksum: 980B20058F736B07F71A233527B55809
  logicalPath: config/default/driver/usb/usbfs/src/templates
  name: usb_GEN_Interrupt_Default.h
  physicalPath: driver/usb/usbfs/src/templates
  security: NON_SECURE
  type: HEADER
  userChecksum: 980B20058F736B07F71A233527B55809
- generatedChecksum: 54F632B5226E20C4685BB6069D995765
  logicalPath: config/default/driver/usb/usbfs/src/templates
  name: usb_GEN_Interrupt_Unsupported.h
  physicalPath: driver/usb/usbfs/src/templates
  security: NON_SECURE
  type: HEADER
  userChecksum: 54F632B5226E20C4685BB6069D995765
- generatedChecksum: 048544CF9B6F68C7EBD7D78ECBFEDA59
  logicalPath: config/default/driver/usb/usbfs/src/templates
  name: usb_HostBusyWithToken_Default.h
  physicalPath: driver/usb/usbfs/src/templates
  security: NON_SECURE
  type: HEADER
  userChecksum: 048544CF9B6F68C7EBD7D78ECBFEDA59
- generatedChecksum: B6C53AAB216360C9BBAE677366BC9890
  logicalPath: config/default/driver/usb/usbfs/src/templates
  name: usb_HostBusyWithToken_Unsupported.h
  physicalPath: driver/usb/usbfs/src/templates
  security: NON_SECURE
  type: HEADER
  userChecksum: B6C53AAB216360C9BBAE677366BC9890
- generatedChecksum: 65F3253730F0AA1AB36C4512A52794FB
  logicalPath: config/default/driver/usb/usbfs/src/templates
  name: usb_HostGeneratesReset_Default.h
  physicalPath: driver/usb/usbfs/src/templates
  security: NON_SECURE
  type: HEADER
  userChecksum: 65F3253730F0AA1AB36C4512A52794FB
- generatedChecksum: 6623665EA8F1449332618060E20D196B
  logicalPath: config/default/driver/usb/usbfs/src/templates
  name: usb_HostGeneratesReset_Unsupported.h
  physicalPath: driver/usb/usbfs/src/templates
  security: NON_SECURE
  type: HEADER
  userChecksum: 6623665EA8F1449332618060E20D196B
- generatedChecksum: B7CF190EB03BA59B93C489D8994926CC
  logicalPath: config/default/driver/usb/usbfs/src/templates
  name: usb_LastDirection_Default.h
  physicalPath: driver/usb/usbfs/src/templates
  security: NON_SECURE
  type: HEADER
  userChecksum: B7CF190EB03BA59B93C489D8994926CC
- generatedChecksum: 625AB3F01773E229D8CCFEB1006C7CD2
  logicalPath: config/default/driver/usb/usbfs/src/templates
  name: usb_LastDirection_Unsupported.h
  physicalPath: driver/usb/usbfs/src/templates
  security: NON_SECURE
  type: HEADER
  userChecksum: 625AB3F01773E229D8CCFEB1006C7CD2
- generatedChecksum: 60810E675DF84F16A02B0D0EAD6D7F63
  logicalPath: config/default/driver/usb/usbfs/src/templates
  name: usb_LastEndpoint_Default.h
  physicalPath: driver/usb/usbfs/src/templates
  security: NON_SECURE
  type: HEADER
  userChecksum: 60810E675DF84F16A02B0D0EAD6D7F63
- generatedChecksum: 82F028EFD6BEB1C80F9B9292831A65D9
  logicalPath: config/default/driver/usb/usbfs/src/templates
  name: usb_LastEndpoint_Unsupported.h
  physicalPath: driver/usb/usbfs/src/templates
  security: NON_SECURE
  type: HEADER
  userChecksum: 82F028EFD6BEB1C80F9B9292831A65D9
- generatedChecksum: 9A2A474F2CFED908346E87E36C2D79F2
  logicalPath: config/default/driver/usb/usbfs/src/templates
  name: usb_LastPingPong_Default.h
  physicalPath: driver/usb/usbfs/src/templates
  security: NON_SECURE
  type: HEADER
  userChecksum: 9A2A474F2CFED908346E87E36C2D79F2
- generatedChecksum: 058EAAB655838DA5289D587DDAC32CAA
  logicalPath: config/default/driver/usb/usbfs/src/templates
  name: usb_LastPingPong_Unsupported.h
  physicalPath: driver/usb/usbfs/src/templates
  security: NON_SECURE
  type: HEADER
  userChecksum: 058EAAB655838DA5289D587DDAC32CAA
- generatedChecksum: 33E50D04E85804ADE7171A8376C42424
  logicalPath: config/default/driver/usb/usbfs/src/templates
  name: usb_LastTransactionDetails_Default.h
  physicalPath: driver/usb/usbfs/src/templates
  security: NON_SECURE
  type: HEADER
  userChecksum: 33E50D04E85804ADE7171A8376C42424
- generatedChecksum: EB7BEA76434E3AC1308285FBAB01B13F
  logicalPath: config/default/driver/usb/usbfs/src/templates
  name: usb_LastTransactionDetails_Unsupported.h
  physicalPath: driver/usb/usbfs/src/templates
  security: NON_SECURE
  type: HEADER
  userChecksum: EB7BEA76434E3AC1308285FBAB01B13F
- generatedChecksum: 5F6530DD94D66305E91832C300436D8C
  logicalPath: config/default/driver/usb/usbfs/src/templates
  name: usb_LiveJState_Default.h
  physicalPath: driver/usb/usbfs/src/templates
  security: NON_SECURE
  type: HEADER
  userChecksum: 5F6530DD94D66305E91832C300436D8C
- generatedChecksum: 6B6273C05B158120AC6D38BAAF663D3B
  logicalPath: config/default/driver/usb/usbfs/src/templates
  name: usb_LiveJState_Unsupported.h
  physicalPath: driver/usb/usbfs/src/templates
  security: NON_SECURE
  type: HEADER
  userChecksum: 6B6273C05B158120AC6D38BAAF663D3B
- generatedChecksum: 30F8DF0AF32CB6257839B7AEB898A46F
  logicalPath: config/default/driver/usb/usbfs/src/templates
  name: usb_LiveSingleEndedZero_Default.h
  physicalPath: driver/usb/usbfs/src/templates
  security: NON_SECURE
  type: HEADER
  userChecksum: 30F8DF0AF32CB6257839B7AEB898A46F
- generatedChecksum: 134E5C20D6CA8AED76B4037DB9A09AB7
  logicalPath: config/default/driver/usb/usbfs/src/templates
  name: usb_LiveSingleEndedZero_Unsupported.h
  physicalPath: driver/usb/usbfs/src/templates
  security: NON_SECURE
  type: HEADER
  userChecksum: 134E5C20D6CA8AED76B4037DB9A09AB7
- generatedChecksum: 2422148BA969698923685283F46C92E9
  logicalPath: config/default/driver/usb/usbfs/src/templates
  name: usb_ModuleBusy_Default.h
  physicalPath: driver/usb/usbfs/src/templates
  security: NON_SECURE
  type: HEADER
  userChecksum: 2422148BA969698923685283F46C92E9
- generatedChecksum: 167442BF79AE0D75BFBED51A312C6EE1
  logicalPath: config/default/driver/usb/usbfs/src/templates
  name: usb_ModuleBusy_Unsupported.h
  physicalPath: driver/usb/usbfs/src/templates
  security: NON_SECURE
  type: HEADER
  userChecksum: 167442BF79AE0D75BFBED51A312C6EE1
- generatedChecksum: E2E2A24D754C152E0273ACE870235103
  logicalPath: config/default/driver/usb/usbfs/src/templates
  name: usb_ModulePower_32Bit16Bit.h
  physicalPath: driver/usb/usbfs/src/templates
  security: NON_SECURE
  type: HEADER
  userChecksum: E2E2A24D754C152E0273ACE870235103
- generatedChecksum: A53F5BE327C6E2F3D218EF3C9F5C6EEF
  logicalPath: config/default/driver/usb/usbfs/src/templates
  name: usb_ModulePower_Unsupported.h
  physicalPath: driver/usb/usbfs/src/templates
  security: NON_SECURE
  type: HEADER
  userChecksum: A53F5BE327C6E2F3D218EF3C9F5C6EEF
- generatedChecksum: E2B3981232810DC07B12BB0F413B787B
  logicalPath: config/default/driver/usb/usbfs/src/templates
  name: usb_NextTokenSpeed_Default.h
  physicalPath: driver/usb/usbfs/src/templates
  security: NON_SECURE
  type: HEADER
  userChecksum: E2B3981232810DC07B12BB0F413B787B
- generatedChecksum: 9513196BF2783545C5B62361D943437D
  logicalPath: config/default/driver/usb/usbfs/src/templates
  name: usb_NextTokenSpeed_Unsupported.h
  physicalPath: driver/usb/usbfs/src/templates
  security: NON_SECURE
  type: HEADER
  userChecksum: 9513196BF2783545C5B62361D943437D
- generatedChecksum: 38BE3303E98314C627DA67AC076C3F09
  logicalPath: config/default/driver/usb/usbfs/src/templates
  name: usb_OTG_ASessionValid_Default.h
  physicalPath: driver/usb/usbfs/src/templates
  security: NON_SECURE
  type: HEADER
  userChecksum: 38BE3303E98314C627DA67AC076C3F09
- generatedChecksum: 5352DFCC35451F729FA0911037218B86
  logicalPath: config/default/driver/usb/usbfs/src/templates
  name: usb_OTG_ASessionValid_Unsupported.h
  physicalPath: driver/usb/usbfs/src/templates
  security: NON_SECURE
  type: HEADER
  userChecksum: 5352DFCC35451F729FA0911037218B86
- generatedChecksum: 36A534DD422BA20FA2AE8EFF18DA8039
  logicalPath: config/default/driver/usb/usbfs/src/templates
  name: usb_OTG_BSessionEnd_Default.h
  physicalPath: driver/usb/usbfs/src/templates
  security: NON_SECURE
  type: HEADER
  userChecksum: 36A534DD422BA20FA2AE8EFF18DA8039
- generatedChecksum: FA19A265F10A2C91948E37C137599B24
  logicalPath: config/default/driver/usb/usbfs/src/templates
  name: usb_OTG_BSessionEnd_Unsupported.h
  physicalPath: driver/usb/usbfs/src/templates
  security: NON_SECURE
  type: HEADER
  userChecksum: FA19A265F10A2C91948E37C137599B24
- generatedChecksum: 84C73320F432149F92318F74E8496122
  logicalPath: config/default/driver/usb/usbfs/src/templates
  name: usb_OTG_IDPinState_Default.h
  physicalPath: driver/usb/usbfs/src/templates
  security: NON_SECURE
  type: HEADER
  userChecksum: 84C73320F432149F92318F74E8496122
- generatedChecksum: 7128C610EC9A82EBDCBCB3BFDC6FF31E
  logicalPath: config/default/driver/usb/usbfs/src/templates
  name: usb_OTG_IDPinState_Unsupported.h
  physicalPath: driver/usb/usbfs/src/templates
  security: NON_SECURE
  type: HEADER
  userChecksum: 7128C610EC9A82EBDCBCB3BFDC6FF31E
- generatedChecksum: D1A36D8ACF5801EACF74063F1F7C8724
  logicalPath: config/default/driver/usb/usbfs/src/templates
  name: usb_OTG_InterruptStatus_Default.h
  physicalPath: driver/usb/usbfs/src/templates
  security: NON_SECURE
  type: HEADER
  userChecksum: D1A36D8ACF5801EACF74063F1F7C8724
- generatedChecksum: D551EA6473C70608F3B158FC41103424
  logicalPath: config/default/driver/usb/usbfs/src/templates
  name: usb_OTG_InterruptStatus_Unsupported.h
  physicalPath: driver/usb/usbfs/src/templates
  security: NON_SECURE
  type: HEADER
  userChecksum: D551EA6473C70608F3B158FC41103424
- generatedChecksum: 8106E66B318C78D4F5BCF81A7F9AB47A
  logicalPath: config/default/driver/usb/usbfs/src/templates
  name: usb_OTG_Interrupt_Default.h
  physicalPath: driver/usb/usbfs/src/templates
  security: NON_SECURE
  type: HEADER
  userChecksum: 8106E66B318C78D4F5BCF81A7F9AB47A
- generatedChecksum: D54E0303FC83CE7061086D7D9C416DFB
  logicalPath: config/default/driver/usb/usbfs/src/templates
  name: usb_OTG_Interrupt_Unsupported.h
  physicalPath: driver/usb/usbfs/src/templates
  security: NON_SECURE
  type: HEADER
  userChecksum: D54E0303FC83CE7061086D7D9C416DFB
- generatedChecksum: 5CE79190E2C8E1130DBA5FA0B133C905
  logicalPath: config/default/driver/usb/usbfs/src/templates
  name: usb_OTG_LineState_Default.h
  physicalPath: driver/usb/usbfs/src/templates
  security: NON_SECURE
  type: HEADER
  userChecksum: 5CE79190E2C8E1130DBA5FA0B133C905
- generatedChecksum: 39D144A10029BEF9EB84994C93C9F97C
  logicalPath: config/default/driver/usb/usbfs/src/templates
  name: usb_OTG_LineState_Unsupported.h
  physicalPath: driver/usb/usbfs/src/templates
  security: NON_SECURE
  type: HEADER
  userChecksum: 39D144A10029BEF9EB84994C93C9F97C
- generatedChecksum: 749259B13336B1A48E3A212CC8E76A10
  logicalPath: config/default/driver/usb/usbfs/src/templates
  name: usb_OTG_PullUpPullDown_Default.h
  physicalPath: driver/usb/usbfs/src/templates
  security: NON_SECURE
  type: HEADER
  userChecksum: 749259B13336B1A48E3A212CC8E76A10
- generatedChecksum: 603005C43494A7B577DDFDC072F38934
  logicalPath: config/default/driver/usb/usbfs/src/templates
  name: usb_OTG_PullUpPullDown_Unsupported.h
  physicalPath: driver/usb/usbfs/src/templates
  security: NON_SECURE
  type: HEADER
  userChecksum: 603005C43494A7B577DDFDC072F38934
- generatedChecksum: F53CDCE8B12DC50609F738356C557D7C
  logicalPath: config/default/driver/usb/usbfs/src/templates
  name: usb_OTG_SessionValid_Default.h
  physicalPath: driver/usb/usbfs/src/templates
  security: NON_SECURE
  type: HEADER
  userChecksum: F53CDCE8B12DC50609F738356C557D7C
- generatedChecksum: 2E1C89EE866754BA6E3716C01F81840A
  logicalPath: config/default/driver/usb/usbfs/src/templates
  name: usb_OTG_SessionValid_Unsupported.h
  physicalPath: driver/usb/usbfs/src/templates
  security: NON_SECURE
  type: HEADER
  userChecksum: 2E1C89EE866754BA6E3716C01F81840A
- generatedChecksum: 169EF167B1CA3EE3432083DDB9A4DF68
  logicalPath: config/default/driver/usb/usbfs/src/templates
  name: usb_OTG_VbusCharge_Default.h
  physicalPath: driver/usb/usbfs/src/templates
  security: NON_SECURE
  type: HEADER
  userChecksum: 169EF167B1CA3EE3432083DDB9A4DF68
- generatedChecksum: 83BE346B5A9706159421BA8A882BC654
  logicalPath: config/default/driver/usb/usbfs/src/templates
  name: usb_OTG_VbusCharge_Unsupported.h
  physicalPath: driver/usb/usbfs/src/templates
  security: NON_SECURE
  type: HEADER
  userChecksum: 83BE346B5A9706159421BA8A882BC654
- generatedChecksum: CCED5CAFC52EA7EBAB9C7EA633F94FBD
  logicalPath: config/default/driver/usb/usbfs/src/templates
  name: usb_OTG_VbusDischarge_Default.h
  physicalPath: driver/usb/usbfs/src/templates
  security: NON_SECURE
  type: HEADER
  userChecksum: CCED5CAFC52EA7EBAB9C7EA633F94FBD
- generatedChecksum: F18FCAF76F4FE96F560CAC9D61883E10
  logicalPath: config/default/driver/usb/usbfs/src/templates
  name: usb_OTG_VbusDischarge_Unsupported.h
  physicalPath: driver/usb/usbfs/src/templates
  security: NON_SECURE
  type: HEADER
  userChecksum: F18FCAF76F4FE96F560CAC9D61883E10
- generatedChecksum: 256E24F8D6407783D550D7EE34DC5454
  logicalPath: config/default/driver/usb/usbfs/src/templates
  name: usb_OTG_VbusPowerOnOff_Default.h
  physicalPath: driver/usb/usbfs/src/templates
  security: NON_SECURE
  type: HEADER
  userChecksum: 256E24F8D6407783D550D7EE34DC5454
- generatedChecksum: A5FDE90F969D0F5EC080DCA1336EC551
  logicalPath: config/default/driver/usb/usbfs/src/templates
  name: usb_OTG_VbusPowerOnOff_Unsupported.h
  physicalPath: driver/usb/usbfs/src/templates
  security: NON_SECURE
  type: HEADER
  userChecksum: A5FDE90F969D0F5EC080DCA1336EC551
- generatedChecksum: 09E1D9F5F5E052007AF0A26348B8F59A
  logicalPath: config/default/driver/usb/usbfs/src/templates
  name: usb_OnChipPullup_Unsupported.h
  physicalPath: driver/usb/usbfs/src/templates
  security: NON_SECURE
  type: HEADER
  userChecksum: 09E1D9F5F5E052007AF0A26348B8F59A
- generatedChecksum: E9695732C30EACDBA9345D94C37D4417
  logicalPath: config/default/driver/usb/usbfs/src/templates
  name: usb_OnChipTransceiver_Unsupported.h
  physicalPath: driver/usb/usbfs/src/templates
  security: NON_SECURE
  type: HEADER
  userChecksum: E9695732C30EACDBA9345D94C37D4417
- generatedChecksum: 4909CC4C2573CDE282AF965174A8C73F
  logicalPath: config/default/driver/usb/usbfs/src/templates
  name: usb_OpModeSelect_Default.h
  physicalPath: driver/usb/usbfs/src/templates
  security: NON_SECURE
  type: HEADER
  userChecksum: 4909CC4C2573CDE282AF965174A8C73F
- generatedChecksum: 08A0CD4EEF17F405055CD252FBCF396D
  logicalPath: config/default/driver/usb/usbfs/src/templates
  name: usb_OpModeSelect_Unsupported.h
  physicalPath: driver/usb/usbfs/src/templates
  security: NON_SECURE
  type: HEADER
  userChecksum: 08A0CD4EEF17F405055CD252FBCF396D
- generatedChecksum: D67E34356E44DDADFD0FEF511E82C4F6
  logicalPath: config/default/driver/usb/usbfs/src/templates
  name: usb_PacketTransfer_Default.h
  physicalPath: driver/usb/usbfs/src/templates
  security: NON_SECURE
  type: HEADER
  userChecksum: D67E34356E44DDADFD0FEF511E82C4F6
- generatedChecksum: 96CF545A48CBE1FD23CC65374F22816B
  logicalPath: config/default/driver/usb/usbfs/src/templates
  name: usb_PacketTransfer_Unsupported.h
  physicalPath: driver/usb/usbfs/src/templates
  security: NON_SECURE
  type: HEADER
  userChecksum: 96CF545A48CBE1FD23CC65374F22816B
- generatedChecksum: 9414911A8C7113A0DE499DAC504F8EC8
  logicalPath: config/default/driver/usb/usbfs/src/templates
  name: usb_PingPongMode_Unsupported.h
  physicalPath: driver/usb/usbfs/src/templates
  security: NON_SECURE
  type: HEADER
  userChecksum: 9414911A8C7113A0DE499DAC504F8EC8
- generatedChecksum: 36A4207833DBBB09794F91FB4CE02DE0
  logicalPath: config/default/driver/usb/usbfs/src/templates
  name: usb_ResumeSignaling_Default.h
  physicalPath: driver/usb/usbfs/src/templates
  security: NON_SECURE
  type: HEADER
  userChecksum: 36A4207833DBBB09794F91FB4CE02DE0
- generatedChecksum: F1CE5B84B9774E099FC20869BD88D848
  logicalPath: config/default/driver/usb/usbfs/src/templates
  name: usb_ResumeSignaling_Unsupported.h
  physicalPath: driver/usb/usbfs/src/templates
  security: NON_SECURE
  type: HEADER
  userChecksum: F1CE5B84B9774E099FC20869BD88D848
- generatedChecksum: 2EDA2AF4702BFC856F32A7C394F1CA3D
  logicalPath: config/default/driver/usb/usbfs/src/templates
  name: usb_SOFThreshold_Default.h
  physicalPath: driver/usb/usbfs/src/templates
  security: NON_SECURE
  type: HEADER
  userChecksum: 2EDA2AF4702BFC856F32A7C394F1CA3D
- generatedChecksum: 173533D9D44F34EAC6A43805F513C5BB
  logicalPath: config/default/driver/usb/usbfs/src/templates
  name: usb_SOFThreshold_Unsupported.h
  physicalPath: driver/usb/usbfs/src/templates
  security: NON_SECURE
  type: HEADER
  userChecksum: 173533D9D44F34EAC6A43805F513C5BB
- generatedChecksum: D130FC249330270320088204690E6E69
  logicalPath: config/default/driver/usb/usbfs/src/templates
  name: usb_SleepEntryGuard_Default.h
  physicalPath: driver/usb/usbfs/src/templates
  security: NON_SECURE
  type: HEADER
  userChecksum: D130FC249330270320088204690E6E69
- generatedChecksum: 22AF76F4008304D97083432006CE7B3C
  logicalPath: config/default/driver/usb/usbfs/src/templates
  name: usb_SleepEntryGuard_Unsupported.h
  physicalPath: driver/usb/usbfs/src/templates
  security: NON_SECURE
  type: HEADER
  userChecksum: 22AF76F4008304D97083432006CE7B3C
- generatedChecksum: 43AC410D2E57BEDBEDBA5CEB27E39C85
  logicalPath: config/default/driver/usb/usbfs/src/templates
  name: usb_SpeedControl_Unsupported.h
  physicalPath: driver/usb/usbfs/src/templates
  security: NON_SECURE
  type: HEADER
  userChecksum: 43AC410D2E57BEDBEDBA5CEB27E39C85
- generatedChecksum: D009D85E4B81A1B1C348D6B41AB33556
  logicalPath: config/default/driver/usb/usbfs/src/templates
  name: usb_StartOfFrames_Default.h
  physicalPath: driver/usb/usbfs/src/templates
  security: NON_SECURE
  type: HEADER
  userChecksum: D009D85E4B81A1B1C348D6B41AB33556
- generatedChecksum: 80E4E33CD6C02C4AF9EC825D4628B8CE
  logicalPath: config/default/driver/usb/usbfs/src/templates
  name: usb_StartOfFrames_Unsupported.h
  physicalPath: driver/usb/usbfs/src/templates
  security: NON_SECURE
  type: HEADER
  userChecksum: 80E4E33CD6C02C4AF9EC825D4628B8CE
- generatedChecksum: BFB7D5B997ADAB1B881165EBCE26C408
  logicalPath: config/default/driver/usb/usbfs/src/templates
  name: usb_StopInIdle_Default.h
  physicalPath: driver/usb/usbfs/src/templates
  security: NON_SECURE
  type: HEADER
  userChecksum: BFB7D5B997ADAB1B881165EBCE26C408
- generatedChecksum: D8718B32B3BCE26F4B03AF46971ACF34
  logicalPath: config/default/driver/usb/usbfs/src/templates
  name: usb_StopInIdle_Unsupported.h
  physicalPath: driver/usb/usbfs/src/templates
  security: NON_SECURE
  type: HEADER
  userChecksum: D8718B32B3BCE26F4B03AF46971ACF34
- generatedChecksum: D88042DD257B1A0841E72FF9E8A53768
  logicalPath: config/default/driver/usb/usbfs/src/templates
  name: usb_Suspend_Default.h
  physicalPath: driver/usb/usbfs/src/templates
  security: NON_SECURE
  type: HEADER
  userChecksum: D88042DD257B1A0841E72FF9E8A53768
- generatedChecksum: F450A2CB5B56FB19B09D89481F6B6D9C
  logicalPath: config/default/driver/usb/usbfs/src/templates
  name: usb_Suspend_Unsupported.h
  physicalPath: driver/usb/usbfs/src/templates
  security: NON_SECURE
  type: HEADER
  userChecksum: F450A2CB5B56FB19B09D89481F6B6D9C
- generatedChecksum: 37B19C89A43207CF77661935E8D2188B
  logicalPath: config/default/driver/usb/usbfs/src/templates
  name: usb_TokenEP_Default.h
  physicalPath: driver/usb/usbfs/src/templates
  security: NON_SECURE
  type: HEADER
  userChecksum: 37B19C89A43207CF77661935E8D2188B
- generatedChecksum: AAAF6430E674ED656EBD9939AF79EB82
  logicalPath: config/default/driver/usb/usbfs/src/templates
  name: usb_TokenEP_Unsupported.h
  physicalPath: driver/usb/usbfs/src/templates
  security: NON_SECURE
  type: HEADER
  userChecksum: AAAF6430E674ED656EBD9939AF79EB82
- generatedChecksum: 6B9BA1140FB58631035F927EAF5E9AE5
  logicalPath: config/default/driver/usb/usbfs/src/templates
  name: usb_TokenPID_Default.h
  physicalPath: driver/usb/usbfs/src/templates
  security: NON_SECURE
  type: HEADER
  userChecksum: 6B9BA1140FB58631035F927EAF5E9AE5
- generatedChecksum: 979F4D2846A355BE6DF6DD0D02D82AE0
  logicalPath: config/default/driver/usb/usbfs/src/templates
  name: usb_TokenPID_Unsupported.h
  physicalPath: driver/usb/usbfs/src/templates
  security: NON_SECURE
  type: HEADER
  userChecksum: 979F4D2846A355BE6DF6DD0D02D82AE0
- generatedChecksum: E67575175AA2DF30E077E4F10646158E
  logicalPath: config/default/driver/usb/usbfs/src/templates
  name: usb_UOEMonitor_Unsupported.h
  physicalPath: driver/usb/usbfs/src/templates
  security: NON_SECURE
  type: HEADER
  userChecksum: E67575175AA2DF30E077E4F10646158E
- generatedChecksum: 39659CDE2CC726544BD68544FB7EF4B2
  logicalPath: config/default/usb
  name: usb_chapter_9.h
  physicalPath: usb
  security: NON_SECURE
  type: HEADER
  userChecksum: 39659CDE2CC726544BD68544FB7EF4B2
- generatedChecksum: E7B6EAD8687A8EBC0355E0CE413B6A87
  logicalPath: config/default/usb
  name: usb_common.h
  physicalPath: usb
  security: NON_SECURE
  type: HEADER
  userChecksum: E7B6EAD8687A8EBC0355E0CE413B6A87
- generatedChecksum: 6C4A6859DB16EA8C046F995C6B6C1C6F
  logicalPath: config/default/usb/src
  name: usb_external_dependencies.h
  physicalPath: usb/src
  security: NON_SECURE
  type: HEADER
  userChecksum: 6C4A6859DB16EA8C046F995C6B6C1C6F
- generatedChecksum: 6EB8F9F4A43B9BC2C7A58585AC679650
  logicalPath: config/default/usb
  name: usb_host.h
  physicalPath: usb
  security: NON_SECURE
  type: HEADER
  userChecksum: 6EB8F9F4A43B9BC2C7A58585AC679650
- generatedChecksum: 6EBC5E4D06FC96A02ADF3B7416957DD6
  logicalPath: config/default/usb
  name: usb_host_client_driver.h
  physicalPath: usb
  security: NON_SECURE
  type: HEADER
  userChecksum: 6EBC5E4D06FC96A02ADF3B7416957DD6
- generatedChecksum: 757C8484C955543C893361992D11FD4C
  logicalPath: config/default/usb
  name: usb_host_hub_interface.h
  physicalPath: usb
  security: NON_SECURE
  type: HEADER
  userChecksum: 757C8484C955543C893361992D11FD4C
- generatedChecksum: 9A5DE9CA9F3E4B6797DB28E03D7717D5
  logicalPath: config/default/usb/src
  name: usb_host_hub_mapping.h
  physicalPath: usb/src
  security: NON_SECURE
  type: HEADER
  userChecksum: 9A5DE9CA9F3E4B6797DB28E03D7717D5
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
