marekw1986/InternetRadioPIC32DP83848/firmware/src/vs1053/vs1053.c

/*
 Copyright (C) 2023 Marek Wiecek
 High level driver for VS1053 chip, designed to operate with
 low level written by Andy Karpov.
 This program is free software; you can redistribute it and/or
 modify it under the terms of the GNU General Public License
 version 2 as published by the Free Software Foundation.
 */
 
#include <xc.h>
#include <stdio.h>
#include <stdlib.h>
#include <stdint.h>
#include <string.h>
#include <math.h>
#include <tcpip/tcpip.h>
#include <tcpip/dns.h>

#include "app.h"
#include "FreeRTOS.h"
#include "queue.h"
#include "task.h"
#include "system/debug/sys_debug.h"
#include "system/fs/sys_fs.h"
#include "vs1053.h"
#include "vs1053_low_level.h"
#include "mediainfo.h"
#include "ringbuffer.h"
#include "http_header_parser.h"
#include "../common.h"
#include "../stream_list.h"
#ifdef USE_LCD_UI
#include "../lcd/ui.h"
#include "peripheral/gpio/plib_gpio.h"
#endif

#define RECONNECT_LIMIT 3

QueueHandle_t vsQueueHandle;

static uri_t uri;
static bool loop_flag = false;
static uint16_t dir_index = 0;
static uint16_t dir_count = 0;

static SYS_FS_HANDLE fsrc = SYS_FS_HANDLE_INVALID;
static uint8_t ReconnectLimit = RECONNECT_LIMIT;
static int current_stream_ind = 1;

static TCP_SOCKET VS_Socket = INVALID_SOCKET;
static uint8_t last_volume = 0;

static StreamState_t StreamState = STREAM_HOME;
static uint8_t consecutiveReadErrors = 0;
    
typedef enum {
    DO_NOT_RECONNECT = 0,
    RECONNECT_IMMEDIATELY,
    RECONNECT_WAIT_LONG,
    RECONNECT_WAIT_SHORT
} ReconnectStrategy_t;

static ReconnectStrategy_t ReconnectStrategy = DO_NOT_RECONNECT;

static void VS1053_startPlaying(void);
static void VS1053_stopPlaying(void);
static void VS1053_handle_end_of_file (void);
static void get_uri_from_stream_id(uint16_t id, uri_t* uri);
static char* get_path_of_next_audio_file_in_currently_played_dir(void);
static uint16_t count_audio_files_in_dir(const char* path);

void VS1053_init(void) {
    VS1053_low_level_init();
    VS1053B_apply_patch();
    while ( !VS_DREQ_PIN ) {};
    vsQueueHandle = xQueueCreate(16, sizeof(vs1053cmd_t));
    if (vsQueueHandle == NULL) {
        SYS_CONSOLE_PRINT("ERROR: Can't create VS queue\r\n");
        while(1);
    }
}

void VS1053_handle(void) {   
	static uint32_t	timer;
    static IP_MULTI_ADDRESS ServerAddress;
    
	switch(StreamState)
	{
		case STREAM_HOME:
            //nothing to do here, just wait
            break;
        
        case STREAM_HTTP_BEGIN:
        {
            // Obtain the IP address associated with the radio server
            if(strlen(uri.server)) {
                TCPIP_DNS_RESULT dnsres = TCPIP_DNS_Resolve(uri.server, TCPIP_DNS_TYPE_A);
                if (dnsres < 0) {
                    StreamState = STREAM_HOME;
                    #ifdef USE_LCD_UI
                    ui_clear_content_info();
                    ui_clear_state_info();
                    #endif
                    SYS_CONSOLE_PRINT("TCPIP_DNS_Resolve error %d\r\n", dnsres);
                    break;
                }
                else if (dnsres == TCPIP_DNS_RES_NAME_IS_IPADDRESS) {
                    //TODO
                    TCPIP_Helper_StringToIPAddress(uri.server, &(ServerAddress.v4Add));
                    StreamState = STREAM_HTTP_OBTAIN_SOCKET;
                    break;
                }
                else {
                    StreamState = STREAM_HTTP_NAME_RESOLVE;
                    SYS_CONSOLE_PRINT("DNS begin: %s\r\n", uri.server);
                    ringbuffer_clear();
                    break;
                }
            }
            else {
                StreamState = STREAM_HOME;
                #ifdef USE_LCD_UI
                ui_clear_content_info();
                ui_clear_state_info();
                #endif                
                SYS_CONSOLE_PRINT("DNS uri.server empty\r\n");
                break;
            }
            SYS_CONSOLE_PRINT("TCPIP_DNS_Resolve: Something went wrong\r\n");
			break;
        }
            
        case STREAM_HTTP_NAME_RESOLVE:;
        {
            // Wait for the DNS server to return the requested IP address
            TCPIP_DNS_RESULT dnsres = TCPIP_DNS_IsResolved(uri.server, &ServerAddress, TCPIP_DNS_TYPE_A);
            if (dnsres < 0) {
                StreamState = STREAM_HOME;
                #ifdef USE_LCD_UI
                ui_clear_content_info();
                ui_clear_state_info();
                #endif
                SYS_CONSOLE_PRINT("TCPIP_DNS_IsResolved error: %d\r\n", dnsres);
                break;
            }
            else if ( dnsres == TCPIP_DNS_RES_PENDING) {
                break;
            }
            else if ( dnsres == TCPIP_DNS_RES_OK ) {
                uint8_t data[32];
                StreamState = STREAM_HTTP_OBTAIN_SOCKET;
                SYS_CONSOLE_PRINT("DNS OK\r\n");
                TCPIP_Helper_IPAddressToString(&ServerAddress.v4Add, (char*)data, 32);        
                SYS_CONSOLE_PRINT("IP address: %s\r\n", data);
                SYS_CONSOLE_PRINT("Obtaining socket\r\n");
                TCPIP_DNS_RemoveEntry(uri.server);
                break;
            }
            SYS_CONSOLE_PRINT("TCPIP_DNS_IsResolved: something went wrong\r\n");
            break;
        }
            
        case STREAM_HTTP_OBTAIN_SOCKET:
        {
            VS_Socket = TCPIP_TCP_ClientOpen(IP_ADDRESS_TYPE_IPV4, uri.port, &ServerAddress);
            
            if(VS_Socket == INVALID_SOCKET) {
                StreamState=STREAM_HTTP_CLOSE;
                ReconnectStrategy = RECONNECT_WAIT_SHORT;
                #ifdef USE_LCD_UI
                ui_update_state_info(VS1053_get_state_description());
                #endif
                SYS_CONSOLE_PRINT("Socket fail\r\n");
				break;
            }
            
            SYS_CONSOLE_PRINT("Socket obtained\r\n");
            // Increase size of RX buffer
            if (TCPIP_TCP_FifoSizeAdjust(VS_Socket, 4096, 512, TCP_ADJUST_RX_ONLY)) {
                SYS_CONSOLE_PRINT("RX buffer resized\r\n");
                StreamState = STREAM_HTTP_SOCKET_OBTAINED;
                timer = millis();
            }
            else {
                SYS_CONSOLE_PRINT("Can't resize RX buffer!\r\n");
				StreamState = STREAM_HTTP_CLOSE;
                ReconnectStrategy = RECONNECT_WAIT_SHORT;
            }
            break;
        }

		case STREAM_HTTP_SOCKET_OBTAINED:
        {
			// Wait for the remote server to accept our connection request
			if(!TCPIP_TCP_IsConnected(VS_Socket))
			{
                // Time out if too much time is spent in this state
				if((uint32_t)(millis()-timer) > 5000)
				{
					SYS_CONSOLE_PRINT("Socket timeout\r\n");
					StreamState = STREAM_HTTP_CLOSE;     //was StreamState--
                    ReconnectStrategy = DO_NOT_RECONNECT;
				}
				break;
			}
            SYS_CONSOLE_PRINT("Connected: sending request\r\n");
            StreamState = STREAM_HTTP_SEND_REQUEST;
			timer = millis();
            break;
        }
            
        case STREAM_HTTP_SEND_REQUEST:
        {
			// Make certain the socket can be written to
			if( TCPIP_TCP_PutIsReady(VS_Socket) < (49u + strlen(uri.file) + strlen(uri.server)) ) {
                if ( (uint32_t)(millis()-timer) > 5000 ) {
                    StreamState = STREAM_HTTP_CLOSE;
                    ReconnectStrategy = RECONNECT_WAIT_LONG;
                }
				break;
            }
			
			// Place the application protocol data into the transmit buffer.  For this example, we are connected to an HTTP server, so we'll send an HTTP GET request.
			TCPIP_TCP_StringPut(VS_Socket, (const uint8_t*)"GET ");
			TCPIP_TCP_StringPut(VS_Socket, (const uint8_t*)uri.file);
			TCPIP_TCP_StringPut(VS_Socket, (const uint8_t*)" HTTP/1.0\r\nHost: ");
			TCPIP_TCP_StringPut(VS_Socket, (const uint8_t*)uri.server);
			TCPIP_TCP_StringPut(VS_Socket, (const uint8_t*)"\r\nConnection: keep-alive\r\n\r\n");
            SYS_CONSOLE_PRINT("Sending headers\r\n");
            
            TCPIP_TCP_WasReset(VS_Socket);
			// Send the packet
			TCPIP_TCP_Flush(VS_Socket);
            timer = millis();
			StreamState = STREAM_HTTP_PROCESS_HEADER;
            http_prepare_parser();
			break;
        }
            
        case STREAM_HTTP_PROCESS_HEADER:
        {
			if(TCPIP_TCP_WasReset(VS_Socket))
			{
				StreamState = STREAM_HTTP_CLOSE;
                ReconnectStrategy = RECONNECT_IMMEDIATELY;
                SYS_CONSOLE_PRINT("Internet radio: socket disconnected - reseting\r\n");
				break;
			}
            
            uint8_t data[512];
            size_t w = TCPIP_TCP_ArrayGet(VS_Socket, data, sizeof(data)-1);
            if (w) {
                http_res_t http_result = http_parse_headers((char*)data, w, &uri);
                switch (http_result) {
                    case HTTP_HEADER_ERROR:
                        SYS_CONSOLE_PRINT("Parsing headers error code: %d\r\n", http_get_err_code());
                        // We have rubbish in uri from unsuccessful parsing attempt
                        // Need to be regenerated
                        get_uri_from_stream_id(current_stream_ind, &uri);
                        http_release_parser();
                        ReconnectStrategy = RECONNECT_WAIT_SHORT;
                        StreamState = STREAM_HTTP_CLOSE;
                        break;
                    case HTTP_HEADER_OK:
                        SYS_CONSOLE_PRINT("It is 200 OK\r\n");
                        // uri had been cleaned during parsin, so we need to regenerate it
                        // in case of reconnect
                        get_uri_from_stream_id(current_stream_ind, &uri);
                        http_release_parser();
                        timer = millis();
                        StreamState = STREAM_HTTP_FILL_BUFFER;     //STREAM_HTTP_GET_DATA
                        VS1053_startPlaying();
                        break;
                    case HTTP_HEADER_REDIRECTED:
                        SYS_CONSOLE_PRINT("Stream redirected\r\n");
                        http_release_parser();
                        ReconnectStrategy = RECONNECT_IMMEDIATELY;
                        StreamState = STREAM_HTTP_CLOSE;
                        break;
                    case HTTP_HEADER_IN_PROGRESS:
                        break;
                    default:
                        break;
                }
            }
            
            if ( (uint32_t)(millis()-timer) > 5000) {
                //There was no data in 5 seconds - reconnect
                SYS_CONSOLE_PRINT("Internet radio: no header timeout - reseting\r\n");
                ReconnectStrategy = RECONNECT_WAIT_SHORT;
                StreamState = STREAM_HTTP_CLOSE;
                #ifdef USE_LCD_UI
                ui_update_state_info(VS1053_get_state_description());
                #endif
            }            
            break;
        }
            
        case STREAM_HTTP_FILL_BUFFER:
        {
            uint8_t data[512];
            while (get_remaining_space_in_ringbuffer() > sizeof(data)) {
                size_t w = TCPIP_TCP_ArrayGet(VS_Socket, data, sizeof(data));
                if (w) {
                    timer = millis();
                    write_array_to_ringbuffer(data, w);
                }
                else { break; }
                taskYIELD();
            }
            
            if (get_remaining_space_in_ringbuffer() <= 128) {
                SYS_CONSOLE_PRINT("Buffer filled\r\n");
                timer = millis();
                StreamState = STREAM_HTTP_GET_DATA;
                #ifdef USE_LCD_UI
                ui_update_state_info(VS1053_get_state_description());
                #endif
                break;
            }
    
			if(TCPIP_TCP_WasReset(VS_Socket))
			{
				StreamState = STREAM_HTTP_CLOSE;
                ReconnectStrategy = RECONNECT_WAIT_LONG;
                #ifdef USE_LCD_UI
                ui_update_state_info(VS1053_get_state_description());
                #endif
                SYS_CONSOLE_PRINT("Internet radio: socket disconnected - reseting\r\n");
				// Do not break;  We might still have data in the TCP RX FIFO waiting for us
			}
    
            if ( (uint32_t)(millis()-timer) > 5000) {
                //There was no data in 5 seconds - reconnect
                SYS_CONSOLE_PRINT("Internet radio: no new data timeout - reseting\r\n");
                ReconnectStrategy = RECONNECT_WAIT_LONG;
                StreamState = STREAM_HTTP_CLOSE;
                #ifdef USE_LCD_UI
                ui_update_state_info(VS1053_get_state_description());
                #endif
            }                        
            break;
        }

		case STREAM_HTTP_GET_DATA:
        {
            uint8_t data[512];
            while (get_remaining_space_in_ringbuffer() > sizeof(data)) {
                size_t w = TCPIP_TCP_ArrayGet(VS_Socket, data, sizeof(data));
                if (w) {
                    timer = millis();
                    write_array_to_ringbuffer(data, w);
                }
                if (VS_DREQ_PIN) break;
                taskYIELD();
            }
            
            feed_ret_t feed_ret = VS1053_feed_from_buffer();
            if (feed_ret == FEED_RET_BUFFER_EMPTY) {
                StreamState = STREAM_HTTP_FILL_BUFFER;
                timer = millis();
                break;
            }
            else if (feed_ret == FEED_RET_ERR_TMOUT) {
                StreamState = STREAM_HTTP_CLOSE;
                timer = millis();
                ReconnectStrategy = DO_NOT_RECONNECT;
                break;
            }
			if(TCPIP_TCP_WasReset(VS_Socket))
			{
				StreamState = STREAM_HTTP_CLOSE;
                ReconnectStrategy = RECONNECT_WAIT_LONG;
                #ifdef USE_LCD_UI
                ui_update_state_info(VS1053_get_state_description());
                #endif
                SYS_CONSOLE_PRINT("Internet radio: socket disconnected - reseting\r\n");
				// Do not break;  We might still have data in the TCP RX FIFO waiting for us
			}
            if ( (uint32_t)(millis()-timer) > 5000) {
                //There was no data in 5 seconds - reconnect
                SYS_CONSOLE_PRINT("Internet radio: no new data timeout - reseting\r\n");
                ReconnectStrategy = RECONNECT_WAIT_LONG;
                StreamState = STREAM_HTTP_CLOSE;
                #ifdef USE_LCD_UI
                ui_update_state_info(VS1053_get_state_description());
                #endif
            }
			break;
        }
            
        case STREAM_FILE_FILL_BUFFER:
        {
            uint8_t data[512];
            while (get_remaining_space_in_ringbuffer() > sizeof(data)) {
                size_t br = SYS_FS_FileRead(fsrc, data, sizeof(data));
                if (br != -1) {
                    consecutiveReadErrors = 0;
                    if (br != 0) { write_array_to_ringbuffer(data, br); }
                    if (br < 32) {  //end of file
                        StreamState = STREAM_FILE_PLAY_REST;
                        break;
                    }
                }
                else {
                    consecutiveReadErrors++;
                    if (consecutiveReadErrors > 50) {
                        StreamState = STREAM_FILE_PLAY_REST;
                    }
                    break;
                }
                taskYIELD();
            }
            if (StreamState == STREAM_FILE_PLAY_REST) break;
            StreamState = STREAM_FILE_GET_DATA;
            #ifdef USE_LCD_UI
            ui_update_state_info(VS1053_get_state_description());
            #endif
            break;
        }
            
        case STREAM_FILE_GET_DATA:
        {
            uint8_t data[512];
            while (get_remaining_space_in_ringbuffer() > sizeof(data)) {
                int br = SYS_FS_FileRead(fsrc, data, sizeof(data));
                if ( br != -1 ) {
                    consecutiveReadErrors = 0;
                    if (br) {write_array_to_ringbuffer(data, br); }
                    if (br < 32) {     //end of file
                        StreamState = STREAM_FILE_PLAY_REST;
                        break;
                    }
                    if (VS_DREQ_PIN) break;
                }
                else {
                    consecutiveReadErrors++;
                    if (consecutiveReadErrors > 50) {
                        StreamState = STREAM_FILE_PLAY_REST;
                    }
                    break;
                }
                taskYIELD();
            }
            if (StreamState == STREAM_FILE_PLAY_REST) break;
            feed_ret_t feed_ret = VS1053_feed_from_buffer();
            if (feed_ret == FEED_RET_BUFFER_EMPTY) {
                //buffer empty
                StreamState = STREAM_FILE_FILL_BUFFER;
            }
            break;
        }
            
        case STREAM_FILE_PLAY_REST:
        {
            feed_ret_t feed_ret = VS1053_feed_from_buffer();
            if (feed_ret == FEED_RET_BUFFER_EMPTY) {
                //buffer empty
            	VS1053_handle_end_of_file();
            }
        	break;
        }
	
		case STREAM_HTTP_CLOSE:
        {
			// Close the socket so it can be used by other modules
			// For this application, we wish to stay connected, but this state will still get entered if the remote server decides to disconnect
			if (!TCPIP_TCP_Close(VS_Socket)) {
                TCPIP_TCP_Abort(VS_Socket, true);
            }
			VS_Socket = INVALID_SOCKET;
            VS1053_stopPlaying();
            switch(ReconnectStrategy) {
                case DO_NOT_RECONNECT:
                    StreamState = STREAM_HOME;
                    #ifdef USE_LCD_UI
                    ui_clear_content_info();
                    ui_clear_state_info();
                    #endif
                    break;
                case RECONNECT_IMMEDIATELY:
                    ReconnectLimit--;
                    if (ReconnectLimit > 0) {
                        StreamState = STREAM_HTTP_BEGIN;
                    }
                    else {
                        StreamState = STREAM_HOME;
                        SYS_CONSOLE_PRINT("Reconnect limit reached\r\n");
                        #ifdef USE_LCD_UI
                        ui_clear_content_info();
                        ui_clear_state_info();
                        #endif
                    }
                    break;
                case RECONNECT_WAIT_LONG:
                case RECONNECT_WAIT_SHORT:
                    ReconnectLimit--;
                    if (ReconnectLimit > 0) {
                        StreamState = STREAM_HTTP_RECONNECT_WAIT;
                    }
                    else {
                        StreamState = STREAM_HOME;
                        SYS_CONSOLE_PRINT("Reconnect limit reached\r\n");
                        #ifdef USE_LCD_UI
                        ui_clear_content_info();
                        ui_clear_state_info();
                        #endif
                    }
                    break;
                default:
                    StreamState = STREAM_HOME;
                    break;
            }
            timer = millis();
			break;
        }
            
        case STREAM_HTTP_RECONNECT_WAIT:
        {
            if ( (uint32_t)(millis()-timer) > ((ReconnectStrategy == RECONNECT_WAIT_LONG) ? (5000) : (1000)) ) {
                SYS_CONSOLE_PRINT("Internet radio: reconnecting\r\n");
                StreamState = STREAM_HTTP_BEGIN;
            }
            break;
        }
	}
    
    {
        vs1053cmd_t rcv;
        if (xQueueReceive(vsQueueHandle, &rcv, 5) == pdTRUE) {
            SYS_CONSOLE_PRINT("Received command %d from queque\r\n", rcv.cmd);
            switch(rcv.cmd) {
                case VS_MSG_NEXT:
                    VS1053_play_next();
                    break;
                case VS_MSG_PREV:
                    VS1053_play_prev();
                    break;
                case VS_MSG_STOP:
                    VS1053_fullStop();
                    break;
                case VS_MSG_PLAY_STREAM_BY_ID:
                    VS1053_fullStop();
                    VS1053_play_http_stream_by_id(rcv.param);
                    break;
                case VS_MSG_PLAY_FILE:;
                    char* file = (char*)rcv.param;
                    SYS_CONSOLE_PRINT("Playing file %s\r\n", file);
                    VS1053_fullStop();
                    VS1053_play_file(file);
                    break;
                case VS_MSG_PLAY_DIR:;
                    char* dir = (char*)rcv.param;
                    SYS_CONSOLE_PRINT("Playing direcotry %s\r\n", dir);
                    VS1053_fullStop();
                    VS1053_play_dir(dir);                
                    break;
                case VS_MSG_SET_VOL:
                    if ( (rcv.param >= 1) && (rcv.param <= 100) ) {
                        VS1053_setVolume(rcv.param);
                    }
                    break;
                case VS_MSG_LOOP:
                    if (rcv.param) { VS1053_setLoop(true); }
                    else { VS1053_setLoop(false); }
                    break;
                default:
                    break;
            }
        }    
    }
}

void VS1053_setVolume(uint8_t vol) {
  if ((vol < 1) || (vol > 100)) return;
  int x = log10f(vol)*1000;
  uint8_t new_reg_value = map(x, 0, 2000, 0xFE, 0x00);//vol;
  last_volume = vol;
  uint16_t value = new_reg_value;
  value <<= 8;
  value |= new_reg_value;

  VS1053_write_register(SCI_VOL,value); // VOL
  
  #ifdef USE_LCD_UI
  ui_update_volume();
  #endif
}

uint8_t VS1053_getVolume(void) {
    return last_volume;
}

/****************************************************************************/

void VS1053_playChunk(const uint8_t* data, size_t len) {
  VS1053_sdi_send_buffer(data,len);
}

void VS1053_play_next(void) {
    switch (StreamState) {
        case STREAM_FILE_FILL_BUFFER:
        case STREAM_FILE_GET_DATA:
            if (dir_count > 0) {
                VS1053_play_next_audio_file_from_directory();
            }
            break;
        case STREAM_HOME:
        case STREAM_HTTP_FILL_BUFFER:
        case STREAM_HTTP_GET_DATA:
            VS1053_stop();
            VS1053_play_next_http_stream_from_list();
            break;
        default:
            break;
    }
}

void VS1053_play_prev(void) {
    switch (StreamState) {
        case STREAM_FILE_FILL_BUFFER:
        case STREAM_FILE_GET_DATA:
            if (dir_count > 0) {
                //TODO: This need to be implemented
                VS1053_play_prev_audio_file_from_directory();
            }
            break;
        case STREAM_HOME:
        case STREAM_HTTP_FILL_BUFFER:
        case STREAM_HTTP_GET_DATA:
            VS1053_stop();
            VS1053_play_prev_http_stream_from_list();
            break;
        default:
            break;
    }
}
  
static void VS1053_startPlaying(void) {
    VS1053_sdi_send_zeroes(10);
}
  
static void VS1053_stopPlaying(void) {
    VS1053_sdi_send_zeroes(2048);
    ringbuffer_clear();
}

static void VS1053_handle_end_of_file (void) {
    int32_t res;
    
    if (dir_count > 0) {
        VS1053_play_next_audio_file_from_directory();   //it handles loops
    }
    else {
        if (loop_flag) {
            SYS_CONSOLE_PRINT("Loop flag set - rewinding\r\n");
            res = SYS_FS_FileSeek(fsrc, 0, SYS_FS_SEEK_SET);
            if (res == -1) SYS_DEBUG_PRINT(SYS_ERROR_ERROR, "f_lseek ERROR\r\n");
            StreamState = STREAM_FILE_FILL_BUFFER;
        }
        else {
            SYS_CONSOLE_PRINT("Loop flag cleared - closing file\r\n");
            if (fsrc != SYS_FS_HANDLE_INVALID) {
                SYS_FS_FileClose(fsrc);
                fsrc = SYS_FS_HANDLE_INVALID;
            }
            VS1053_stopPlaying();
            mediainfo_clean();
            #ifdef USE_LCD_UI
            ui_clear_content_info();
            ui_clear_state_info();
            #endif
            StreamState = STREAM_HOME;
        }
    }    
}
  
  
void VS1053_play_next_audio_file_from_directory (void) {
    if (dir_count == 0) { return; }
    dir_index++;
    if (dir_index > dir_count) {
        if (loop_flag) {
            dir_index = 1;
        }
        else {
            dir_count = 0;
            dir_index = 0;
            #ifdef USE_LCD_UI
            ui_update_dir_flag(0);
            #endif
        }
    }
    VS1053_stop();
    char *file_path = get_path_of_next_audio_file_in_currently_played_dir();
    if(file_path == NULL) { return; }
    VS1053_play_file(file_path);
}

void VS1053_play_prev_audio_file_from_directory(void) {
    if (dir_count == 0) { return; }
    dir_index--;
    if (dir_index == 0) {
        dir_index = dir_count;
    }
    VS1053_stop();
    char *file_path = get_path_of_next_audio_file_in_currently_played_dir();
    if(file_path == NULL) { return; }
    VS1053_play_file(file_path);
}

/*Always call VS1053_stop() before calling that function*/
void VS1053_play_http_stream(const char* url) {
    if ((StreamState == STREAM_HOME) || (StreamState == STREAM_HTTP_RECONNECT_WAIT)) {
        if (parse_url(url, strlen(url), &uri)) {
            StreamState = STREAM_HTTP_BEGIN;
            ReconnectStrategy = RECONNECT_WAIT_SHORT;
            ReconnectLimit = RECONNECT_LIMIT;
        }
        else {
            StreamState = STREAM_HOME;
            ReconnectStrategy = DO_NOT_RECONNECT;
        }
        mediainfo_type_set(MEDIA_TYPE_STREAM);
        VS1053_startPlaying();
    }
}

bool VS1053_play_http_stream_by_id(uint16_t id) {
    char name[32];
    char working_buffer[512];
    memset(name, 0x00, sizeof(name));
	char* url = get_station_url_from_file(id, working_buffer, sizeof(working_buffer), name, sizeof(name)-1);
	if (url) {
        mediainfo_title_set(name);
        #ifdef USE_LCD_UI
        ui_update_content_info(mediainfo_title_get());
        ui_update_dir_flag(dir_count);
        // TODO: Fix it
        // ui_set_selected_stream_id(id); 
        #endif
		VS1053_play_http_stream(url);
        current_stream_ind = id;
        return true;
	}
    return false;
}

void VS1053_play_next_http_stream_from_list(void) {
    char name[32];
    char working_buffer[512];
    
    memset(name, 0x00, sizeof(name));
    current_stream_ind++;
    char* url = get_station_url_from_file(current_stream_ind, working_buffer, sizeof(working_buffer), name, sizeof(name)-1);
    if (url == NULL) {
        //Function returned NULL, there is no stream with such ind
        //Try again from the beginning
        current_stream_ind = 1;
        url = get_station_url_from_file(current_stream_ind, working_buffer, sizeof(working_buffer), name, sizeof(name)-1);
        if (url == NULL) return;
    }
    VS1053_stop();
    mediainfo_title_set(name);
    #ifdef USE_LCD_UI
    ui_update_content_info(mediainfo_title_get());
    ui_update_dir_flag(dir_count);
    //TODO: Fix it
    //ui_set_selected_stream_id(current_stream_ind);
    #endif
    VS1053_play_http_stream(url);
}

void VS1053_play_prev_http_stream_from_list(void) {
    char name[32];
    char working_buffer[512];
    
    memset(name, 0x00, sizeof(name));
    current_stream_ind--;
    if (current_stream_ind < 1) { current_stream_ind = get_max_stream_id(); }
    char* url = get_station_url_from_file(current_stream_ind, working_buffer, sizeof(working_buffer), name, sizeof(name)-1);
    if (url == NULL) return;
    VS1053_stop();
    mediainfo_title_set(name);
    #ifdef USE_LCD_UI
    ui_update_content_info(mediainfo_title_get());
    ui_update_dir_flag(dir_count);
    // TODO: Fix it
    //ui_set_selected_stream_id(current_stream_ind);
    #endif
    VS1053_play_http_stream(url);
}

/*Always call VS1053_stop() before calling that function*/
void VS1053_play_file (char* url) {
    SYS_CONSOLE_PRINT("Playing file: %s\r\n", url);
    if (StreamState != STREAM_HOME) return;
    
    if (fsrc != SYS_FS_HANDLE_INVALID) {
        SYS_CONSOLE_PRINT("File already opened\r\n");
        return;
    }
    
    fsrc = SYS_FS_FileOpen(url, SYS_FS_FILE_OPEN_READ);
    if (fsrc == SYS_FS_HANDLE_INVALID) {
        SYS_DEBUG_PRINT(SYS_ERROR_ERROR, "SYS_FS_FileOpen error %d\r\n", SYS_FS_Error());
        StreamState = STREAM_HOME;
        return;
    }
    
    //Read ID3
    {
        char id3[128];
        if (SYS_FS_FileSeek(fsrc, -128, SYS_FS_SEEK_END) == -1) {
            SYS_DEBUG_PRINT(SYS_ERROR_ERROR, "ID3 SYS_FS_FileSeek (end-128) error\r\n");
            SYS_FS_FileClose(fsrc);
            fsrc = SYS_FS_HANDLE_INVALID;
            return;
        }
        if (SYS_FS_FileRead(fsrc, id3, 128) == -1) {
            SYS_DEBUG_PRINT(SYS_ERROR_ERROR, "ID3 SYS_FS_FileRead error\r\n");
            SYS_FS_FileClose(fsrc);
            fsrc = SYS_FS_HANDLE_INVALID;
            return;
        }
        //Move to beginning
        if (SYS_FS_FileSeek(fsrc, 0, SYS_FS_SEEK_SET) == -1) {
            SYS_DEBUG_PRINT(SYS_ERROR_ERROR, "ID3 SYS_FS_FileSeek (begin) error\r\n");
            SYS_FS_FileClose(fsrc);
            fsrc = SYS_FS_HANDLE_INVALID;
            return;
        }
        if (strncmp(id3, "TAG", 3)) {
            SYS_CONSOLE_PRINT("File doesn't have an ID3 tag\r\n");
            const char* filename = strrchr(url, '/');
            if (filename) {
                filename++;
                SYS_CONSOLE_PRINT("Name of opened file: %s\r\n", filename);
                mediainfo_title_set(filename);
            }
            else {
                mediainfo_title_set("No ID3");
            }
        }
        else {
            unsigned char *s = (unsigned char*)id3+3;
            
            /* Id3 tag elements don't necessarily end in a '\0' if they
            occupy the full 30 character space. Thus, we'll have to
            nul-terminate all strings just to be sure. */
            mediainfo_title_set((const char*)s);
            s += 30;
            mediainfo_artist_set((const char*)s);
            s += 30;
            mediainfo_album_set((const char*)s);
            s += 30;
            mediainfo_year_set((const char*)s);
            s += 4;
            mediainfo_comment_set((const char*)s);
            s += 30;

            /* The genre field is not encoded as a string, but just one byte
            that indexes the decoding table. If memory is too expensive,
            the whole field may be ignored or just shown as a number. */
            mediainfo_genre_set(*s);

            /* And now the final printing */
            SYS_CONSOLE_PRINT("Title  : %-30s  Artist: %s\r\n", mediainfo_title_get(), mediainfo_artist_get());
            SYS_CONSOLE_PRINT("Album  : %-30s  Year  : %4s\r\n", mediainfo_album_get(), mediainfo_year_get());
            SYS_CONSOLE_PRINT("Comment: %-30s  Genre : %s\r\n", mediainfo_comment_get(), mediainfo_genre_get());
        }
    }
    
    #ifdef USE_LCD_UI
    ui_update_content_info(mediainfo_title_get());
    ui_update_dir_flag(dir_count);
    #endif
    mediainfo_type_set(MEDIA_TYPE_FILE);
    StreamState = STREAM_FILE_FILL_BUFFER;
    consecutiveReadErrors = 0;
    VS1053_startPlaying();         //Start playing song
}


void VS1053_play_dir (const char* path) {
    dir_count = count_audio_files_in_dir(path);
    if (dir_count == 0) { return; }
    dir_index = 1;
    strncpy(uri.server, path, sizeof(uri.server)-1);		//we use uri.server to store current directory path
    int ret = snprintf(uri.server, sizeof(uri.server), "%s", path);   //we use uri.server to store current directory path
    if (ret <0 || ret >= sizeof(uri.server)) {
//        SYS_DEBUG_PRINT(SYS_ERROR_ERROR, "Play dir: uri.server does not fit directory path\r\n");
        return;
    }
    char* file_path = get_path_of_next_audio_file_in_currently_played_dir();
    if (file_path == NULL) { return; }
    VS1053_play_file(file_path);
}

static uint16_t count_audio_files_in_dir(const char* path) {
    SYS_FS_HANDLE dirHandle;
    SYS_FS_FSTAT dirEntry;
    uint16_t count = 0;
    
    dirEntry.lfname = NULL;
    dirEntry.lfsize = 0;

    dirHandle = SYS_FS_DirOpen(path);
    if (dirHandle == SYS_FS_HANDLE_INVALID) {
        SYS_FS_ERROR err = SYS_FS_Error();
        SYS_CONSOLE_PRINT("count_audio_files_in_dir error opening directory: %s, error code: %d\n", uri.server, err);
        return 0;
    }

    while (SYS_FS_DirRead(dirHandle, &dirEntry) == SYS_FS_RES_SUCCESS) {
        if (!dirEntry.fname[0]) { // empty string, end of directory
            break;
        }
        // Check for directory
        if (dirEntry.fattrib & SYS_FS_ATTR_DIR) {
            continue;
        }
        // Check if it's an audio file
        if (is_audio_file(dirEntry.fname)) {
            count++;
        }
    }

    SYS_FS_DirClose(dirHandle);
    return count;    
}

static char* get_path_of_next_audio_file_in_currently_played_dir(void) {
    SYS_FS_HANDLE dirHandle;
    SYS_FS_FSTAT dirEntry;
    uint16_t count = 0;
    
    dirEntry.lfname = NULL;
    dirEntry.lfsize = 0;

    dirHandle = SYS_FS_DirOpen(uri.server);     // We use uri.server to store path for currently played dir
    if (dirHandle == SYS_FS_HANDLE_INVALID) {
        SYS_FS_ERROR err = SYS_FS_Error();
        SYS_CONSOLE_PRINT("get_path_of_next_audio_file_in_currently_played_dir error opening directory: %s, error code: %d\n", uri.server, err);
        return NULL;
    }

    while (SYS_FS_DirRead(dirHandle, &dirEntry) == SYS_FS_RES_SUCCESS) {
        if (!dirEntry.fname[0]) { // empty string, end of directory
            break;
        }
        // Check for directory
        if (dirEntry.fattrib & SYS_FS_ATTR_DIR) {
            continue;
        }
        // Check if it's an audio file
        if (is_audio_file(dirEntry.fname)) {
            count++;
        }
        if (count == dir_index) {
            char* file_name = dirEntry.altname[0] ? dirEntry.altname : dirEntry.fname;
            if (strlen(uri.server) + 1 + strlen(file_name) >= sizeof(uri.file)) {
                break;
            }
            strlcpy(uri.file, uri.server, sizeof(uri.file));
            strlcat(uri.file, "/", sizeof(uri.file));
            strlcat(uri.file, file_name, sizeof(uri.file));
            SYS_FS_DirClose(dirHandle);
            return uri.file;
        }
    }

    SYS_FS_DirClose(dirHandle);
    return NULL;     
}

void VS1053_stop(void) {
    //Can be stopped only if it is actually playing
    switch (StreamState) {
        case STREAM_HTTP_BEGIN:
        case STREAM_HTTP_SOCKET_OBTAINED:
        case STREAM_HTTP_SEND_REQUEST:
        case STREAM_HTTP_PROCESS_HEADER:
        case STREAM_HTTP_FILL_BUFFER:
        case STREAM_HTTP_GET_DATA:
            if (StreamState == STREAM_HTTP_PROCESS_HEADER) { http_release_parser(); }
            if (uri.server[0] != '\0') {
                TCPIP_DNS_RemoveEntry(uri.server);
            }
            if(VS_Socket != INVALID_SOCKET) {
                if (!TCPIP_TCP_Close(VS_Socket)) {
                    TCPIP_TCP_Abort(VS_Socket, true);
                }
                VS_Socket = INVALID_SOCKET;       
            }
            break;
        case STREAM_FILE_FILL_BUFFER:    
        case STREAM_FILE_GET_DATA:
        case STREAM_FILE_PLAY_REST:
            if (fsrc != SYS_FS_HANDLE_INVALID) {
                SYS_FS_FileClose(fsrc);
                fsrc = SYS_FS_HANDLE_INVALID;
            }
            break;
        default:
            return;
            break;
    }
    VS1053_stopPlaying();
    mediainfo_clean();
    #ifdef USE_LCD_UI
    ui_clear_content_info();
    ui_clear_state_info();
    ui_update_dir_flag(dir_count);
    #endif
    StreamState = STREAM_HOME;
}

void VS1053_fullStop(void) {
    dir_count = 0;
    dir_index = 0;
    VS1053_stop();
}

void VS1053_startRecordingPCM(void) {
    VS1053_soft_reset();
    while (!VS_DREQ_PIN) {}
    VS1053_write_register(SCI_AICTRL0, 48000); // Sample rate
    VS1053_write_register(SCI_AICTRL1, 0); // Recording gain : 1024 : 1.If 0, use AGC
    VS1053_write_register(SCI_AICTRL2, 4096); // Maximum AGC level: 1024 = 1. Only used if SCI_AICTRL1 is set to 0.
    VS1053_write_register(SCI_AICTRL3, 4); //joint stereo AGC + LINEAR PCM
    while (!VS_DREQ_PIN) {}
    VS1053_write_register(SCI_MODE, (1 << SM_RESET) | (1 << SM_ADPCM) | (1 << SM_LINE_IN) | (1 << SM_SDINEW));
    while (!VS_DREQ_PIN) {}
}

void VS1053_stopRecordingPCM(void) {
    VS1053_write_register(SCI_AICTRL3, 1);
}

void VS1053_setLoop(bool val) {
    loop_flag = val;
  #ifdef USE_LCD_UI
  ui_update_loop_flag(val);
  #endif
}

void VS1053_toggleLoop(void) {
  loop_flag = !loop_flag;
  #ifdef USE_LCD_UI
  ui_update_loop_flag(loop_flag);
  #endif    
}

bool VS1053_getLoop(void) {
    return loop_flag;
}

bool VS1053_getDirFlag() {
    return (dir_count > 0);
}

StreamState_t VS1053_getStreamState(void) {
    return StreamState;
}

void VS1053_send_cmd_thread_safe(uint8_t cmd, uint32_t param) {
	vs1053cmd_t command;
	command.cmd = cmd;
	command.param = param;
	if (xQueueSend(vsQueueHandle, (void*)&command, portMAX_DELAY)) {
		SYS_CONSOLE_PRINT("Sending thread safe command to VS1053: %d\r\n", command.cmd);
	}
}

const char* VS1053_get_state_description(void) {
    switch(StreamState) {
//        case STREAM_HTTP_NAME_RESOLVE:
//        case STREAM_HTTP_OBTAIN_SOCKET:            
//        case STREAM_HTTP_SOCKET_OBTAINED:
//        case STREAM_HTTP_SEND_REQUEST:
//        case STREAM_HTTP_PROCESS_HEADER:
        case STREAM_HTTP_FILL_BUFFER:
        case STREAM_HTTP_GET_DATA:
            return "Playing stream";
        case STREAM_FILE_FILL_BUFFER:
        case STREAM_FILE_PLAY_REST:
        case STREAM_FILE_GET_DATA:
            return "Playing file";
        default:
            return NULL;
//        case STREAM_HTTP_CLOSE:
//        case STREAM_HTTP_RECONNECT_WAIT:     
    }
    return NULL;
}


static void get_uri_from_stream_id(uint16_t id, uri_t* uri) {
    char working_buffer[512];
    char* url = get_station_url_from_file(id, working_buffer, sizeof(working_buffer), NULL, 0);
    parse_url(url, strlen(url), uri);
}

/*
 * VS1053_startLineInPassthrough()
 *
 * Stops any current playback and configures the VS1053b for line-in
 * monitoring: ADC records from LINE1 and the signal is routed back to
 * the DAC output via the hardware DAC_VOL register (§10.8.7).
 *
 * There is NO hardware analog bypass on VS1053b.  The only supported
 * monitoring path is: LINE1 ? ADC ? DSP (ADPCM/PCM record mode) ? DAC.
 * The DSP must therefore be kept in PCM recording mode while monitoring.
 *
 * Call VS1053_stopLineInPassthrough() to return to normal decode mode.
 */
void VS1053_startLineInPassthrough(void) {
    VS1053_fullStop();

    /* Soft reset ? known state.  Does NOT reset SCI_VOL (§9.6.11). */
    VS1053_soft_reset();
    while (!VS_DREQ_PIN) {}

    /* Sample rate for the ADC (must be set BEFORE activating ADPCM mode,
       as it is only read at recording startup ? §10.8.1). */
    VS1053_write_register(SCI_AICTRL0, 44100);

    /* Recording gain: 0 = automatic gain control (AGC).
       Use 1024 for unity gain (1×) if you prefer fixed gain. */
    VS1053_write_register(SCI_AICTRL1, 1024);

    /* Maximum AGC amplification: 1024 = 1×.  Only relevant when
       SCI_AICTRL1 == 0 (AGC mode). */
    VS1053_write_register(SCI_AICTRL2, 1024);

    /* AICTRL3 bits [1:0]: 00 = joint stereo (common AGC)
       AICTRL3 bit  [2]:    1 = LINEAR PCM (not IMA ADPCM)
       All other bits must be 0 (§10.8.1). */
    VS1053_write_register(SCI_AICTRL3, (1 << 2)); /* = 0x0004 */
    while (!VS_DREQ_PIN) {}

    /* Activate PCM recording mode via SM_RESET | SM_ADPCM | SM_LINE1.
     *   SM_RESET  (bit 2)  ? required to latch the AICTRL0/3 values
     *   SM_ADPCM  (bit 12) ? activates the ADC/DAC record path
     *   SM_LINE_IN (bit 14) ? selects LINE_IN input instead of mic (§9.6.1)
     *   SM_SDINEW (bit 11) ? keep SPI in VS10xx native mode
     */
    VS1053_write_register(SCI_MODE,
        (1 << SM_RESET)  |
        (1 << SM_ADPCM)  |
        (1 << SM_LINE_IN)  |
        (1 << SM_SDINEW)
    );
    while (!VS_DREQ_PIN) {}

    /*
     * Apply the mandatory VS1053b ADPCM encoder patch (§10.8.1).
     * Without this patch, recording (and therefore monitoring) is broken
     * on VS1053b/VS8053b.  This is the same patch your existing
     * VS1053_startRecordingPCM() should also be calling.
     */
    VS1053B_apply_patch();
    while (!VS_DREQ_PIN) {}

    /*
     * Enable record monitoring via the hardware DAC_VOL register (§10.8.7).
     * SCI_VOL writes are IGNORED while in ADPCM recording mode.
     * DAC_VOL at address 0xC045: high byte = left ch, low byte = right ch.
     * 0x0000 = 0 dB (full volume), see §10.8.7 table for attenuation steps.
     */
    VS1053_write_register(SCI_WRAMADDR, 0xC045); /* DAC_VOL */
    VS1053_write_register(SCI_WRAM,     0x0000); /* 0 dB both channels */

    StreamState = STREAM_HOME;

    #ifdef USE_LCD_UI
    ui_update_state_info("Line-in monitor");
    #endif

    SYS_CONSOLE_PRINT("VS1053: line-in passthrough active (PCM monitor mode)\r\n");
}

/*
 * VS1053_stopLineInPassthrough()
 *
 * Mutes DAC_VOL first to suppress any pop, then soft-resets the chip to
 * return it to normal decode mode.  Re-applies the patch so plugin-
 * dependent features are available again.
 */
void VS1053_stopLineInPassthrough(void) {
    /* Mute via DAC_VOL before reset to avoid a loud pop (§10.8.7).
       0xFEFE is not a valid DAC_VOL value; use 0x0E0E (-84 dB) instead,
       or just pull volume to a safe low before the reset. */
    VS1053_write_register(SCI_WRAMADDR, 0xC045);
    VS1053_write_register(SCI_WRAM,     0x0E0E); /* ? -84 dB */

    VS1053_soft_reset();
    while (!VS_DREQ_PIN) {}

    /* Re-apply patch so normal decode features work again. */
    VS1053B_apply_patch();
    while (!VS_DREQ_PIN) {}

    StreamState = STREAM_HOME;

    #ifdef USE_LCD_UI
    ui_clear_state_info();
    #endif

    SYS_CONSOLE_PRINT("VS1053: line-in passthrough stopped\r\n");
}


//#define BASE 0x1800
//
//void VS1053_read_spectrum_analyzer(void) {
//    //SYS_CONSOLE_PRINT("Reading spectrum analyzer data: ");
//    VS1053_write_register(SCI_WRAMADDR, BASE+2);
//    int bands = VS1053_read_register(SCI_WRAM);
//    SYS_CONSOLE_PRINT("Bands: %d\r\n", bands);
//    VS1053_write_register(SCI_WRAMADDR, BASE+4);
//    for (int i=0; i<bands; i++) {
//        VS1053_read_register(SCI_WRAM);
//        //SYS_CONSOLE_PRINT("%d, ", val);
//    }
//    //SYS_CONSOLE_PRINT("\r\n");
//}
//
//
//void VS1053_set_bands(void) {
//    int bands = 14;
//    int i;
//    
//    static const short frequency[] = {50, 79, 126, 200, 317, 504, 800, 1270, 2016, 3200, 5080, 8063, 12800, 20319};
//    /* send new frequencies */
//    VS1053_write_register(SCI_WRAMADDR, BASE+0x68);
//    VS1053_write_register(SCI_WRAMADDR, BASE+0x68);
//    for (i=0;i<bands;i++) {
//        VS1053_write_register(SCI_WRAM, frequency[i]);
//    }
//    if (i < 23) {
//        VS1053_write_register(SCI_WRAM, 25000);
//    }
//    /* activate */
//    VS1053_write_register(SCI_WRAMADDR, BASE+1);
//    VS1053_write_register(SCI_WRAM, 0);
//}
