marekw1986/InternetRadioPIC32DP83848/firmware/src/config/default/driver/spi/src/drv_spi.c

/*******************************************************************************
  SPI Driver Implementation.

  Company:
    Microchip Technology Inc.

  File Name:
    drv_spi.c

  Summary:
    Source code for the SPI driver implementation.

  Description:
    This file contains the source code for the implementation of the SPI driver.
*******************************************************************************/

//DOM-IGNORE-BEGIN
/*******************************************************************************
* Copyright (C) 2018 Microchip Technology Inc. and its subsidiaries.
*
* Subject to your compliance with these terms, you may use Microchip software
* and any derivatives exclusively with Microchip products. It is your
* responsibility to comply with third party license terms applicable to your
* use of third party software (including open source software) that may
* accompany Microchip software.
*
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
* IN NO EVENT WILL MICROCHIP BE LIABLE FOR ANY INDIRECT, SPECIAL, PUNITIVE,
* INCIDENTAL OR CONSEQUENTIAL LOSS, DAMAGE, COST OR EXPENSE OF ANY KIND
* WHATSOEVER RELATED TO THE SOFTWARE, HOWEVER CAUSED, EVEN IF MICROCHIP HAS
* BEEN ADVISED OF THE POSSIBILITY OR THE DAMAGES ARE FORESEEABLE. TO THE
* FULLEST EXTENT ALLOWED BY LAW, MICROCHIP'S TOTAL LIABILITY ON ALL CLAIMS IN
* ANY WAY RELATED TO THIS SOFTWARE WILL NOT EXCEED THE AMOUNT OF FEES, IF ANY,
* THAT YOU HAVE PAID DIRECTLY TO MICROCHIP FOR THIS SOFTWARE.
*******************************************************************************/
//DOM-IGNORE-END

// *****************************************************************************
// *****************************************************************************
// Section: Included Files
// *****************************************************************************
// *****************************************************************************

#include <string.h>
#include "configuration.h"
#include "driver/spi/drv_spi.h"
#include "system/debug/sys_debug.h"

// *****************************************************************************
// *****************************************************************************
// Section: Global Data
// *****************************************************************************
// *****************************************************************************

/* This is the driver instance object array. */
static CACHE_ALIGN DRV_SPI_OBJ gDrvSPIObj[DRV_SPI_INSTANCES_NUMBER];

// *****************************************************************************
// *****************************************************************************
// Section: File scope functions
// *****************************************************************************
// *****************************************************************************


static inline uint32_t  _DRV_SPI_MAKE_HANDLE(uint16_t token, uint8_t drvIndex, uint8_t index)
{
    return ((token << 16) | (drvIndex << 8) | index);
}

static inline uint16_t _DRV_SPI_UPDATE_TOKEN(uint16_t token)
{
    token++;

    if (token >= DRV_SPI_TOKEN_MAX)
    {
        token = 1;
    }

    return token;
}

static void _DRV_SPI_DisableInterrupts(DRV_SPI_OBJ* dObj)
{
    bool interruptStatus;
    const DRV_SPI_INTERRUPT_SOURCES* intInfo = dObj->interruptSources;
    const DRV_SPI_MULTI_INT_SRC* multiVector = &intInfo->intSources.multi;
    if (intInfo->isSingleIntSrc == true)
    {
        /* Disable SPI interrupt */
        dObj->spiInterruptStatus = SYS_INT_SourceDisable((INT_SOURCE)intInfo->intSources.spiInterrupt);
    }
    else
    {
        /* Disable SPI interrupt sources */

        interruptStatus = SYS_INT_Disable();
        if(multiVector->spiTxReadyInt != -1)
        {
            dObj->spiTxReadyIntStatus = SYS_INT_SourceDisable((INT_SOURCE)multiVector->spiTxReadyInt);
        }
        if(multiVector->spiTxCompleteInt != -1)
        {
            dObj->spiTxCompleteIntStatus = SYS_INT_SourceDisable((INT_SOURCE)multiVector->spiTxCompleteInt);
        }
        if(multiVector->spiRxInt != -1)
        {
            dObj->spiRxIntStatus = SYS_INT_SourceDisable((INT_SOURCE)multiVector->spiRxInt);
        }
        SYS_INT_Restore(interruptStatus);
    }
}

static void _DRV_SPI_EnableInterrupts(DRV_SPI_OBJ* dObj)
{
    bool interruptStatus;
    const DRV_SPI_INTERRUPT_SOURCES* intInfo = dObj->interruptSources;
    const DRV_SPI_MULTI_INT_SRC* multiVector = &intInfo->intSources.multi;
    if (intInfo->isSingleIntSrc == true)
    {
        /* Enable SPI interrupt */
        SYS_INT_SourceRestore((INT_SOURCE)intInfo->intSources.spiInterrupt, dObj->spiInterruptStatus);
    }
    else
    {
        /* Enable SPI interrupt sources */
        interruptStatus = SYS_INT_Disable();
        if(multiVector->spiTxReadyInt != -1)
        {
            SYS_INT_SourceRestore((INT_SOURCE)multiVector->spiTxReadyInt, dObj->spiTxReadyIntStatus);
        }
        if(multiVector->spiTxCompleteInt != -1)
        {
            SYS_INT_SourceRestore((INT_SOURCE)multiVector->spiTxCompleteInt,dObj->spiTxCompleteIntStatus);
        }
        if(multiVector->spiRxInt != -1)
        {
            SYS_INT_SourceRestore((INT_SOURCE)multiVector->spiRxInt, dObj->spiRxIntStatus);
        }
        SYS_INT_Restore(interruptStatus);
    }
}

static bool _DRV_SPI_ResourceLock(DRV_SPI_OBJ * dObj)
{
    /* We will allow buffers to be added in the interrupt context of the SPI
     * driver. But we must make sure that if we are inside interrupt, then we
     * should not modify mutexes. */
    if(dObj->interruptNestingCount == 0)
    {
        /* Grab a mutex. This is okay because we are not in an interrupt context */
        if(OSAL_MUTEX_Lock(&(dObj->mutexTransferObjects), OSAL_WAIT_FOREVER) == OSAL_RESULT_FALSE)
        {
            return false;
        }
        /* We will disable interrupts so that the queue status does not get updated asynchronously */
        _DRV_SPI_DisableInterrupts(dObj);
    }

    return true;
}

static void _DRV_SPI_ResourceUnlock(DRV_SPI_OBJ * dObj)
{
    if(dObj->interruptNestingCount == 0)
    {
        _DRV_SPI_EnableInterrupts(dObj);

        /* Release mutex */
        OSAL_MUTEX_Unlock(&(dObj->mutexTransferObjects));
    }
}

static DRV_SPI_CLIENT_OBJ * _DRV_SPI_DriverHandleValidate(DRV_HANDLE handle)
{
    /* This function returns the pointer to the client object that is
       associated with this handle if the handle is valid. Returns NULL
       otherwise. */

    uint32_t drvInstance = 0;
    DRV_SPI_CLIENT_OBJ* clientObj = (DRV_SPI_CLIENT_OBJ*)NULL;

    if((handle != DRV_HANDLE_INVALID) && (handle != 0))
    {
        /* Extract the drvInstance value from the handle */
        drvInstance = ((handle & DRV_SPI_INSTANCE_MASK) >> 8);

        if (drvInstance >= DRV_SPI_INSTANCES_NUMBER)
        {
            return (NULL);
        }

        if ((handle & DRV_SPI_INDEX_MASK) >= gDrvSPIObj[drvInstance].nClientsMax)
        {
            return (NULL);
        }

        /* Extract the client index and obtain the client object */
        clientObj = &((DRV_SPI_CLIENT_OBJ *)gDrvSPIObj[drvInstance].clientObjPool)[handle & DRV_SPI_INDEX_MASK];

        if ((clientObj->clientHandle != handle) || (clientObj->inUse == false))
        {
            return (NULL);
        }
    }

    return(clientObj);
}

static DRV_SPI_TRANSFER_OBJ* _DRV_SPI_FreeTransferObjGet(DRV_SPI_CLIENT_OBJ* clientObj)
{
	uint32_t i;
	uint32_t index;
    DRV_SPI_OBJ* dObj = (DRV_SPI_OBJ* )&gDrvSPIObj[clientObj->drvIndex];
    DRV_SPI_TRANSFER_OBJ* pTransferObj = (DRV_SPI_TRANSFER_OBJ*)dObj->transferObjPool;

    for (i = 0, index = dObj->transferObjLastUsedIndex; i < dObj->transferObjPoolSize; i++, index++)
    {
		if (index >= dObj->transferObjPoolSize)
		{
			index = 0;
		}
        if (pTransferObj[index].inUse == false)
        {
            pTransferObj[index].inUse = true;
            pTransferObj[index].next = NULL;

            /* Generate a unique buffer handle consisting of an incrementing
             * token counter, driver index and the buffer index.
             */
            pTransferObj[index].transferHandle = (DRV_SPI_TRANSFER_HANDLE)_DRV_SPI_MAKE_HANDLE(
                dObj->spiTokenCount, (uint8_t)clientObj->drvIndex, index);

            /* Update the token for next time */
            dObj->spiTokenCount = _DRV_SPI_UPDATE_TOKEN(dObj->spiTokenCount);
			
			dObj->transferObjLastUsedIndex = index + 1;

            return &pTransferObj[index];
        }
    }
    return NULL;
}

static bool _DRV_SPI_TransferObjAddToList(
    DRV_SPI_OBJ* dObj,
    DRV_SPI_TRANSFER_OBJ* transferObj
)
{
    DRV_SPI_TRANSFER_OBJ** pTransferObjList;
    bool isFirstTransferInList = false;

    pTransferObjList = (DRV_SPI_TRANSFER_OBJ**)&(dObj->transferObjList);

    // Is the buffer object list empty?
    if (*pTransferObjList == NULL)
    {
        *pTransferObjList = transferObj;
        isFirstTransferInList = true;
    }
    else
    {
        // List is not empty. Iterate to the end of the buffer object list.
        while (*pTransferObjList != NULL)
        {
            if ((*pTransferObjList)->next == NULL)
            {
                // End of the list reached, add the buffer here.
                (*pTransferObjList)->next = transferObj;
                break;
            }
            else
            {
                pTransferObjList = (DRV_SPI_TRANSFER_OBJ**)&((*pTransferObjList)->next);
            }
        }
    }

    return isFirstTransferInList;
}

static DRV_SPI_TRANSFER_OBJ* _DRV_SPI_TransferObjListGet( DRV_SPI_OBJ* dObj )
{
    DRV_SPI_TRANSFER_OBJ* pTransferObj = NULL;

    // Return the element at the head of the linked list
    pTransferObj = (DRV_SPI_TRANSFER_OBJ*)dObj->transferObjList;

    return pTransferObj;
}

static void _DRV_SPI_RemoveTransferObjFromList( DRV_SPI_OBJ* dObj )
{
    DRV_SPI_TRANSFER_OBJ** pTransferObjList;

    pTransferObjList = (DRV_SPI_TRANSFER_OBJ**)&(dObj->transferObjList);

    // Remove the element at the head of the linked list
    if (*pTransferObjList != NULL)
    {
        /* Save the buffer object to be removed. Set the next buffer object as
         * the new head of the linked list. Reset the removed buffer object. */

        DRV_SPI_TRANSFER_OBJ* temp = *pTransferObjList;
        *pTransferObjList = (*pTransferObjList)->next;
        temp->currentState = DRV_SPI_TRANSFER_OBJ_IS_FREE;
        temp->next = NULL;
        temp->inUse = false;
    }
}

static void _DRV_SPI_RemoveClientTransfersFromList(
    DRV_SPI_OBJ* dObj,
    DRV_SPI_CLIENT_OBJ* clientObj
)
{
    DRV_SPI_TRANSFER_OBJ** pTransferObjList;
    DRV_SPI_TRANSFER_OBJ* delTransferObj = NULL;

    pTransferObjList = (DRV_SPI_TRANSFER_OBJ**)&(dObj->transferObjList);

    while (*pTransferObjList != NULL)
    {
        // Do not remove the buffer object that is already in process
        if (((*pTransferObjList)->clientHandle == clientObj->clientHandle) &&
                ((*pTransferObjList)->currentState == DRV_SPI_TRANSFER_OBJ_IS_IN_QUEUE))
        {
            // Save the node to be deleted off the list
            delTransferObj = *pTransferObjList;

            // Update the current node to point to the deleted node's next
            *pTransferObjList = (DRV_SPI_TRANSFER_OBJ*)(*pTransferObjList)->next;

            // Reset the deleted node
            delTransferObj->currentState = DRV_SPI_TRANSFER_OBJ_IS_FREE;
            delTransferObj->event = DRV_SPI_TRANSFER_EVENT_COMPLETE;
            delTransferObj->next = NULL;
            delTransferObj->inUse = false;
        }
        else
        {
            // Move to the next node
            pTransferObjList = (DRV_SPI_TRANSFER_OBJ**)&((*pTransferObjList)->next);
        }
    }
}


static void _DRV_SPI_UpdateTransferSetupAndAssertCS(
    DRV_SPI_TRANSFER_OBJ* transferObj
)
{
    DRV_SPI_OBJ* dObj;
    DRV_SPI_CLIENT_OBJ* clientObj;

    /* Get the client object that owns this buffer */
    clientObj = &((DRV_SPI_CLIENT_OBJ *)gDrvSPIObj[((transferObj->clientHandle & DRV_SPI_INSTANCE_MASK) >> 8)].clientObjPool)
    [transferObj->clientHandle & DRV_SPI_INDEX_MASK];

    dObj = (DRV_SPI_OBJ*)&gDrvSPIObj[clientObj->drvIndex];

    /* Update the PLIB Setup if current request is from a different client or
     * setup has been changed dynamically for the client */
    if((transferObj->clientHandle != dObj->lastClientHandle) || (clientObj->setupChanged == true))
    {
        dObj->spiPlib->setup(&clientObj->setup, _USE_FREQ_CONFIGURED_IN_CLOCK_MANAGER);
        dObj->lastClientHandle = transferObj->clientHandle;
        clientObj->setupChanged = false;
    }

    /* Assert chip select if configured */
    if(clientObj->setup.chipSelect != SYS_PORT_PIN_NONE)
    {
        if (clientObj->setup.csPolarity == DRV_SPI_CS_POLARITY_ACTIVE_LOW)
        {
            SYS_PORT_PinClear(clientObj->setup.chipSelect);
        }
        else
        {
            SYS_PORT_PinSet(clientObj->setup.chipSelect);
        }
    }
}

static void _DRV_SPI_PlibCallbackHandler(uintptr_t contextHandle)
{
    DRV_SPI_OBJ* dObj                    = (DRV_SPI_OBJ*)contextHandle;
    DRV_SPI_CLIENT_OBJ* clientObj        = (DRV_SPI_CLIENT_OBJ*)NULL;
    DRV_SPI_TRANSFER_OBJ* transferObj    = (DRV_SPI_TRANSFER_OBJ*)NULL;
    DRV_SPI_TRANSFER_EVENT event;
    DRV_SPI_TRANSFER_HANDLE transferHandle;

    if((dObj->inUse == false) || (dObj->status != SYS_STATUS_READY))
    {
        /* This instance of the driver is not initialized. Don't
         * do anything */
        return;
    }

    /* Get the transfer object at the head of the list */
    transferObj = _DRV_SPI_TransferObjListGet(dObj);

    /* Get the client object that owns this buffer */
    clientObj = &((DRV_SPI_CLIENT_OBJ *)gDrvSPIObj[((transferObj->clientHandle & DRV_SPI_INSTANCE_MASK) >> 8)].clientObjPool)
    [transferObj->clientHandle & DRV_SPI_INDEX_MASK];

    /* De-assert Chip Select if it is defined by user */
    if(clientObj->setup.chipSelect != SYS_PORT_PIN_NONE)
    {
        if (clientObj->setup.csPolarity == DRV_SPI_CS_POLARITY_ACTIVE_LOW)
        {
            SYS_PORT_PinSet(clientObj->setup.chipSelect);
        }
        else
        {
            SYS_PORT_PinClear(clientObj->setup.chipSelect);
        }
    }

    /* Check if the client that submitted the request is active? */
    if (clientObj->clientHandle == transferObj->clientHandle)
    {
        transferObj->event = DRV_SPI_TRANSFER_EVENT_COMPLETE;

        /* Save the transfer handle and event locally before freeing the transfer object*/
        event = transferObj->event;
        transferHandle = transferObj->transferHandle;

        /* Free the completed buffer.
         * This is done before giving callback to allow application to use the freed
         * buffer and queue in a new request from within the callback */

        _DRV_SPI_RemoveTransferObjFromList(dObj);

        if(clientObj->eventHandler != NULL)
        {
            /* Call the event handler. We additionally increment the
            interrupt nesting count which lets the driver functions
            that are called from the event handler know that an
            interrupt context is active. */
            dObj->interruptNestingCount++;

            clientObj->eventHandler(event, transferHandle, clientObj->context);

            /* Event handler has completed, so decrement the nesting count now */
            dObj->interruptNestingCount--;
        }
    }
    else
    {
        /* Free the completed buffer */
        _DRV_SPI_RemoveTransferObjFromList(dObj);
    }

     /* Get the transfer object at the head of the list */
    transferObj = _DRV_SPI_TransferObjListGet(dObj);

    /* Process the next transfer buffer */
    if((transferObj != NULL) && (transferObj->currentState == DRV_SPI_TRANSFER_OBJ_IS_IN_QUEUE))
    {
        _DRV_SPI_UpdateTransferSetupAndAssertCS(transferObj);

        transferObj->currentState = DRV_SPI_TRANSFER_OBJ_IS_PROCESSING;

        dObj->spiPlib->writeRead(
            transferObj->pTransmitData,
            transferObj->txSize,
            transferObj->pReceiveData,
            transferObj->rxSize
        );
    }
}
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
