marekw1986/InternetRadioPIC32DP83848/(commit log)

2021-02-01 I2C test
2021-10-06 io2 (display only) added
    [io2.brd, io2.sch]
2021-10-24 Rotary encoder debounce
    [io2.brd, io2.sch]
2021-10-26 some changes
    [io2.brd]
2021-11-05 Backlight fixed
    [io2.brd, io2.sch, module.sch]
2021-11-13 rotary encoder fixed
    [io2.brd, io2.sch]
2021-11-20 rotry encoder modified
2022-09-03 Fixes in VS1003 code, general cleanup
    [vs1003.c]
2022-10-06 SPI flash mounted
2022-10-08 USB playback issue fixed
    [main.c, vs1003.c]
2022-10-11 MISO pull-up added
    [module.brd, module.sch]
2022-10-15 Loading data to buffer during file playback doesn't block main loop
    [vs1003.c]
2022-10-15 Experiments with memory friendly SPI Flash IO
2022-10-19 Problem with choppy playback at higher bitrates fixed
    [vs1003.c]
2023-04-05 moving project to Harmony library
    [configuration.h]
2023-04-11 Rotary encoder added
2023-04-16 updates and fixes
    [configuration.h]
2023-04-17 URL validity checking and WebUI updates
    [configuration.h]
2023-04-29 LCD I2C speed increades to 100 kHz
2023-12-25 Small fixes, heap seize reduced
    [configuration.h]
2023-12-26 UI update - showing status on LCD. Minor fixes.
    [hd44780.c, hd44780.h, ui.c, vs1003.c]
2023-12-28 Direcotry code renamed to firmware for compatibility with Microchip MHC
    [configuration.h]
2024-01-02 UI scrolling bug fixed
    [hd44780.c, hd44780.h, ui.c]
2024-01-02 Counting number of streams on list at start time, minor fixes
    [app.c, common.c, common.h, vs1003.c]
2024-01-05 Playing currently selected stream from UI list, button library updated
2024-01-06 Accepting stream by pressing rotary encoder
2024-01-17 IO board without I2C added
    [io3.brd, io3.sch]
2024-01-18 io3 board fix - no need to twist lines in ribbon
    [io3.brd, io3.sch]
2024-01-18 HD44780 directly at IO pins, I2C removed
2024-01-19 Initial IO configuration changed to connect HD44780 directly (without I2C)
2024-01-23 HD44780 moved from I2C to GPIO bus
    [io3.sch]
2024-01-23 Minor updates
    [io3.sch]
2024-01-25 UI optimized - drawing scrollable list doesn't affect playback
    [common.c, common.h, ui.c]
2024-01-27 Regenerating uri structure after HTTP header parsing failure
    [vs1003.c]
2024-01-28 New configuration generated
    [configuration.h]
2024-01-29 TCP/IP stack heap usage reduced
    [configuration.h]
2024-01-29 Number of UDP sockets and size od UDP buffers reduced to further limit usage of heap by TCPIP stack
    [configuration.h]
2024-01-29 Heap usage optimized
    [configuration.h]
2024-01-30 Global heap size and TCPIP heap size adjusted
    [configuration.h]
2024-01-30 Revert "Global heap size and TCPIP heap size adjusted"
    This reverts commit a46339f58d7ddcb966303a3ec04fbe392b766540.
    [configuration.h]
2024-01-31 PCB optimized for fabrication (in progress)
    [module_fabrication_optimized.brd, module_fabrication_optimized.sch]
2024-01-31 Project generated again, TCP heap size increased
    [configuration.h]
2024-01-31 Play stream only if socket RC buffer had been resized
2024-01-31 TCP/IP configuration changed again
    [configuration.h]
2024-02-01 Quick fix. Stream list working buffer made global static again. It needs to be refactored
    [stream_list.c]
2024-02-02 Stack size for MIIM driver task increased
    [configuration.h]
2024-02-03 DP83848 reset function moved to common.c
    [common.c]
2024-02-03 Ethernet driver configuration chamged - optimized for high trafic
    [configuration.h]
2024-02-03 TCP/IP configuration adjusted to preserve stack
    [configuration.h]
2024-02-03 Ethernet configuration restored to medium trafic setting. Multicast and broadcast packets are discarded now.
    [configuration.h]
2024-02-04 TCPIP heap size changed again. Automatic reconnect fized
    [configuration.h]
2024-02-05 TCPIP min config set
    [configuration.h]
2024-02-05 Some default settings restored
    [configuration.h]
2024-02-06 nbns added, heap resized, more sockets
    [configuration.h]
2024-02-06 Stacks of TCP/IP related tasks increased
    [configuration.h]
2024-02-06 NBNS disabled once again
    [configuration.h]
2024-02-06 UI stream list fixed
    [ui.c]
2024-02-07 HTTP server active again, TCP and UDP debug info active
    [configuration.h]
2024-02-08 ICMP server active again. App task priority set to 2.
    [configuration.h]
2024-02-11 HTTP dinamic variables print bug fixed - dynamic buffer had been claimed but never freed in some situations
    [configuration.h]
2024-02-12 Heap settings changed. TCPIP stack uses external heap.
    [configuration.h]
2024-02-16 Memory allocation bug fixed
    [http_header_parser.c]
2024-02-16 Multicast packets activated again
    [configuration.h]
2024-02-16 NBNS activated again
    [configuration.h]
2024-08-25 Backlight line logic reversed
    [hd44780.c]
2024-08-25 IO PCB updated - no buffer
    [io3.brd, io3.sch]
2024-08-25 VS1053 version of main board added
    [module_vs1003.brd, module_vs1003.sch, module_vs1053.brd, module_vs1053.sch]
2024-08-25 VS1053 version updated
    [module_vs1053.brd, module_vs1053.sch]
2024-08-29 PCB updated
    [module_vs1053.brd, module_vs1053.sch]
2024-09-08 I2C enabled
2024-09-09 Changes in PCB design allowing us to use bug free I2C1 instead of buggy I2C3
    [io3.brd, io3.sch, module_vs1003.brd, module_vs1003.sch, module_vs1053.brd, module_vs1053.sch]
2024-09-09 Changes to prepare project for analog radio funcionality
    [module_vs1053.brd, module_vs1053.sch]
2024-09-09 PCB broken line fixed
    [module_vs1053.brd, module_vs1053.sch]
2024-09-09 Consistency problem removed
    [module_vs1053.sch]
2024-09-09 Board optimized for SDR (work in progress)
    [module_vs1053.brd, module_vs1053.sch]
2024-09-09 Minor updates in PCB design
    [module_vs1053.brd]
2024-09-09 ADC (work in progress)
    [module_vs1053.brd, module_vs1053.sch]
2024-09-09 Line input added
    [module_vs1053.brd, module_vs1053.sch]
2024-09-14 RF board added
    [rf_board.brd, rf_board.sch]
2024-09-14 RF board update
    [rf_board.brd, rf_board.sch]
2024-10-06 RF board updated
    [rf_board.brd, rf_board.sch]
2024-10-06 Integrating VS1053 ADC support (work in progress)
2024-11-04 VS1003 replaced with VS1053. References to old hardware removed. Old codec no longer supported.
    [app.c, http_header_parser.c, i2c.c, mediainfo.c, mediainfo.h, ringbuffer.c, ringbuffer.h]
2024-11-04 Porting si4735 driver (work in progress)
2024-11-04 VS1003 version of mainboard removed due to dropped support for this codec
    [module_vs1003.brd, module_vs1003.sch]
2024-11-04 Alternate power connector added
    [module_vs1053.brd, module_vs1053.sch]
2025-08-05 Direct FatFS calls replaced with harmony SYS_FS wrappers
    [common.c, main_list.c]
2025-08-06 Problem with playing directories fixed
    [dir_list.c, vs1053.c]
2025-08-10 Dir list alignment issue fix
    [dir_list.c, scrollable_list.c]
2025-08-10 Difeerent speed of rotary encoder
2025-08-12 Back button works in dir menu
2025-08-12 Backlight at start fixed
    [ui.c]
2025-08-16 Dir flag bug fixed
    [dir_list.c, ui.c, vs1053.c, vs1053.h]
2025-08-19 Each case in VS1053_handle function moved to separate scope. Stack preserved by moving local variables there.
2025-08-19 Local variables in VS1053_handle moved to case scopes
2025-08-20 Ringbuffer implementation corrected. Changes in handling consecutive file read errors dduring play
    [ringbuffer.c, ringbuffer.h, vs1053.c]
2025-08-21 Task starvation bug fixed
    [tasks.c, vs1053.c, vs1053_low_level.c]
2025-08-21 Log print with reset source added
    [app.c]
2025-08-24 Task priorities changed to avoid network starvation
    [configuration.h]
2025-09-12 Porting radio driver from C++ to plain C (work in progress)
2025-10-22 wolfMQTT added, separate task removed
    [configuration.h]
2025-10-22 Trying to port original C++ Arduino radio library (work in progress)
2025-11-20 HTTP headers parser issue fixed
    [http_header_parser.c]
2026-06-11 si4735 driver compiles now
2026-06-27 I2C driver for radio
2026-06-27 Revert "Porting radio driver from C++ to plain C (work in progress)"
    This reverts commit aff1e5b264c08f7b458220590ac0891d2482dfb2.
    [si4735.c, si4735.h]
