marekw1986/InternetRadioPIC32DP83848/(notices)

Notices in the files:
parts and their libraries:
SparkFun-Clocks: Licensing: Creative Commons ShareAlike 4.0 International - https://creativecommons.org/licenses/by-sa/4.0
